Geheimorganisation/geheimbadge-hardware/assets/images/b2.png

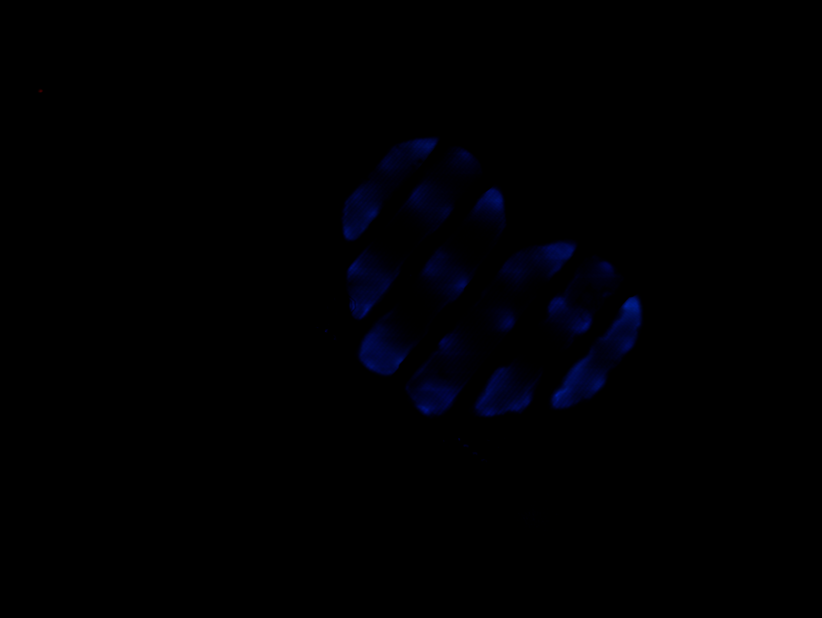
assets/images/b2.png
