Geheimorganisation/geheimbadge-hardware/assets/images/b6.png

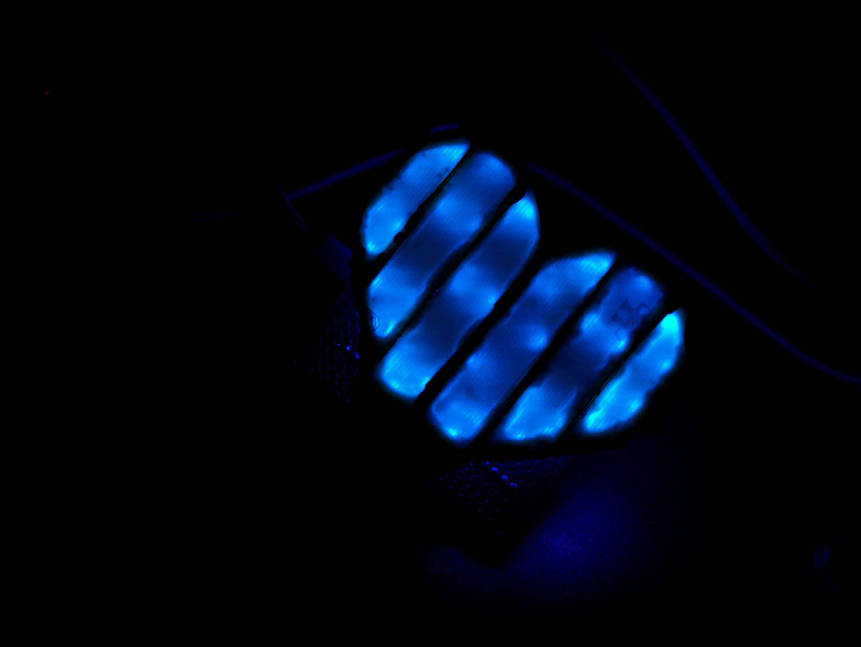
assets/images/b6.png
