Geheimorganisation/geheimbadge-hardware/assets/images/b7.png

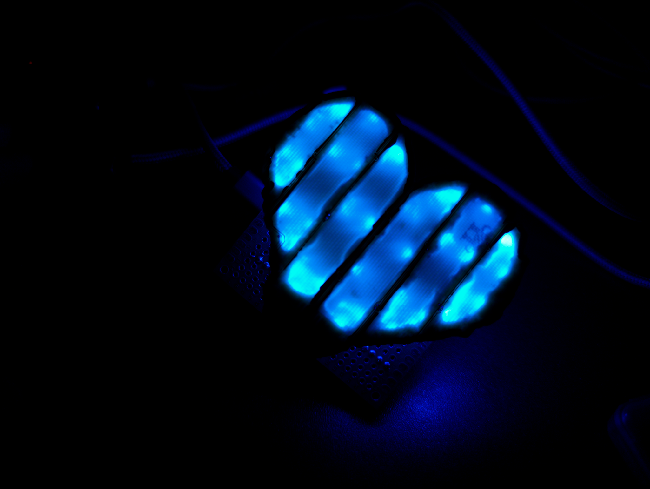
assets/images/b7.png
