Geheimorganisation/geheimbadge-hardware/assets/images/b8.png

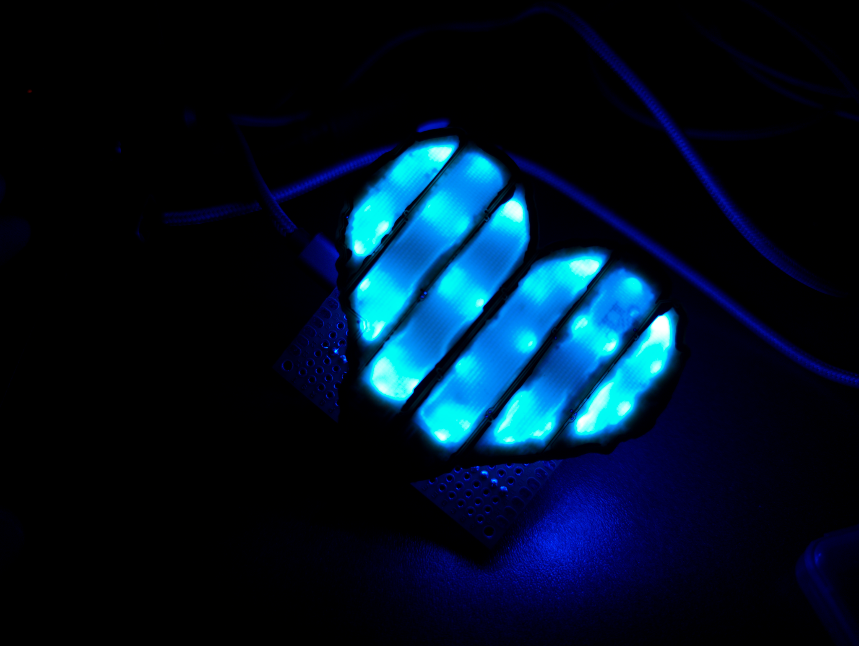
assets/images/b8.png
