Geheimorganisation/geheimbadge-hardware/assets/images/g1.png

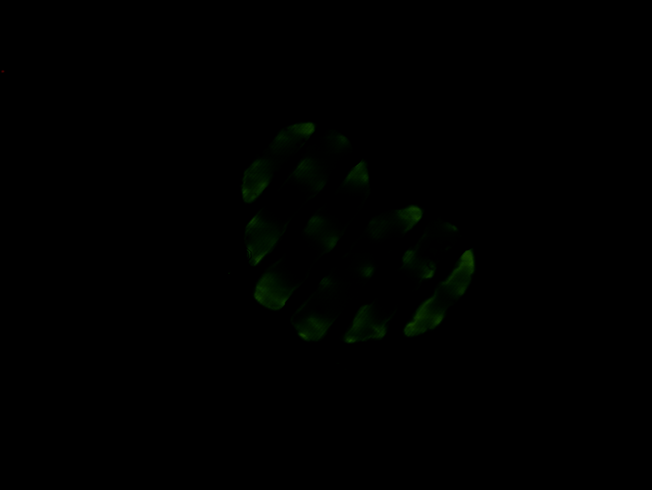
assets/images/g1.png
