Geheimorganisation/geheimbadge-hardware/assets/images/g4.png

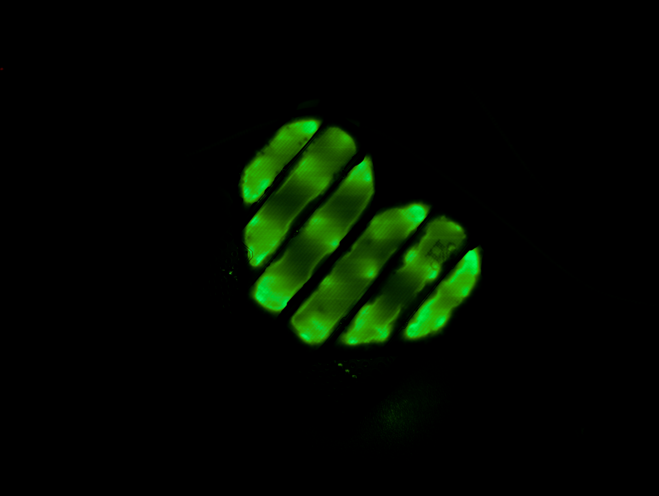
assets/images/g4.png
