Geheimorganisation/geheimbadge-hardware/assets/images/g6.png

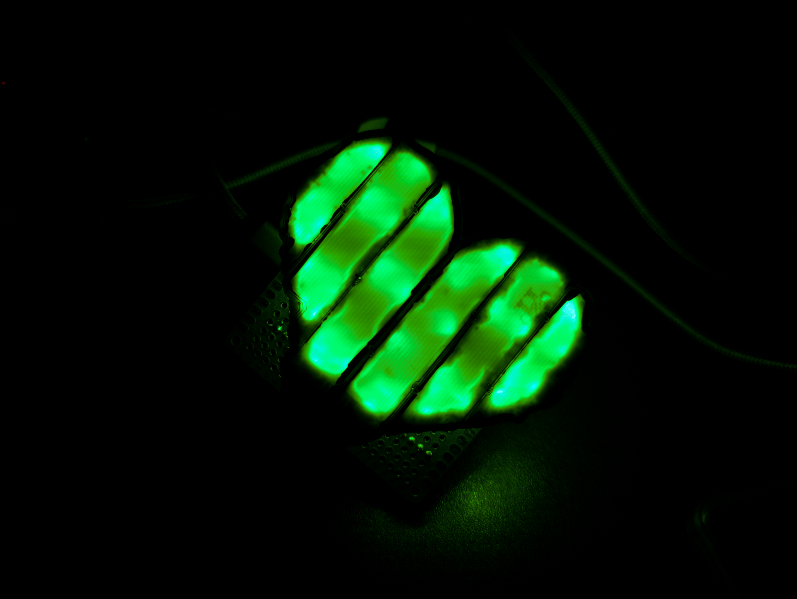
assets/images/g6.png
