Geheimorganisation/geheimbadge-hardware/assets/images/g7.png

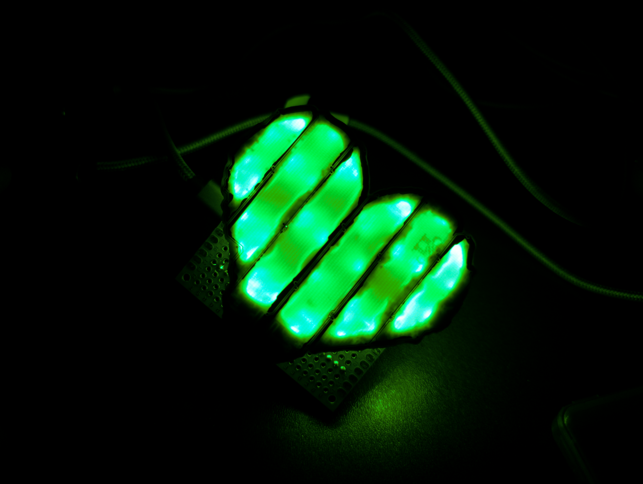
assets/images/g7.png
