Geheimorganisation/geheimbadge-hardware/assets/images/r3.png

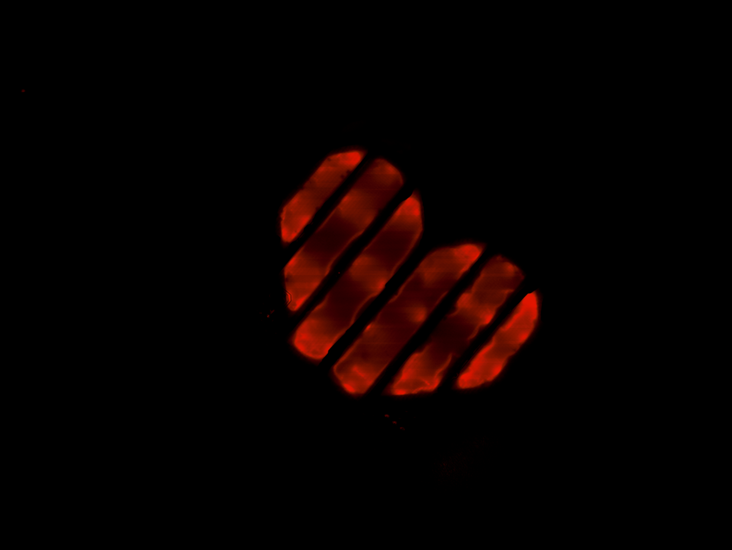
assets/images/r3.png
