Geheimorganisation/geheimbadge-hardware/assets/images/r5.png

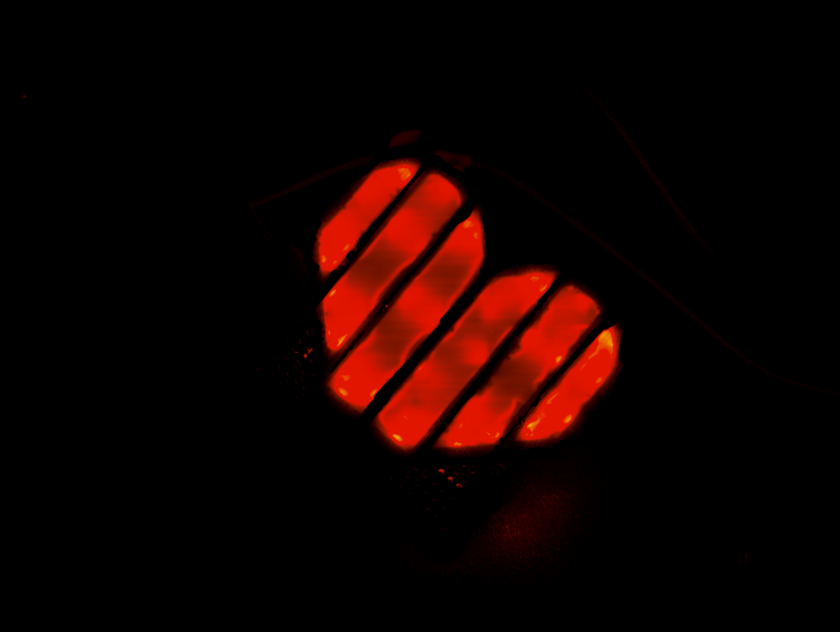
assets/images/r5.png
