Geheimorganisation/geheimbadge-hardware/assets/images/r6.png

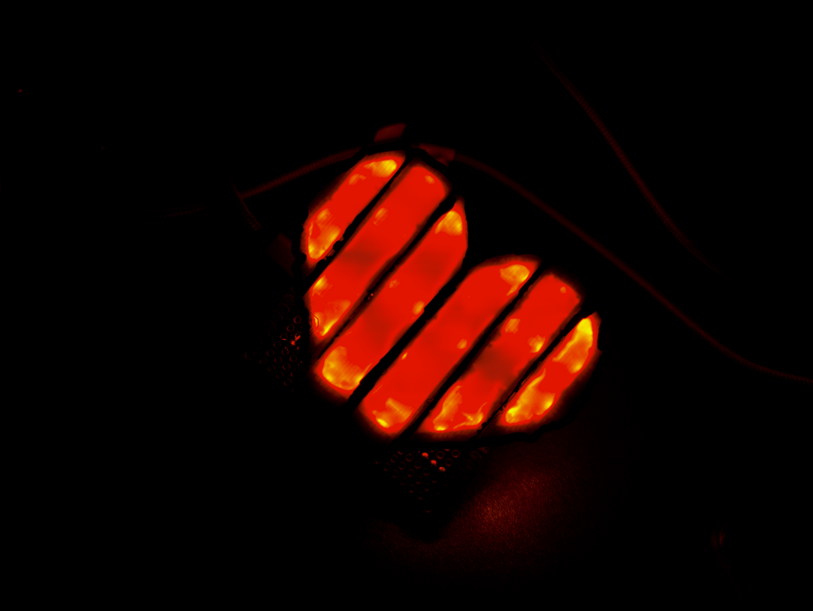
assets/images/r6.png
