Geheimorganisation/geheimbadge-hardware/assets/images/r7.png

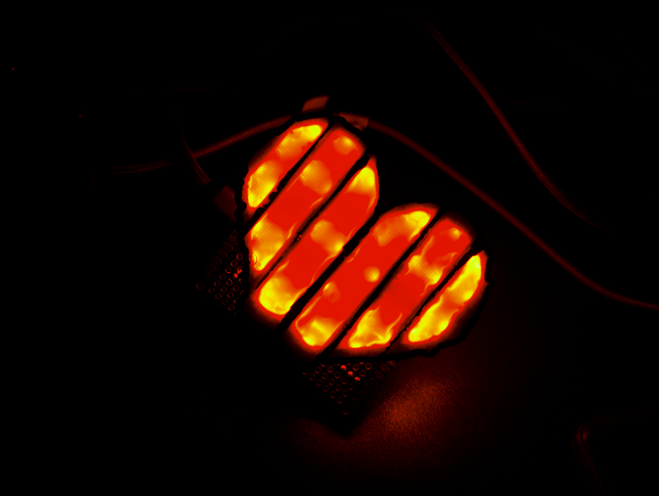
assets/images/r7.png
