Geheimorganisation/geheimbadge-hardware/assets/images/r8.png

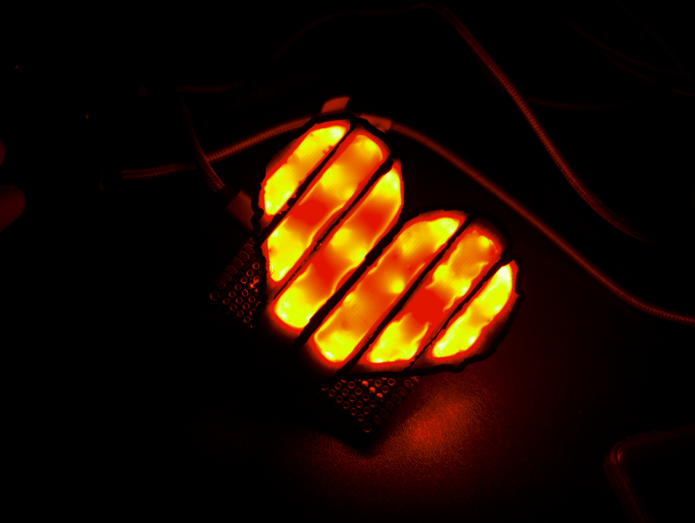
assets/images/r8.png
