Geheimorganisation/geheimbadge-hardware/production/bom/geheimbadge.csv

Designator | Footprint | Quantity | Value | LCSC Part #
J1 | Connector_IDC:IDC-Header_2x03_P2.54mm_Vertical_SMD | 1 | SAOv2 | C4749176
C1,C2,C3,C4,C5,C6,C7,C8,C9,C10,C11,C12,C13,C14,C15,C16,C17,C18,C19,C20,C21,C22,C23,C24,C25,C26,C27,C28,C29,C30,C31,C32,C33,C34,C35,C36,C37,C38 | Capacitor_SMD:C_0402_1005Metric | 38 | 100n | C1525
D1,D2,D3,D4,D5,D6,D7,D8,D9,D10,D11,D12,D13,D14,D15,D16,D17,D18,D19,D20,D21,D22,D23,D24,D25,D26,D27,D28,D29,D30,D31,D32,D33,D34,D35,D36,D37,D38 | LED_SMD-project:LED-SMD_4P-L4.0-W1.6-L | 38 | SK6812SIDE | C5378721
