Geheimorganisation/geheimbadge-hardware/assets/3D models/shell.stl

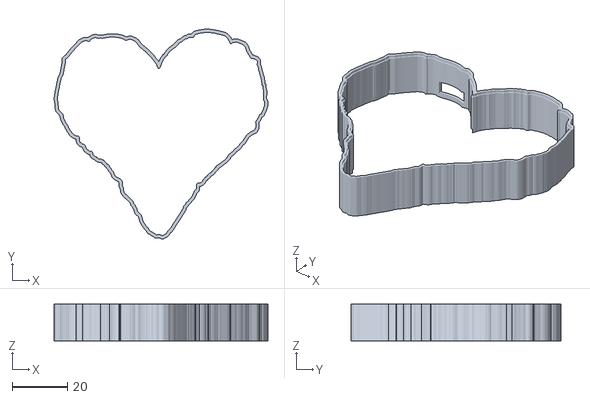
[picture p14: CAD file, 2024-12-30]
assets/3D models/shell.stl
77.5 x 76.1 x 13.4
