Geheimorganisation/geheimbadge-hardware/source/geheimbadge-controller/mask.dxf

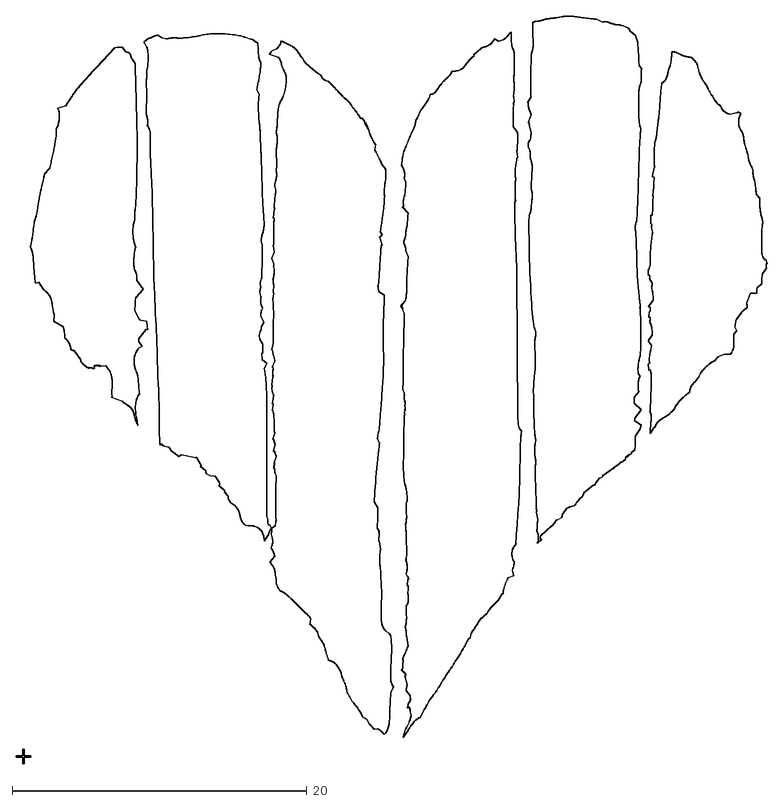
[picture p15: CAD file, 2023-10-01]
source/geheimbadge-controller/mask.dxf
51.0 x 50.8
