Geheimorganisation/geheimbadge-hardware/assets/3D models/LED-SMD_4P-L4.0-W1.6-L.obj

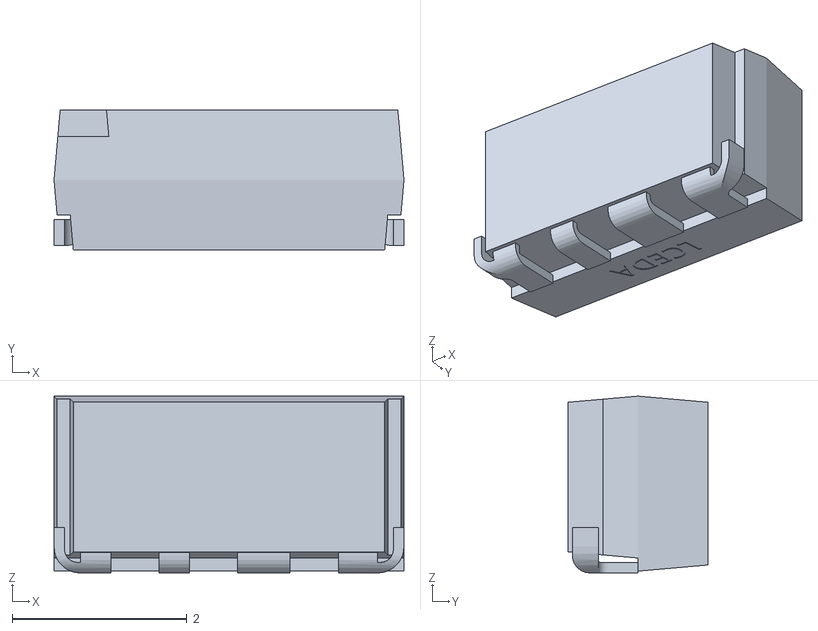
[picture p16: CAD file, 2023-10-01]
assets/3D models/LED-SMD_4P-L4.0-W1.6-L.obj
4.00 x 1.60 x 2.02
