Geheimorganisation/geheimbadge-hardware/source/geheimbadge-controller/outline.dxf

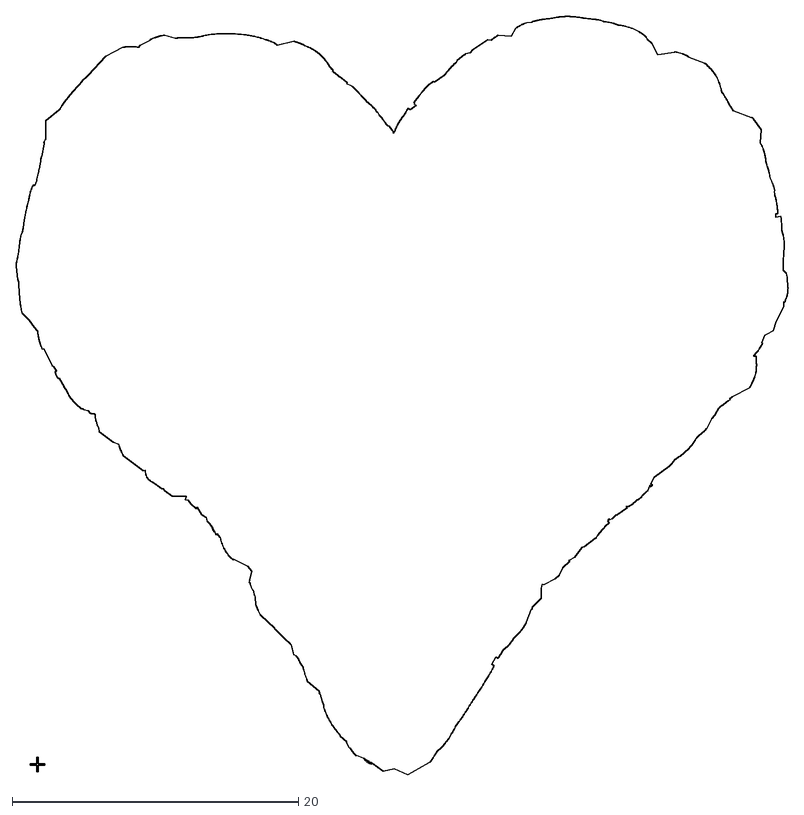
[picture p17: CAD file, 2023-10-01]
source/geheimbadge-controller/outline.dxf
53.9 x 53.0
