Geheimorganisation/geheimbadge-hardware/exports/plots/geheimbadge-controller-pcb.pdf

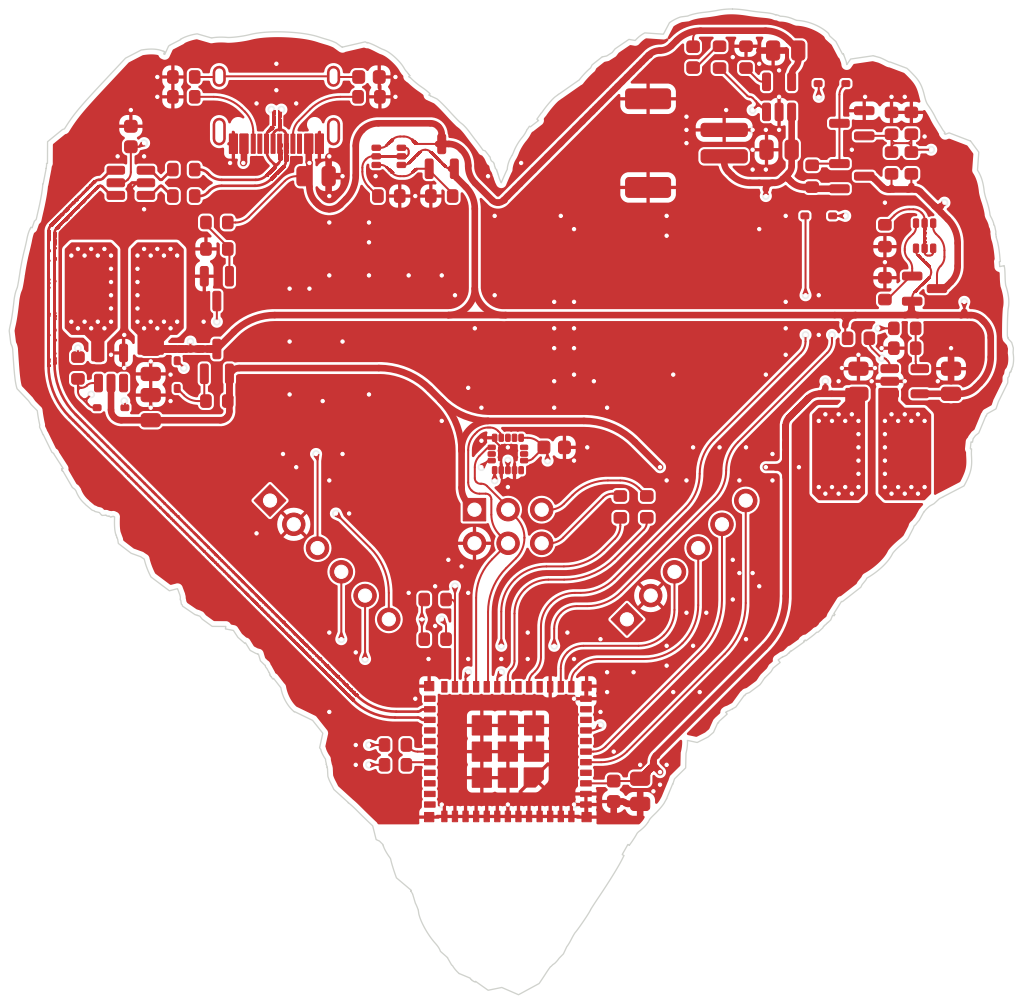
[picture p18: page 1]
D Date: KiCad; E.D.A. 8.99.0-77eaa75db1 Size: A4; Rev: 1.0.0; pid:; tba

author: marble
File: geheimbadge-controller.kicad_pcb Sheet: Geheimorganisation

Id: 1/1 Title: Geheimbadge

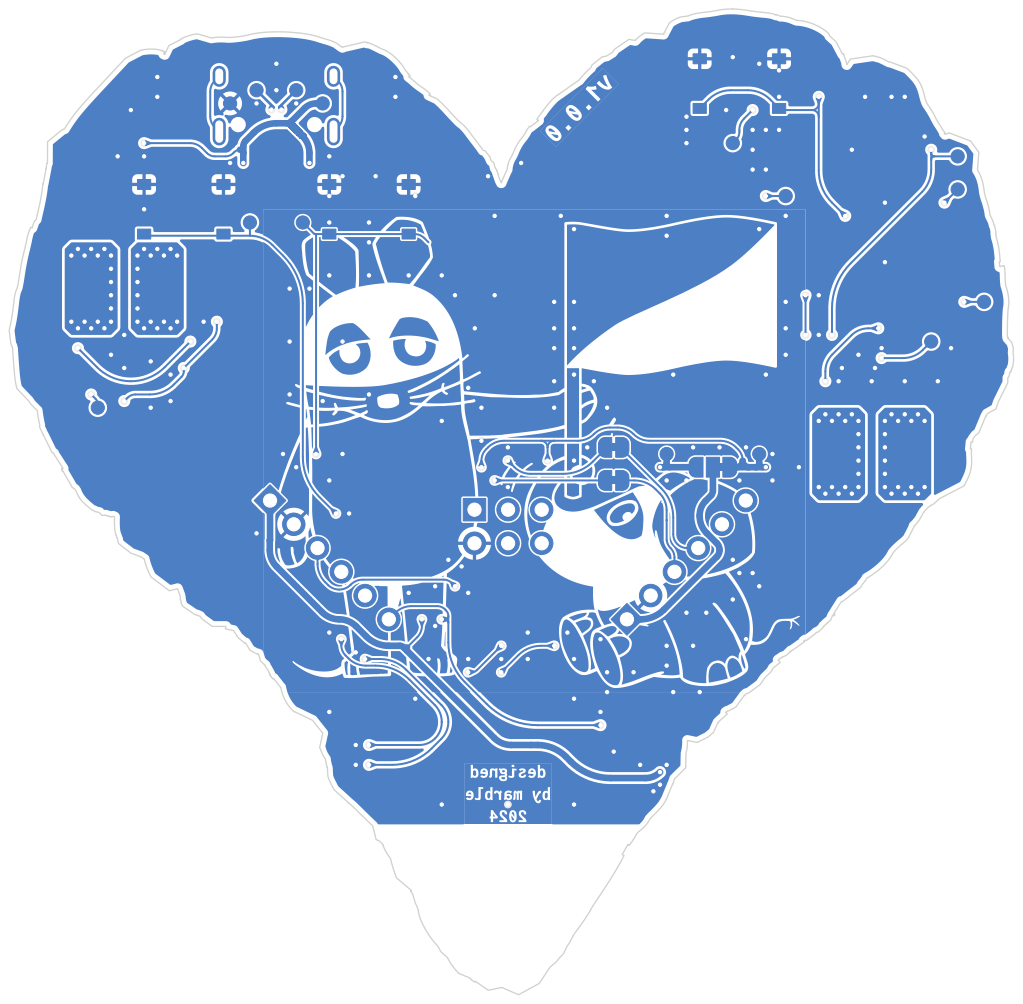
[picture p19: page 2]
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

author: marble
File: geheimbadge-controller.kicad_pcb Sheet: Geheimorganisation

Id: 1/1 Title: Geheimbadge
