Geheimorganisation/geheimbadge-hardware/exports/plots/geheimbadge-controller-sch.pdf

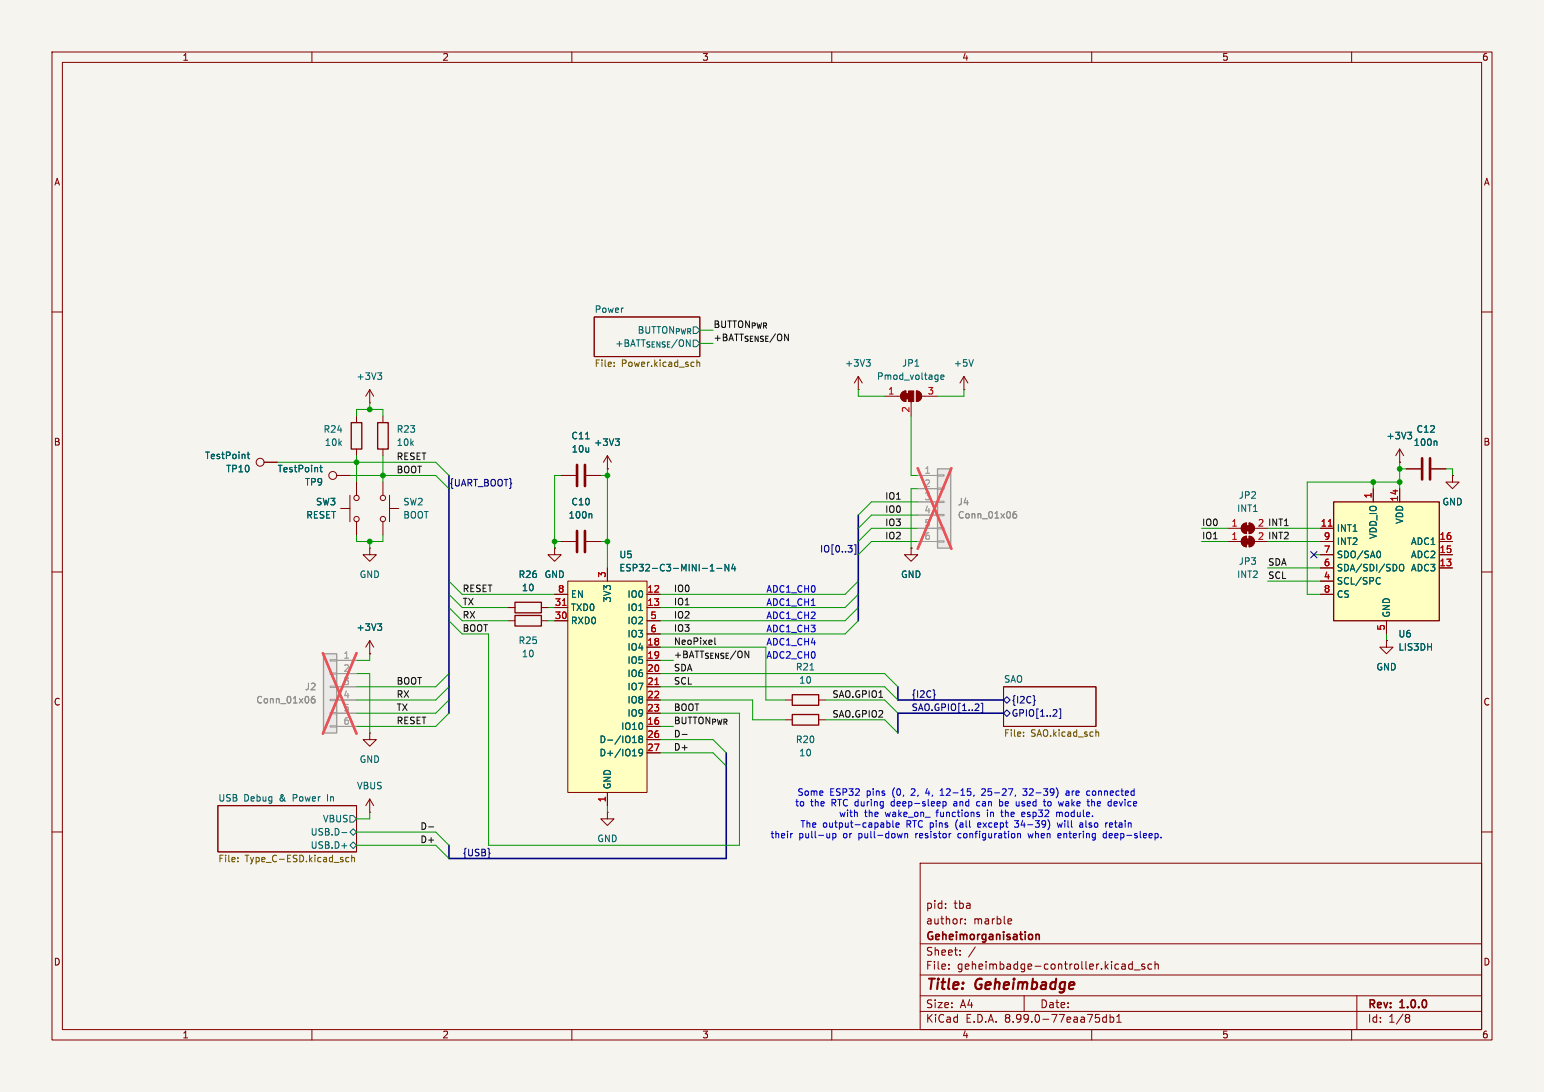
[picture p20: page 1]

5 SDA/SDI/SDO 6 SDO/SA0 7 CS 8

D+BUTTON_{PWR} SCL SDA NeoPixel TX

author: marble
File: geheimbadge-controller.kicad_sch Sheet: / Geheimorganisation

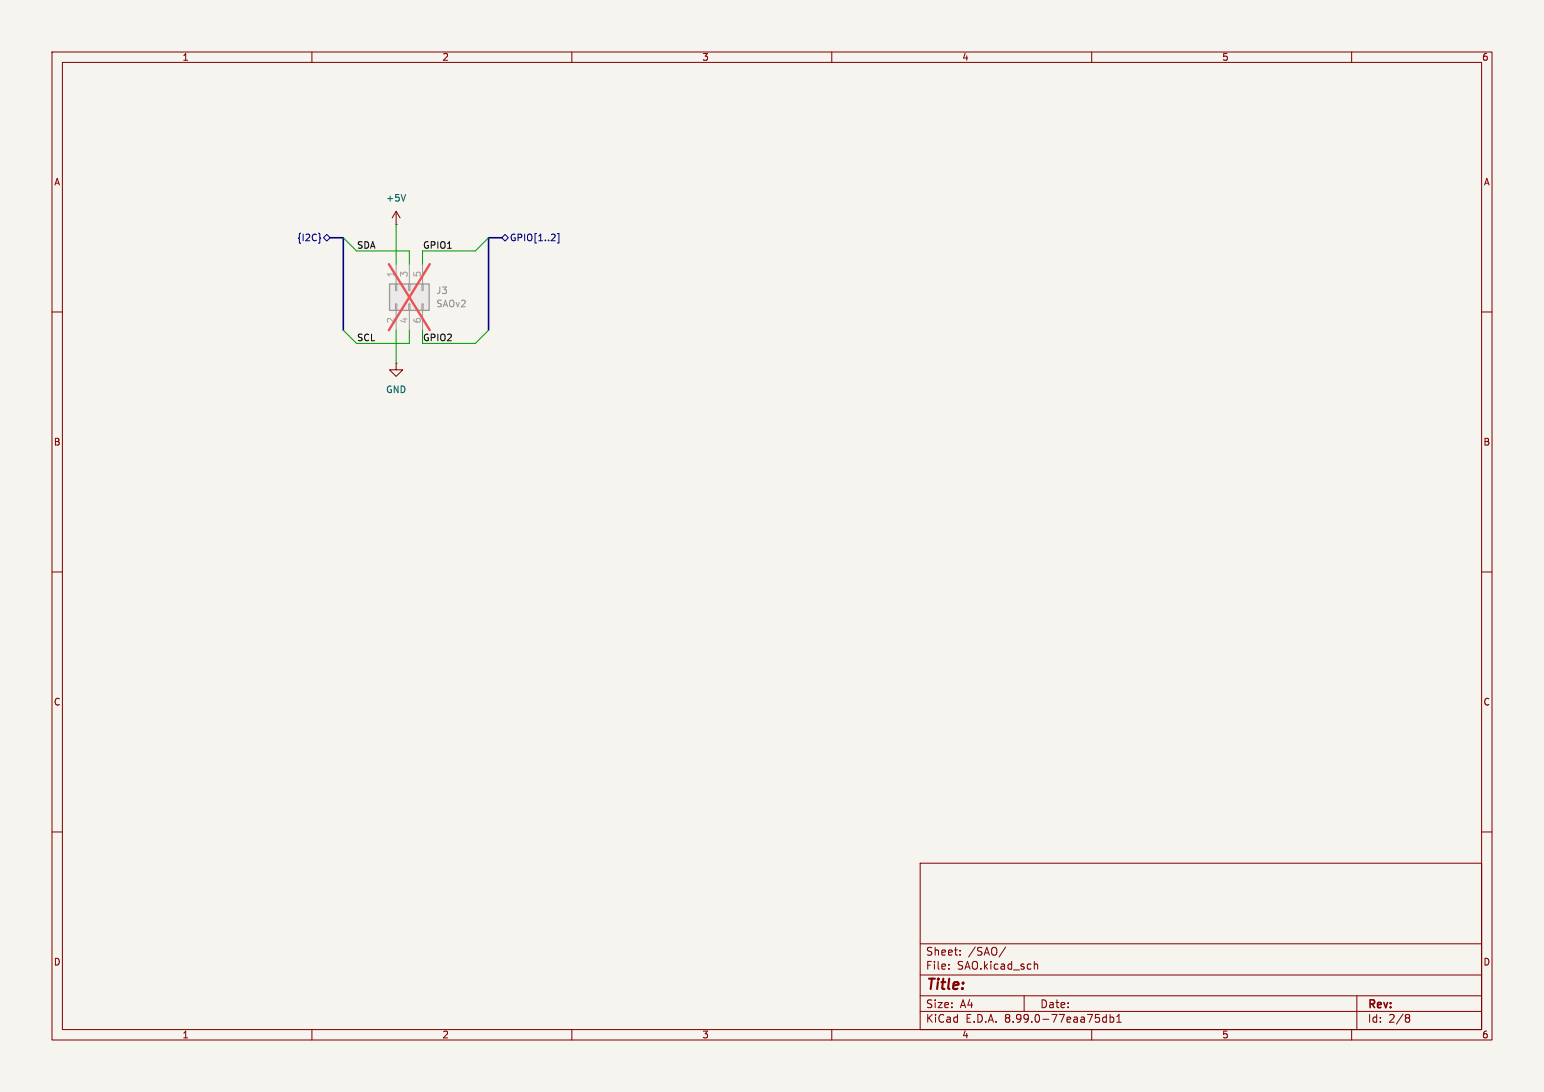
[picture p21: page 2]

Id: 2/8 Title: File: SAO.kicad_sch Sheet: /SAO/

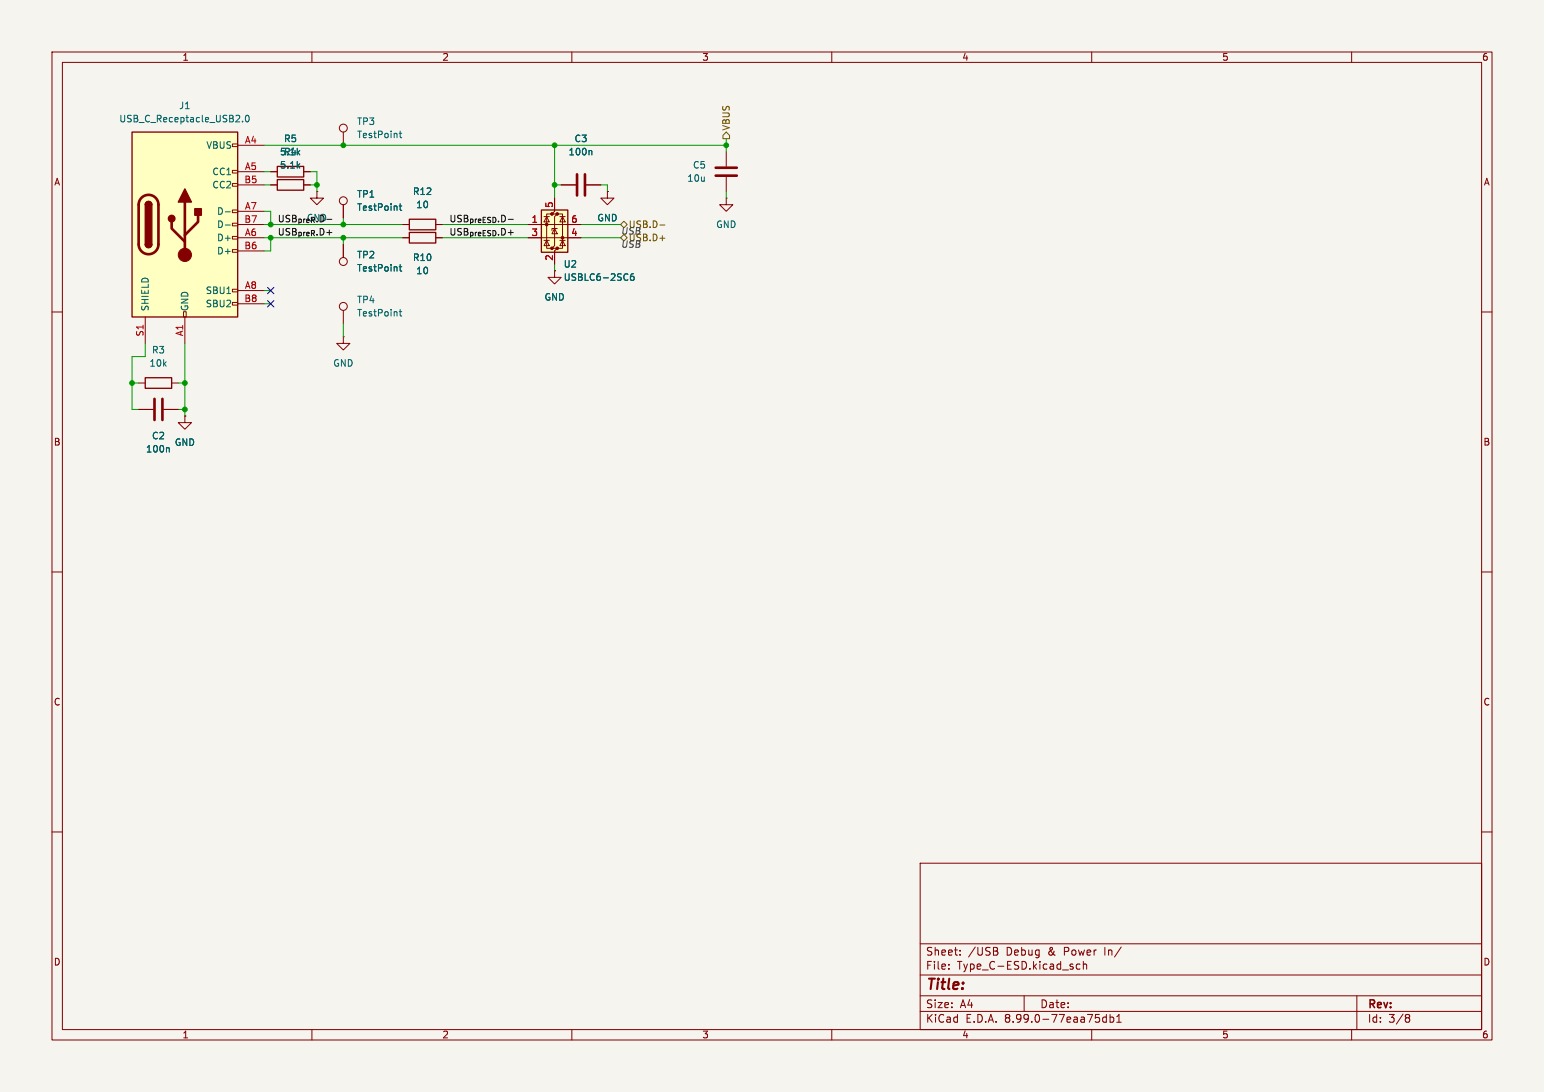
[picture p22: page 3]

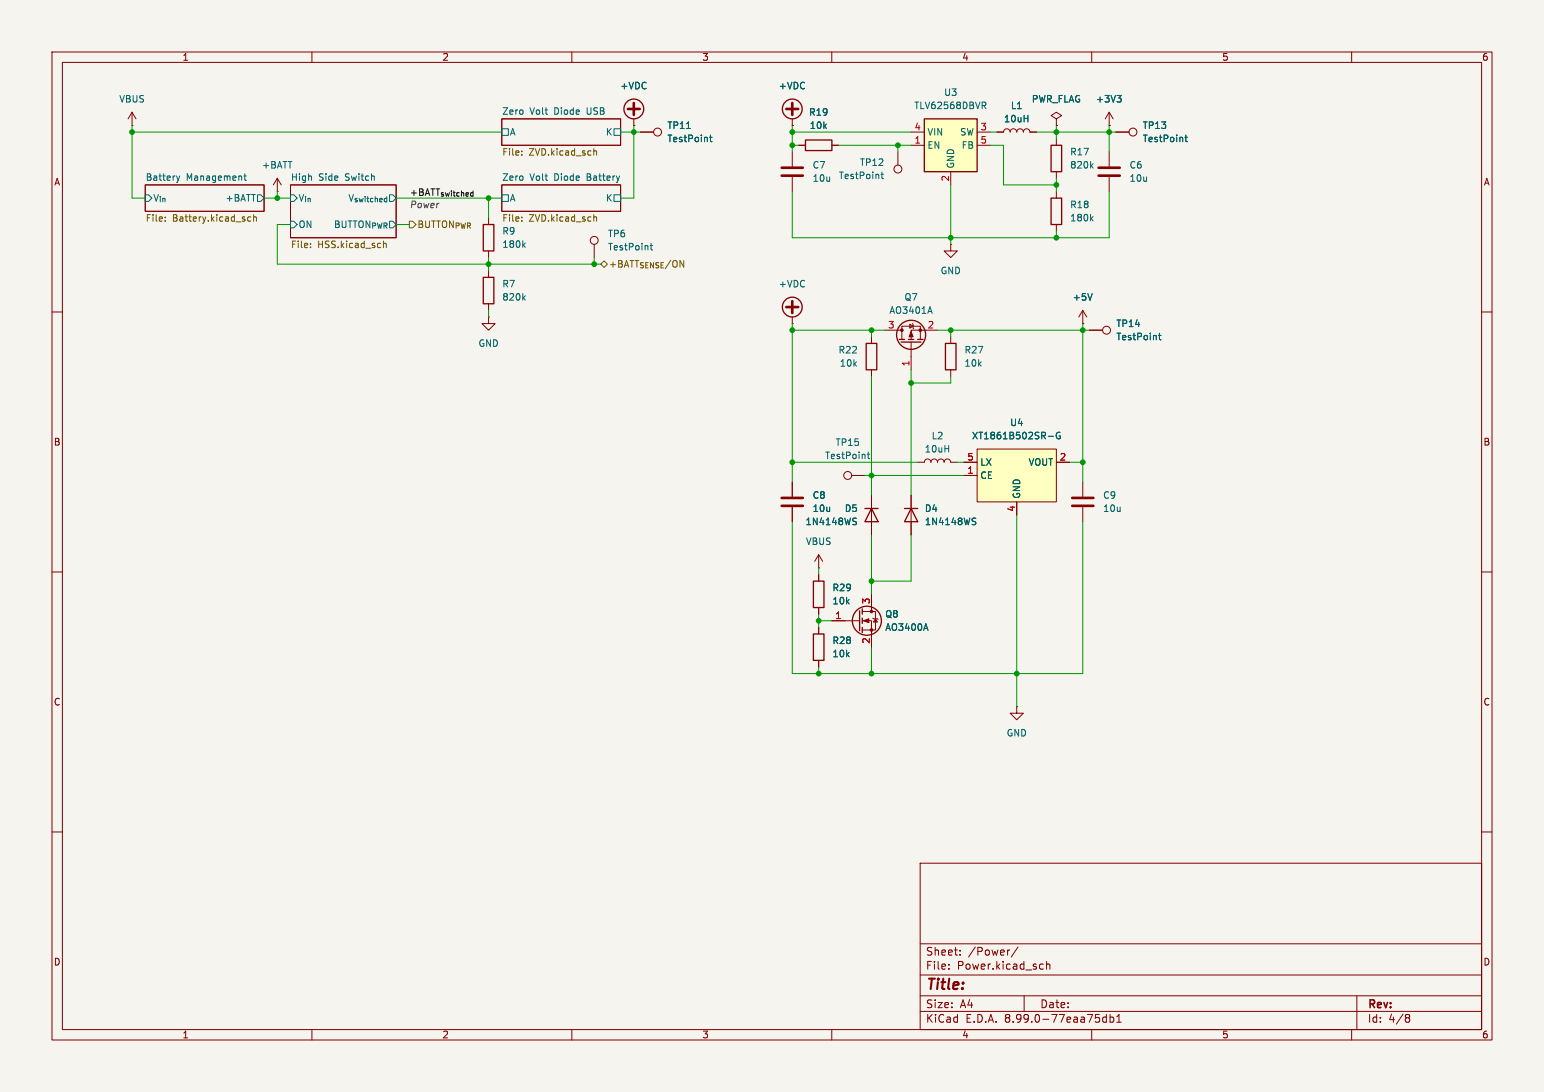
[picture p23: page 4]

Zero Volt Diode USB

Id: 4/8 Title: File: Power.kicad_sch Sheet: /Power/

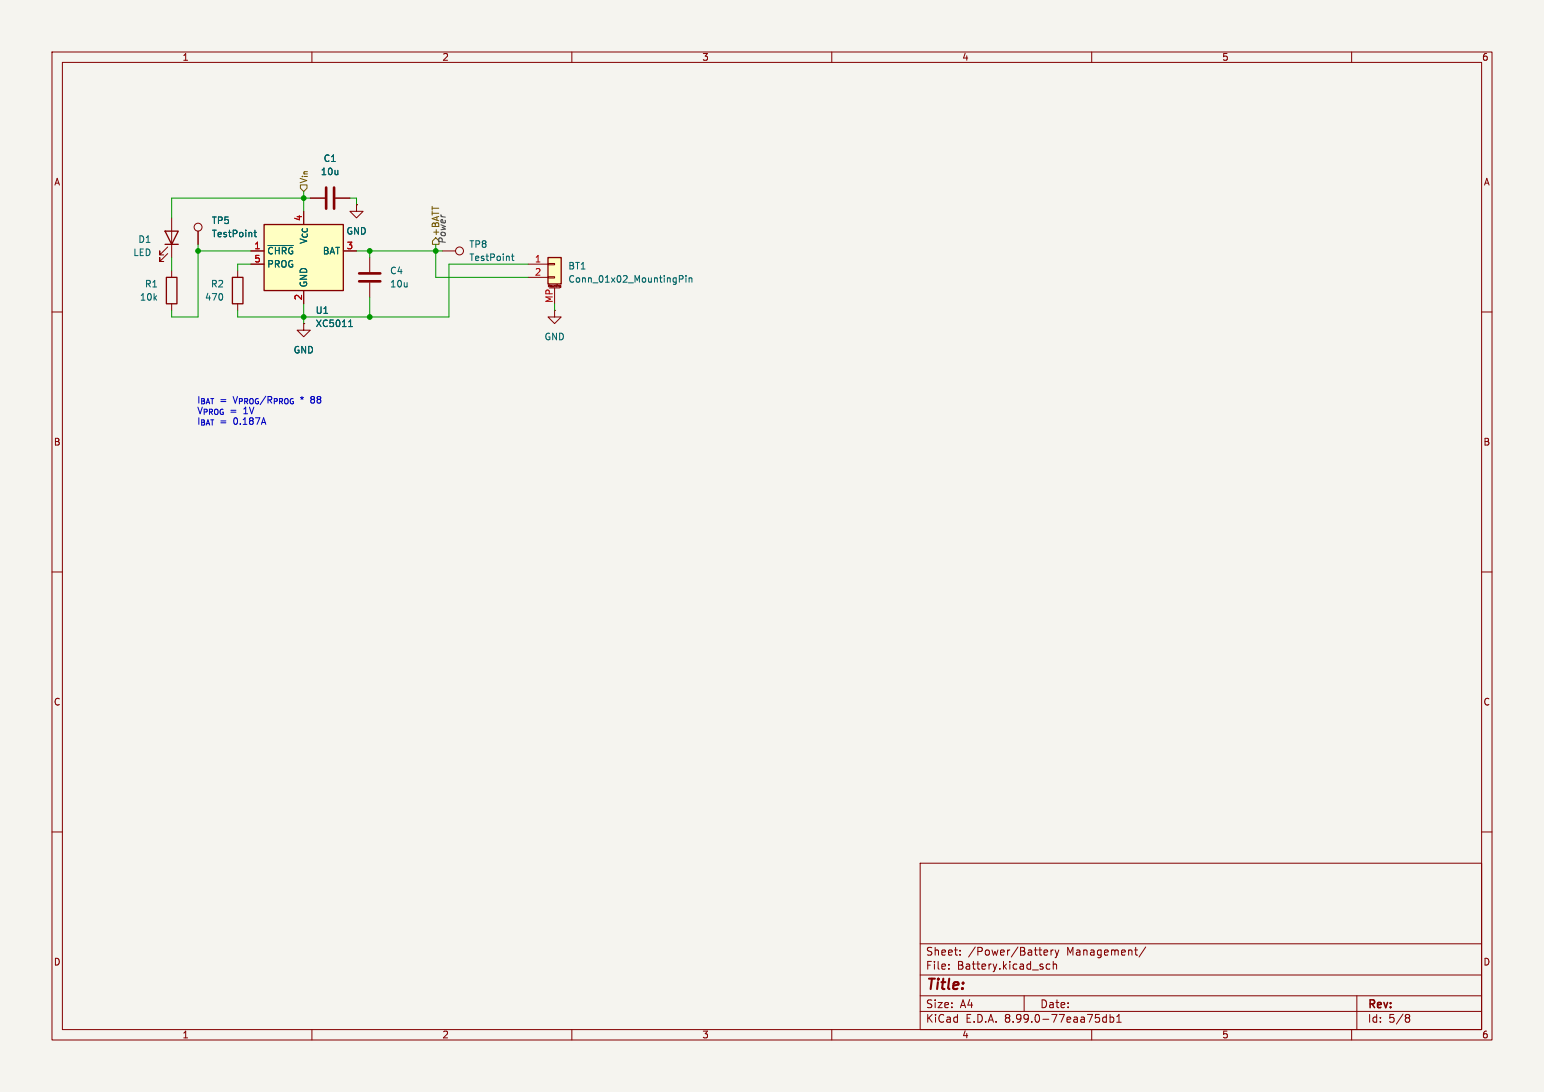
[picture p24: page 5]

2 BAT 3 V_{CC} 4 PROG 5 U1XC5011 TP8 TestPoint C4

2 BAT 3 V_{CC} 4 PROG 5 GND

I_{BAT} = V_{PROG}/R_{PROG} * 88 V_{PROG} = 1V

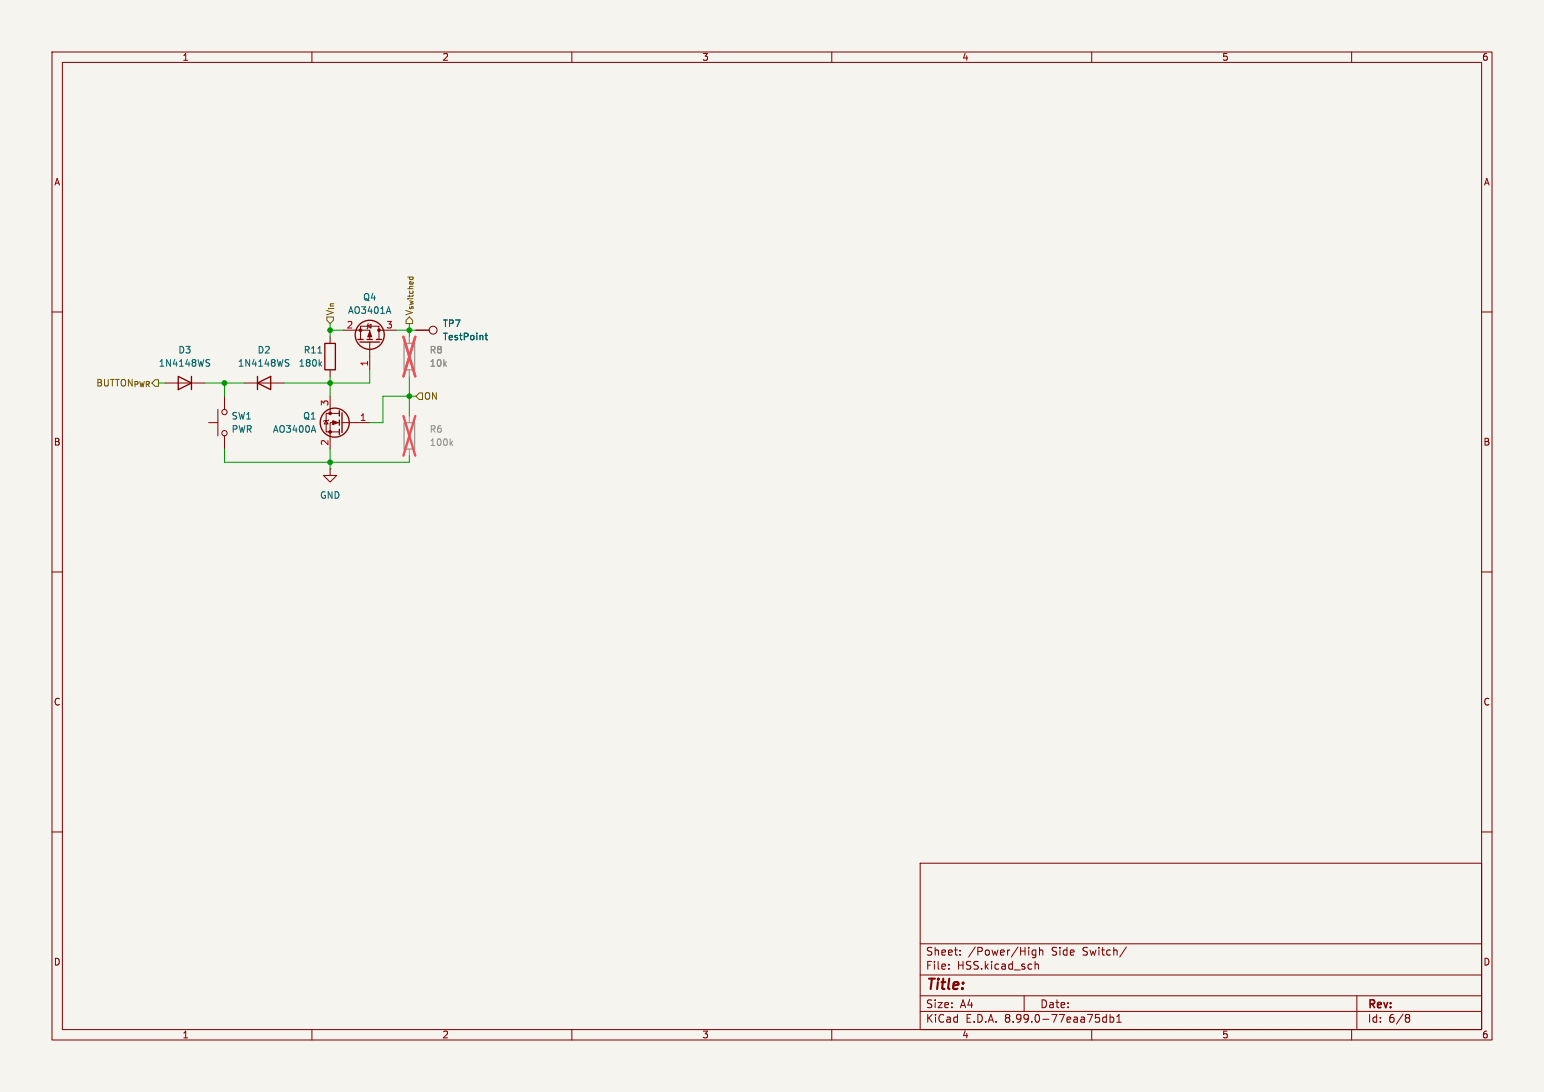
[picture p25: page 6]

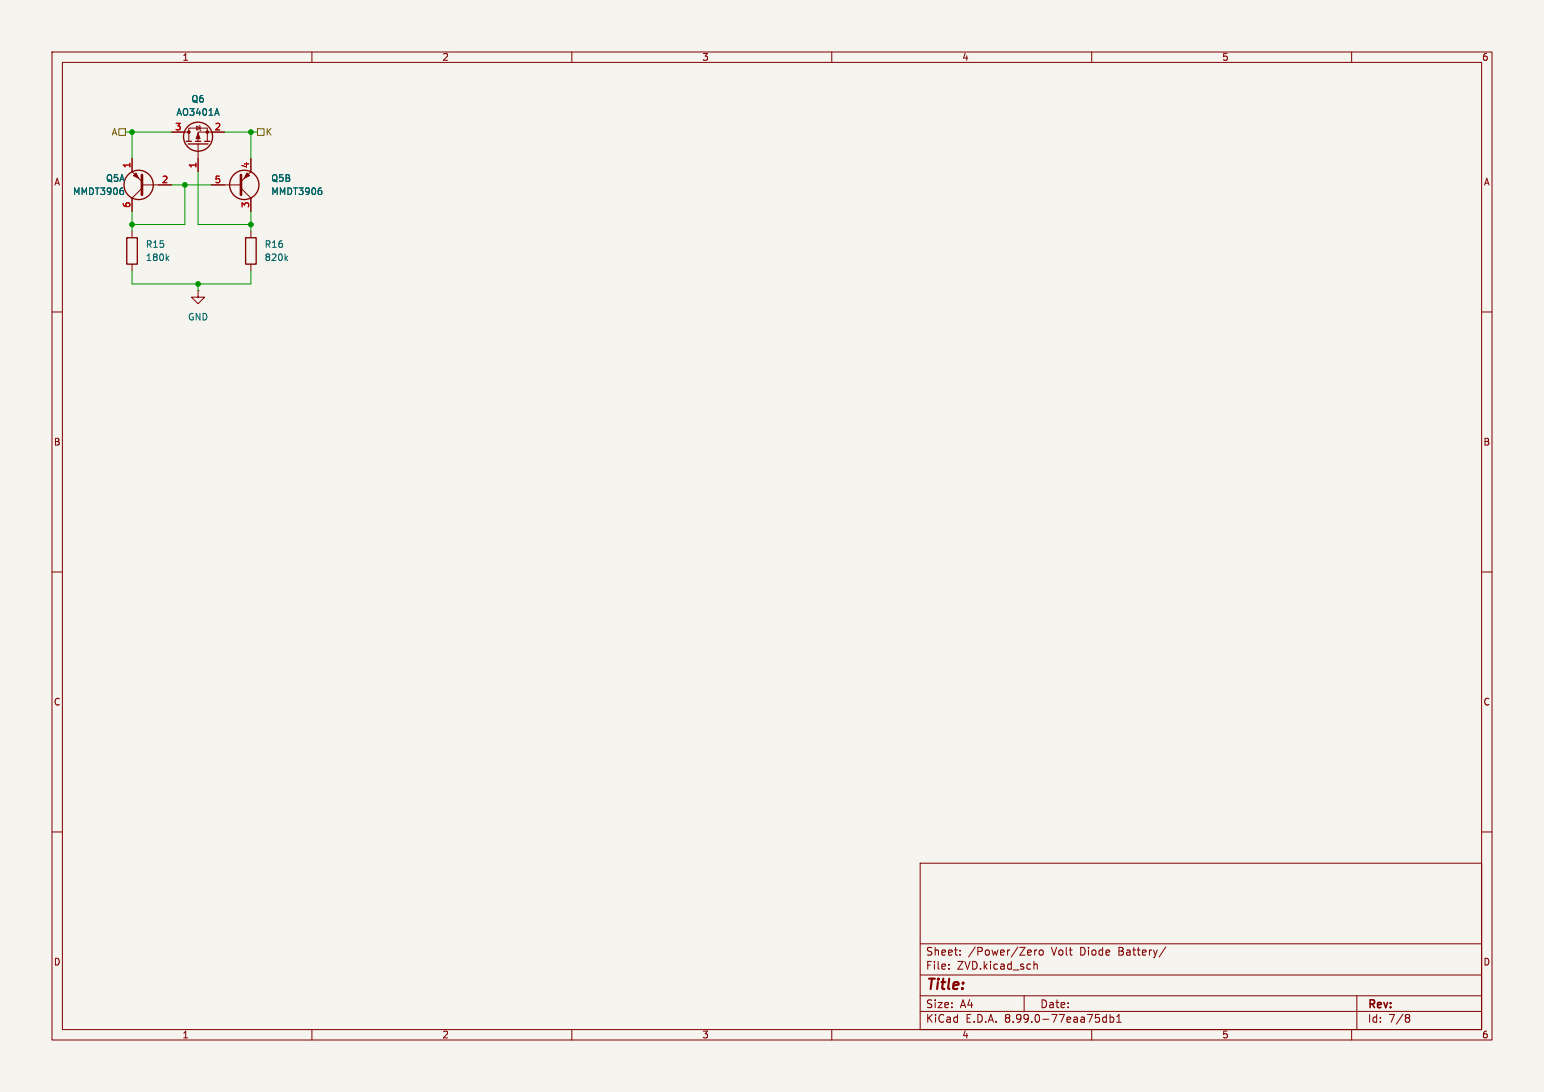
[picture p26: page 7]

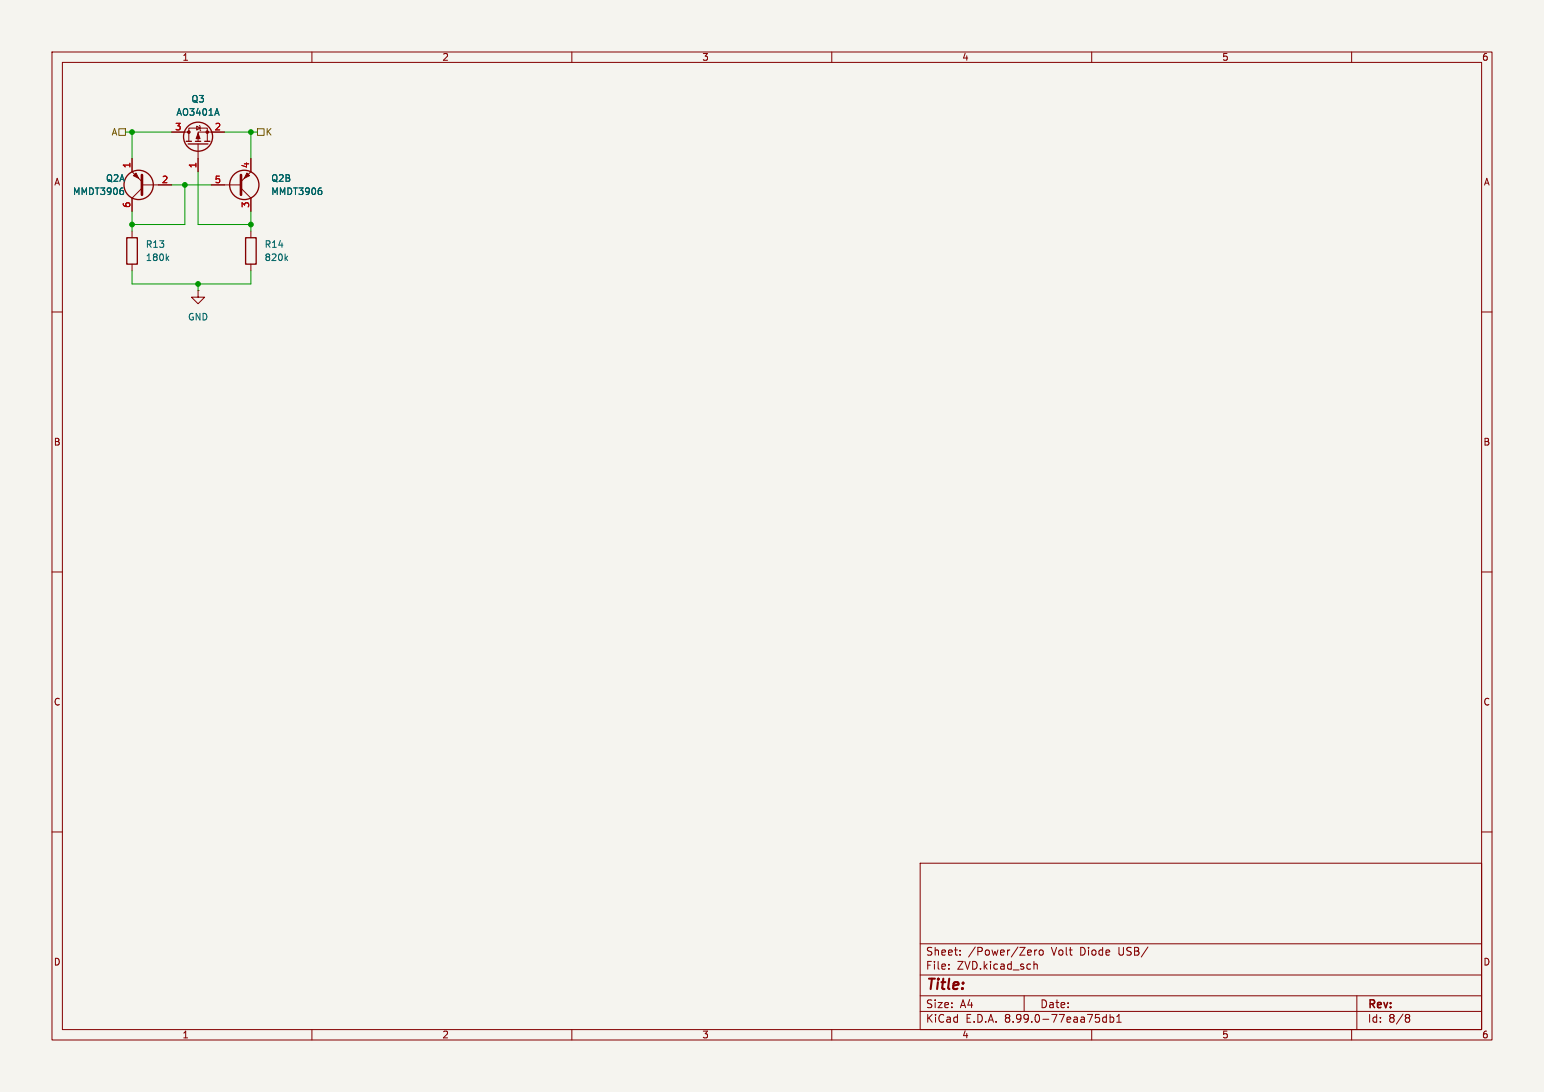
[picture p27: page 8]
