Geheimorganisation/geheimbadge-hardware/exports/plots/geheimbadge-pcb.pdf

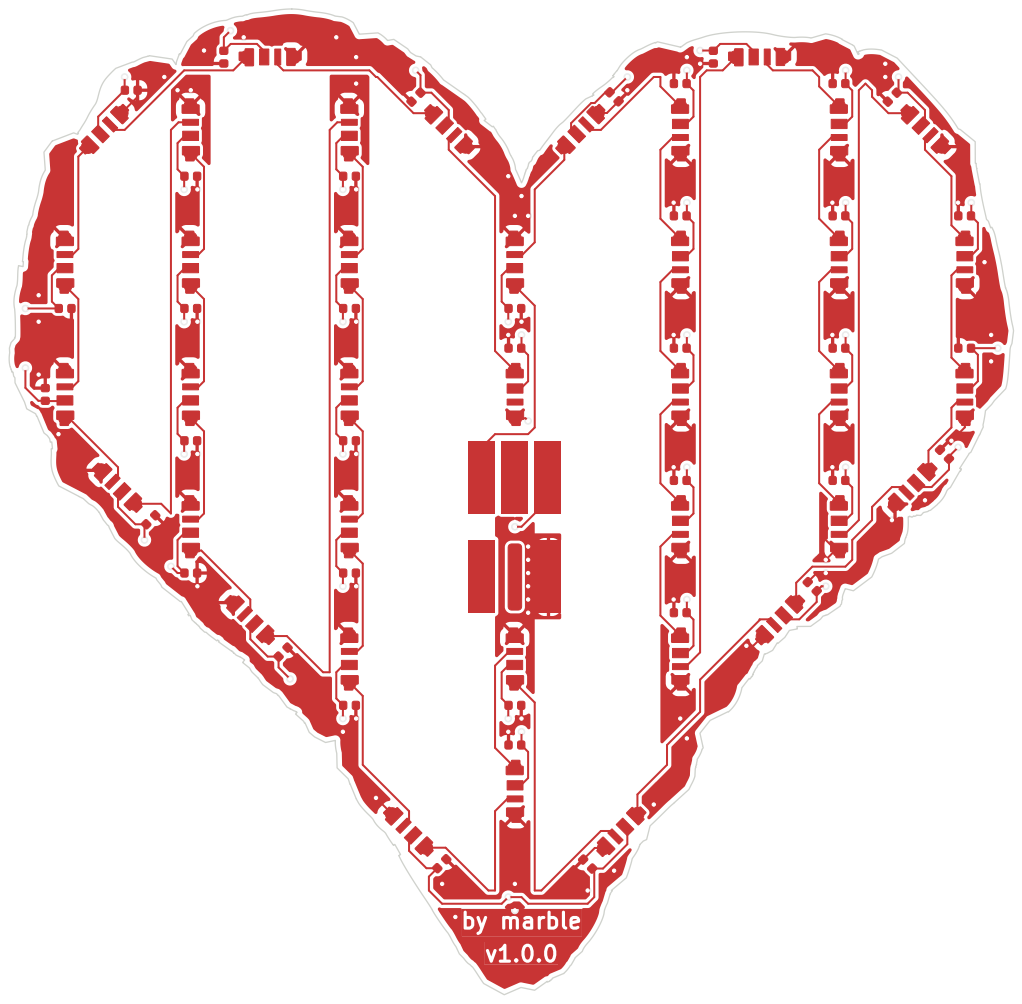
[picture p28: page 1]
D Date: KiCad; E.D.A. 8.99.0-77eaa75db1 Size: A4; Rev: 1.0.0; pid:; tba

author: marble
File: geheimbadge.kicad_pcb Sheet: Geheimorganisation

Id: 1/1 Title: Geheimbadge

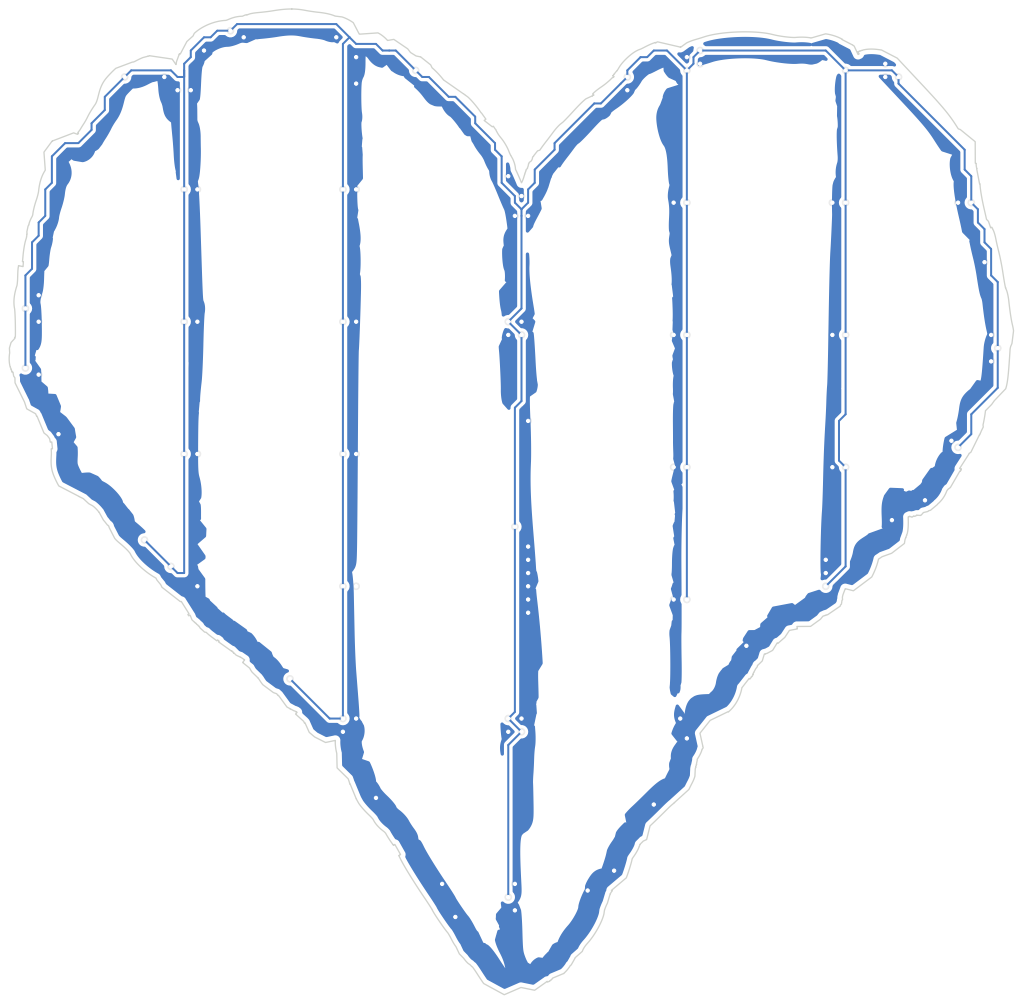
[picture p29: page 2]
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

author: marble
File: geheimbadge.kicad_pcb Sheet: Geheimorganisation

Id: 1/1 Title: Geheimbadge
