Geheimorganisation/geheimbadge-hardware/exports/plots/template-pcb.pdf

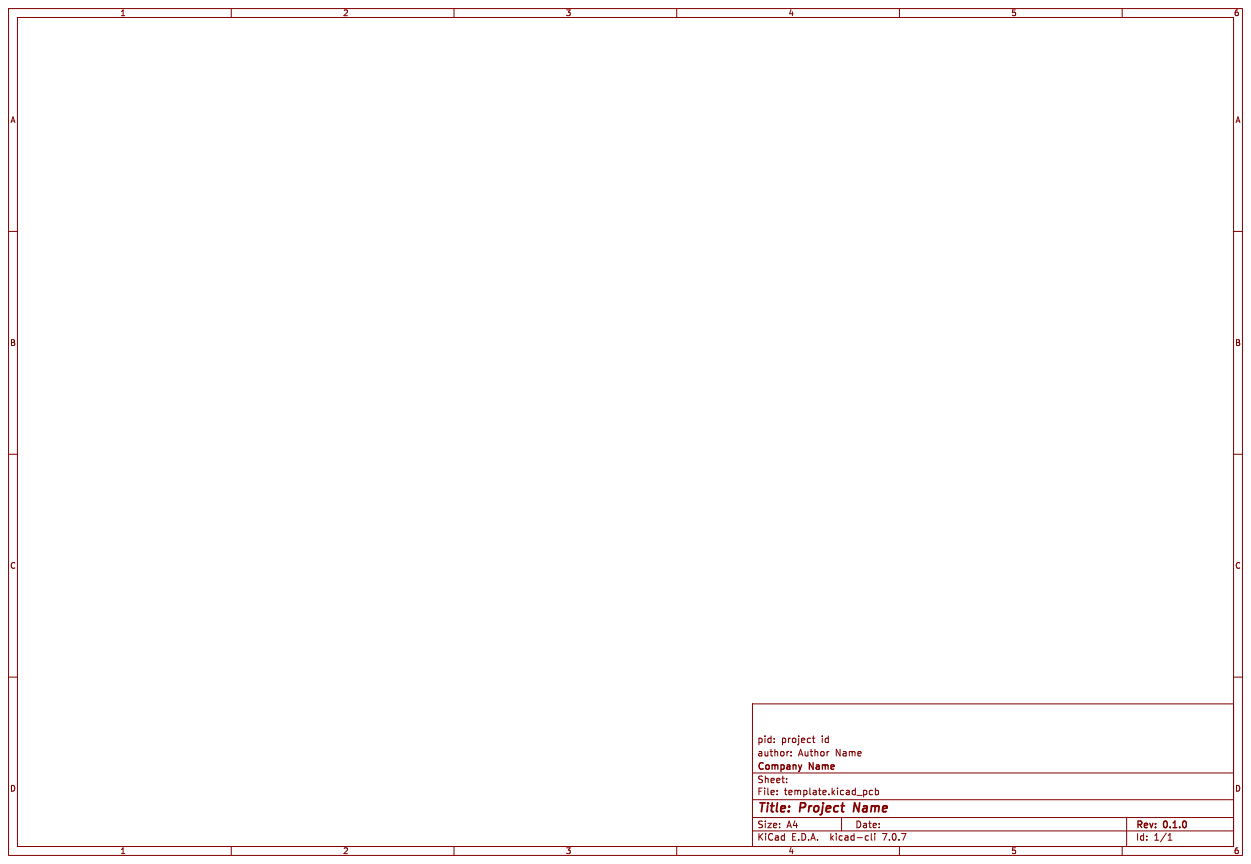
[picture p30: page 1]
D Date: KiCad; kicad-cli; 7.0.7 Size: A4; Rev: 0.1.0; File: template.kicad_pcb Sheet: Company; Name; author: Author; pid:; project id

Id: 1/1 Title: Project Name

Id: 1/1 Title: Project Name
