Geheimorganisation/geheimbadge-hardware/exports/plots/geheimbadge-sch.pdf

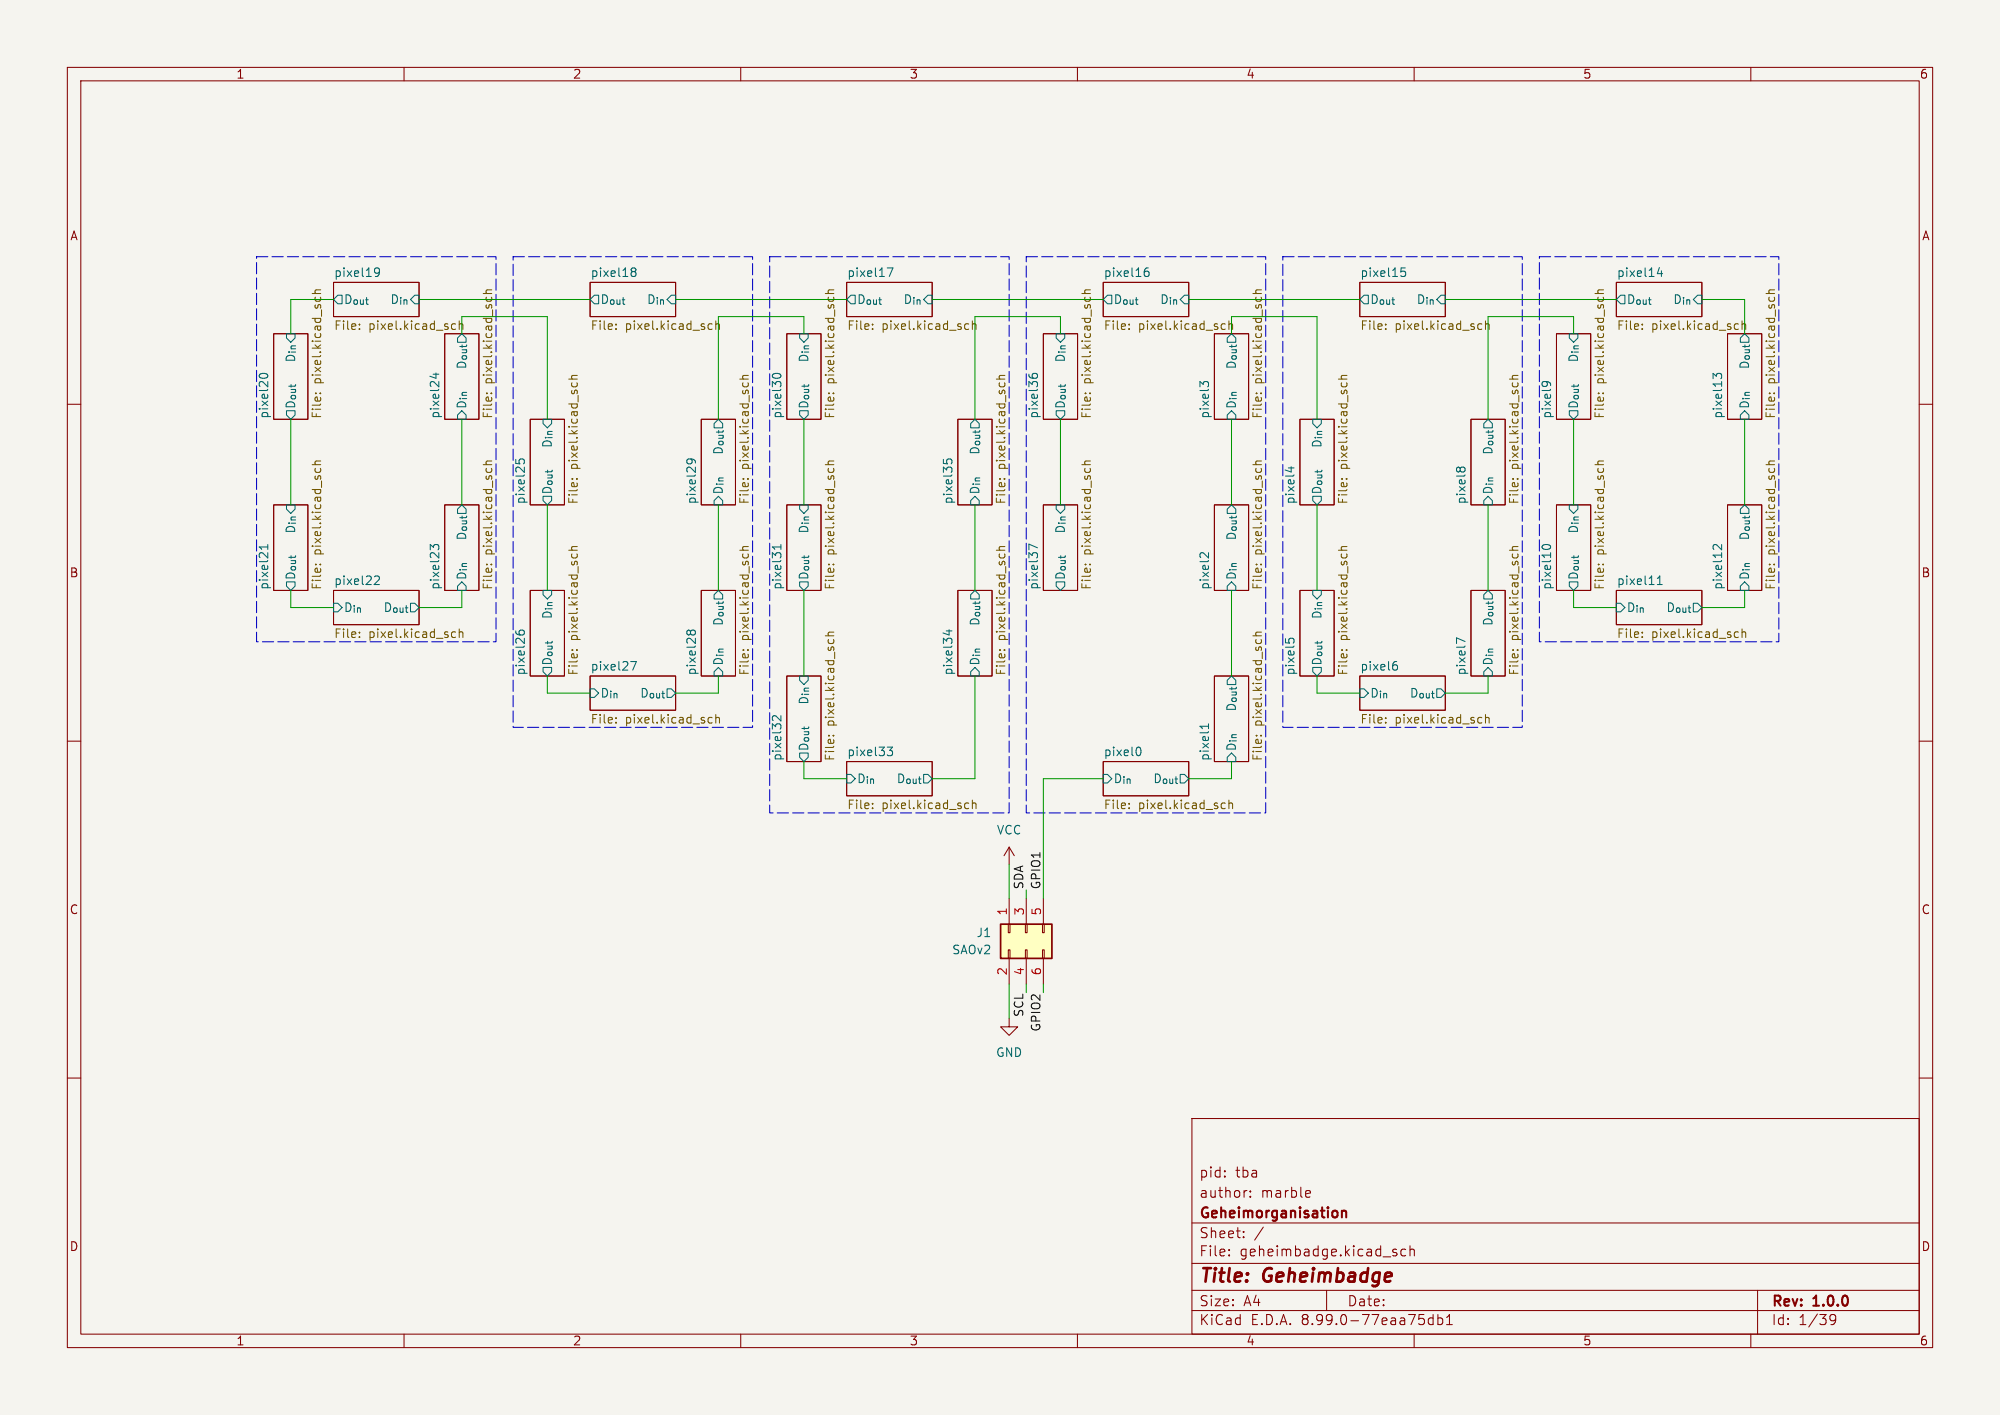
[picture p31: page 1]

author: marble
File: geheimbadge.kicad_sch Sheet: / Geheimorganisation

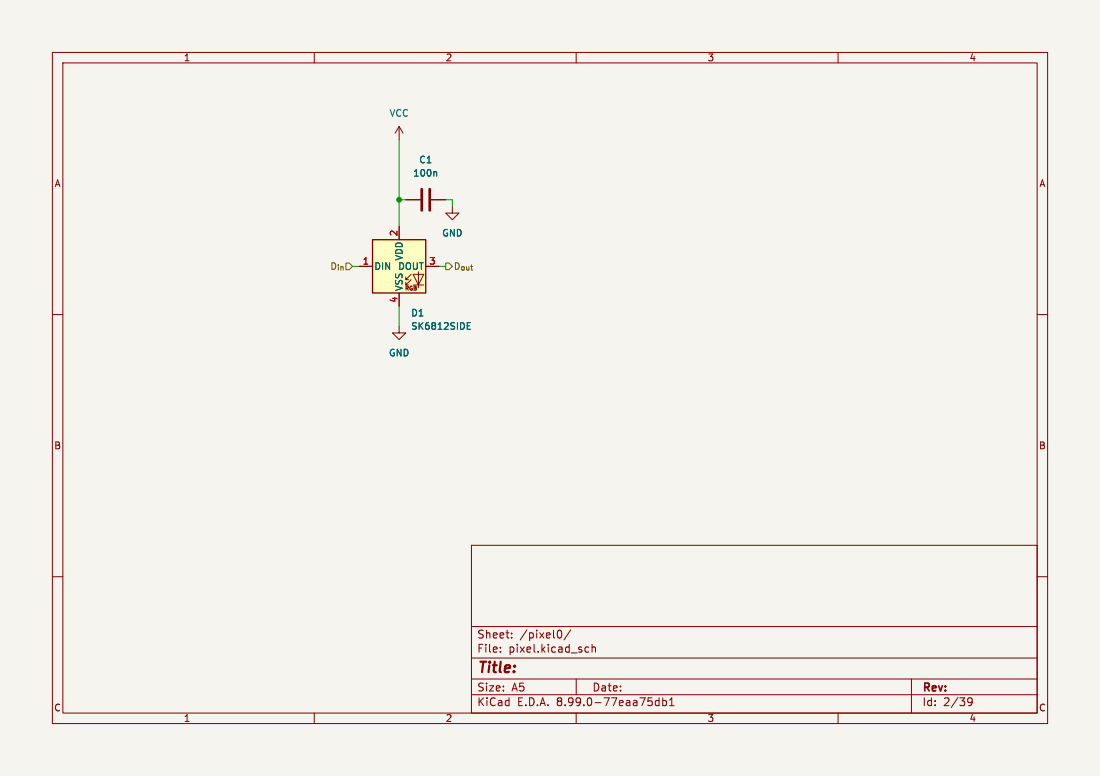
[picture p32: page 2]

VCC

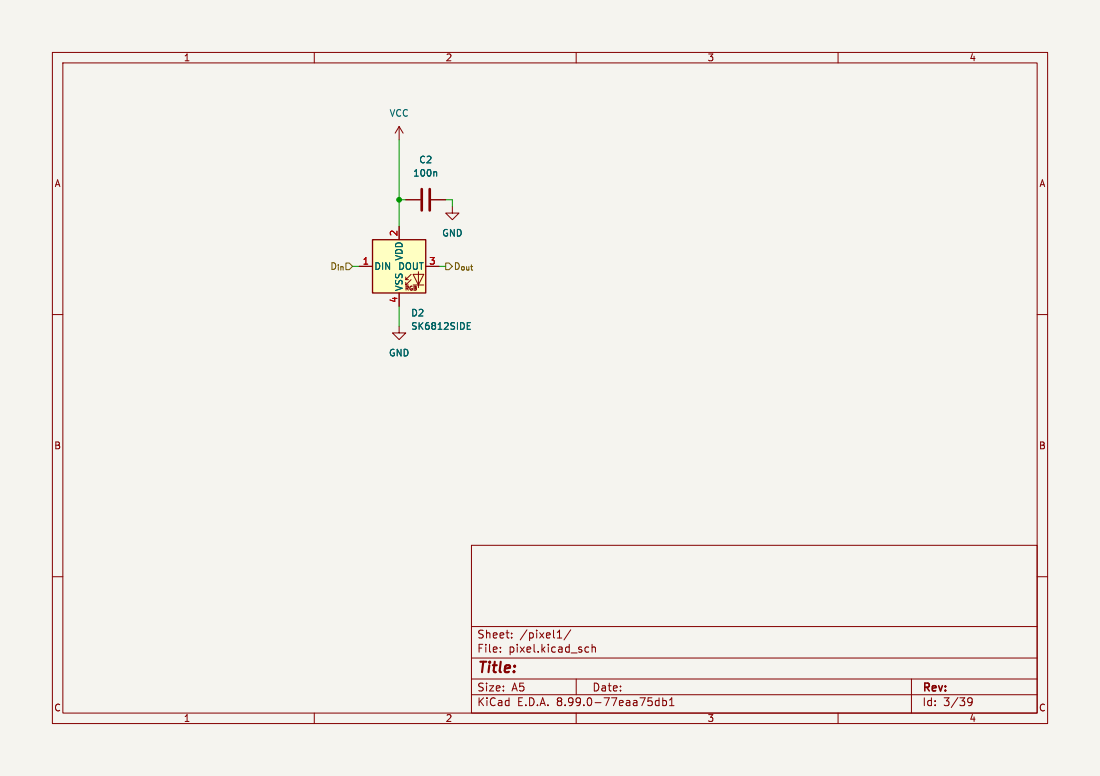
[picture p33: page 3]

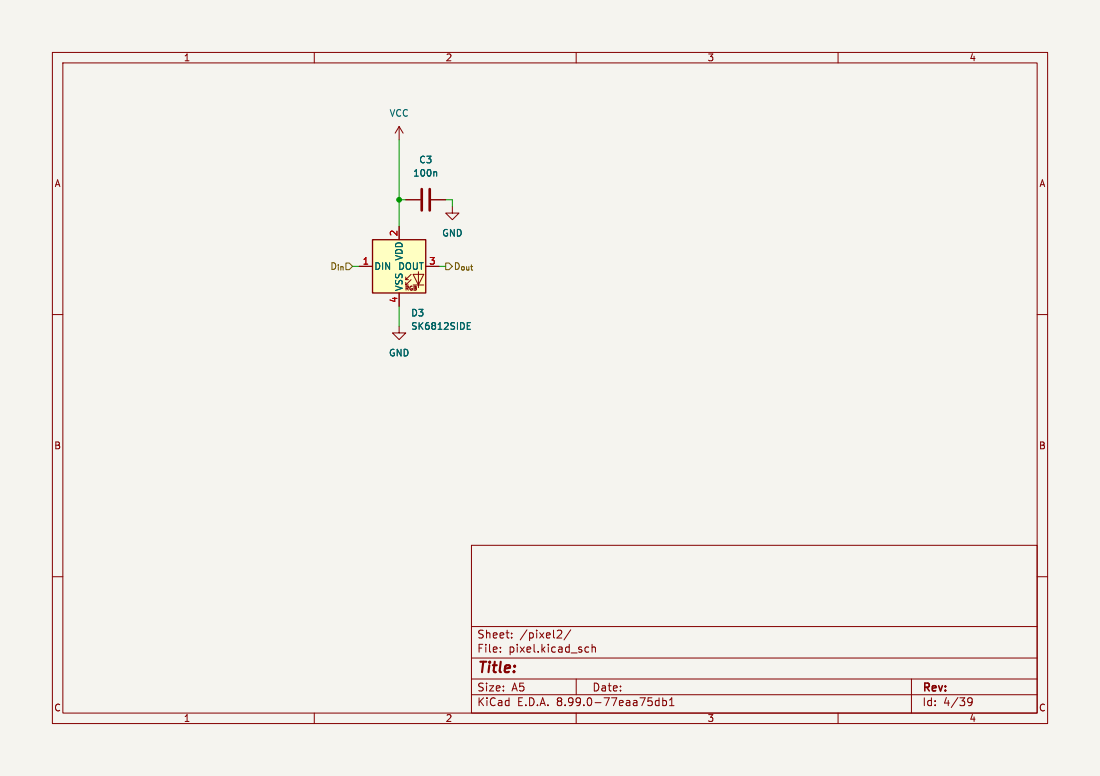
[picture p34: page 4]

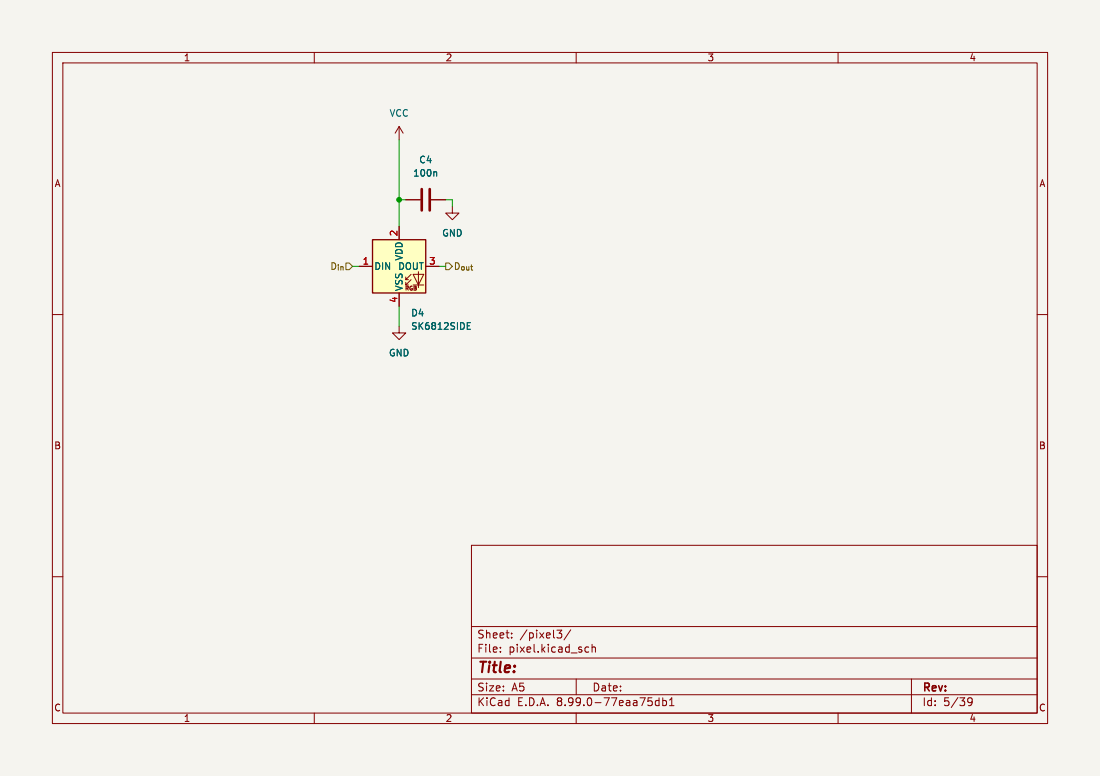
[picture p35: page 5]

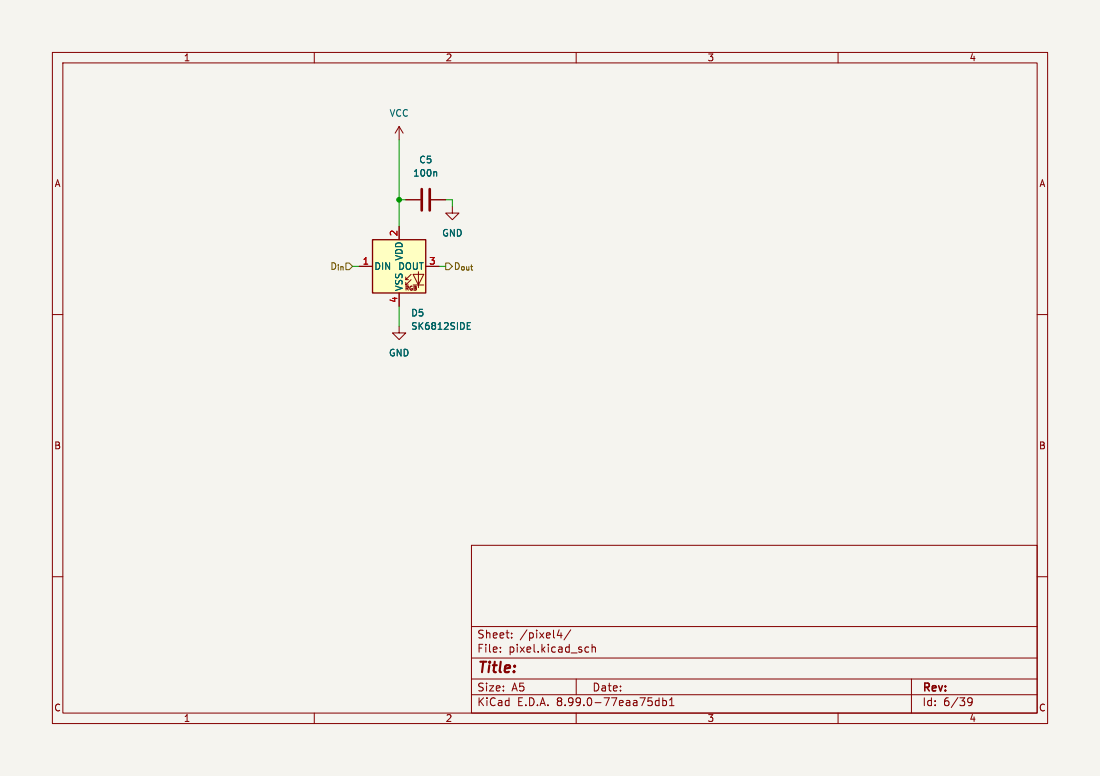
[picture p36: page 6]

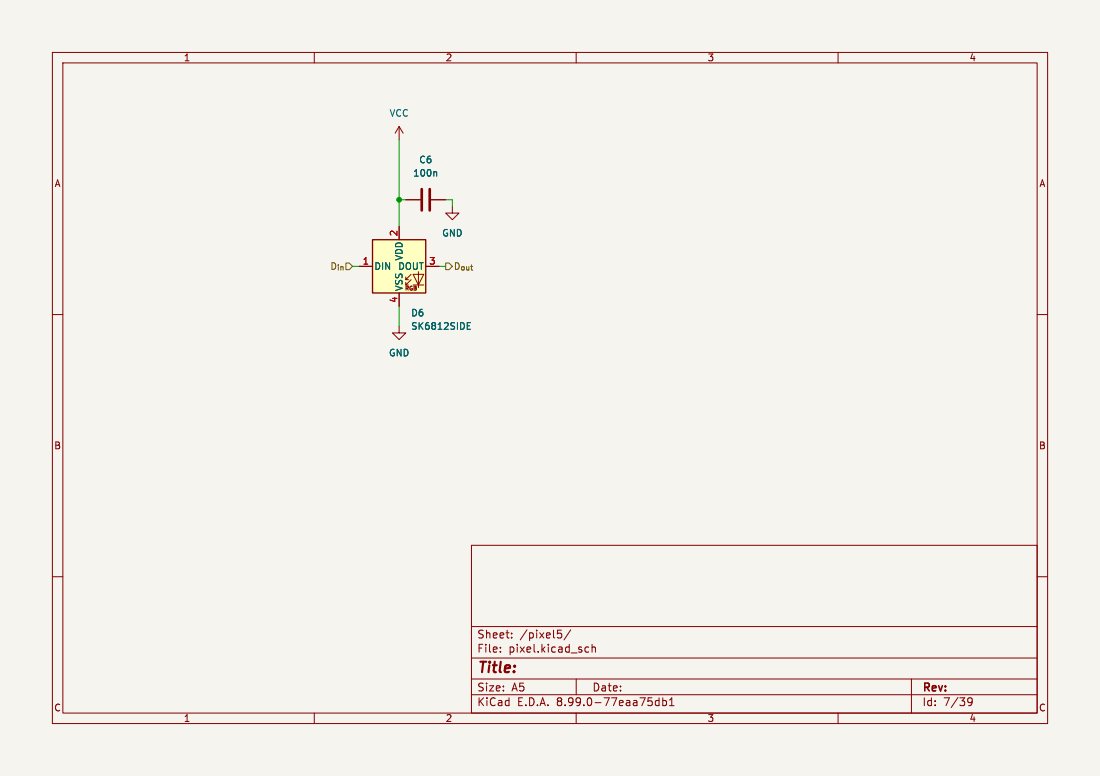
[picture p37: page 7]

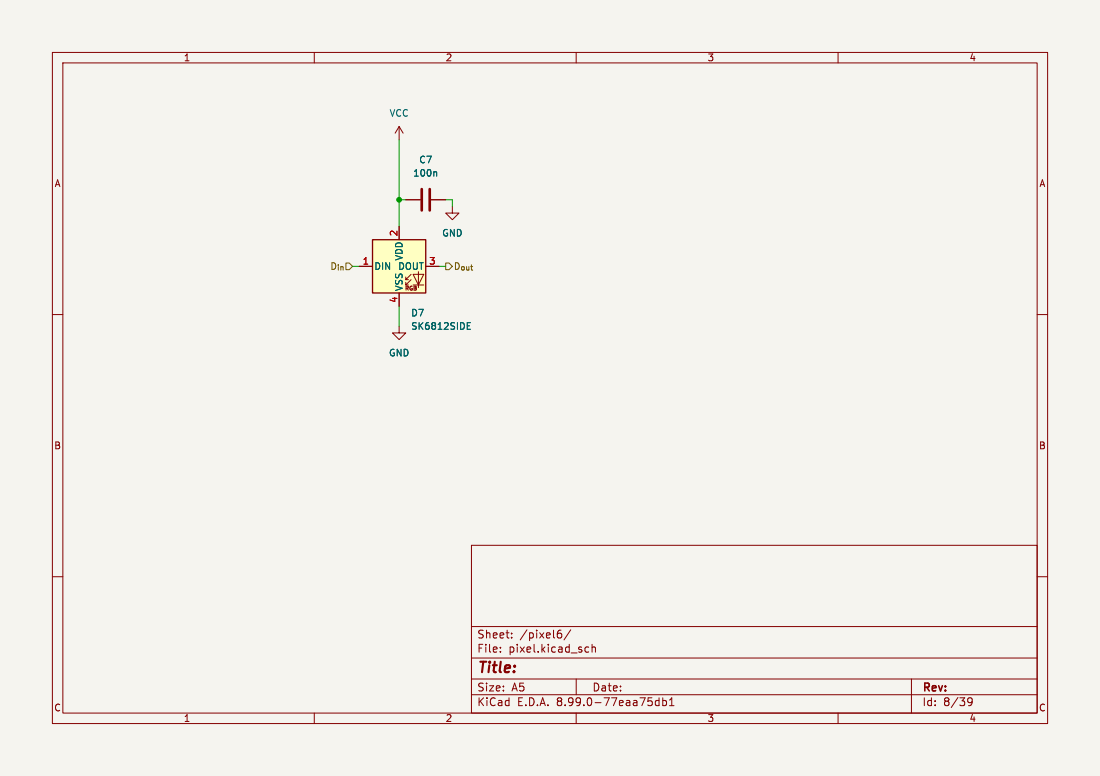
[picture p38: page 8]

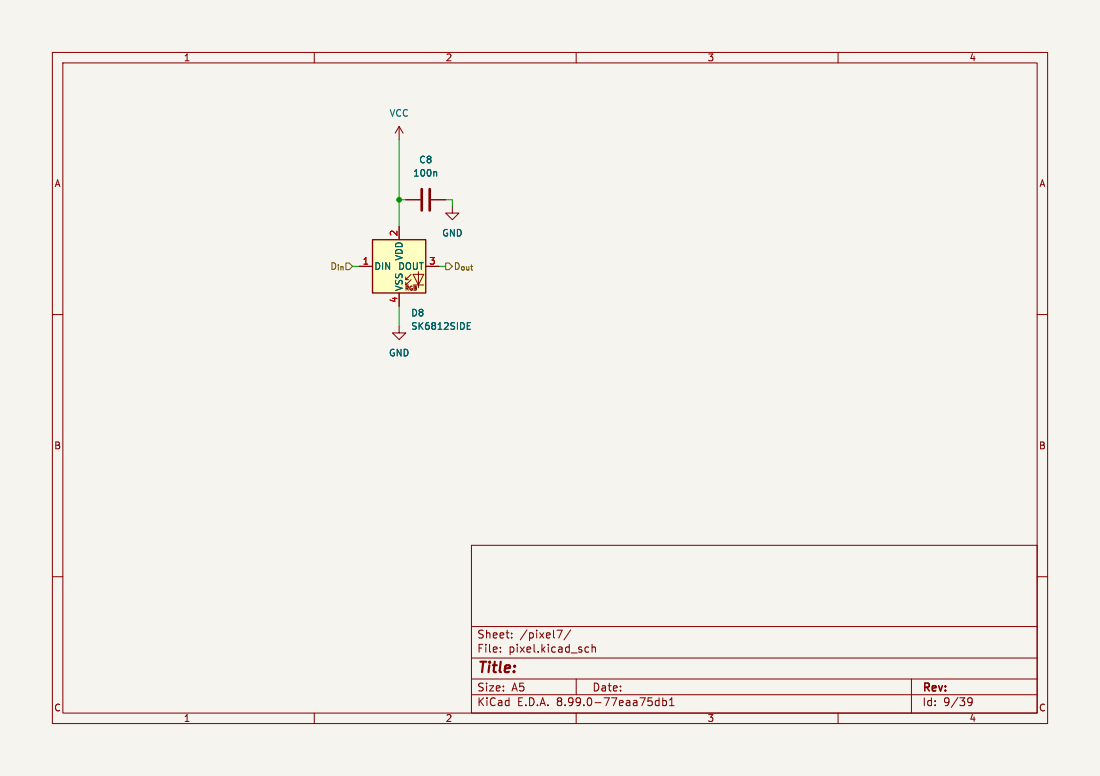
[picture p39: page 9]

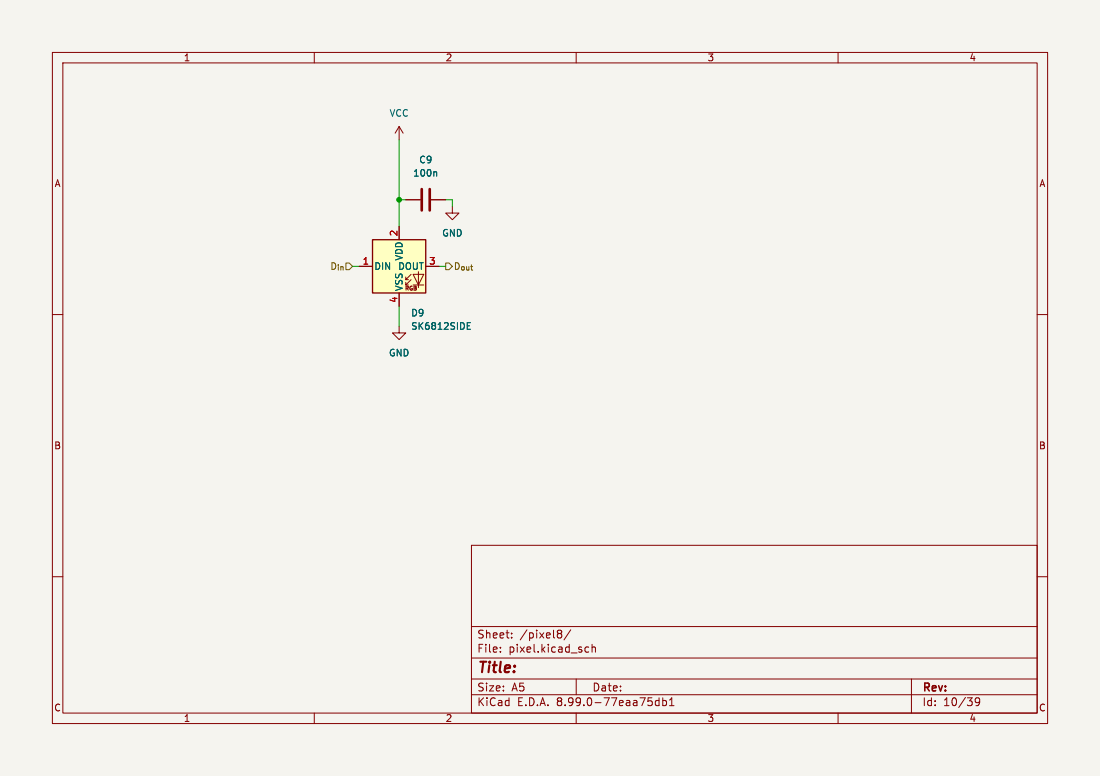
[picture p40: page 10]

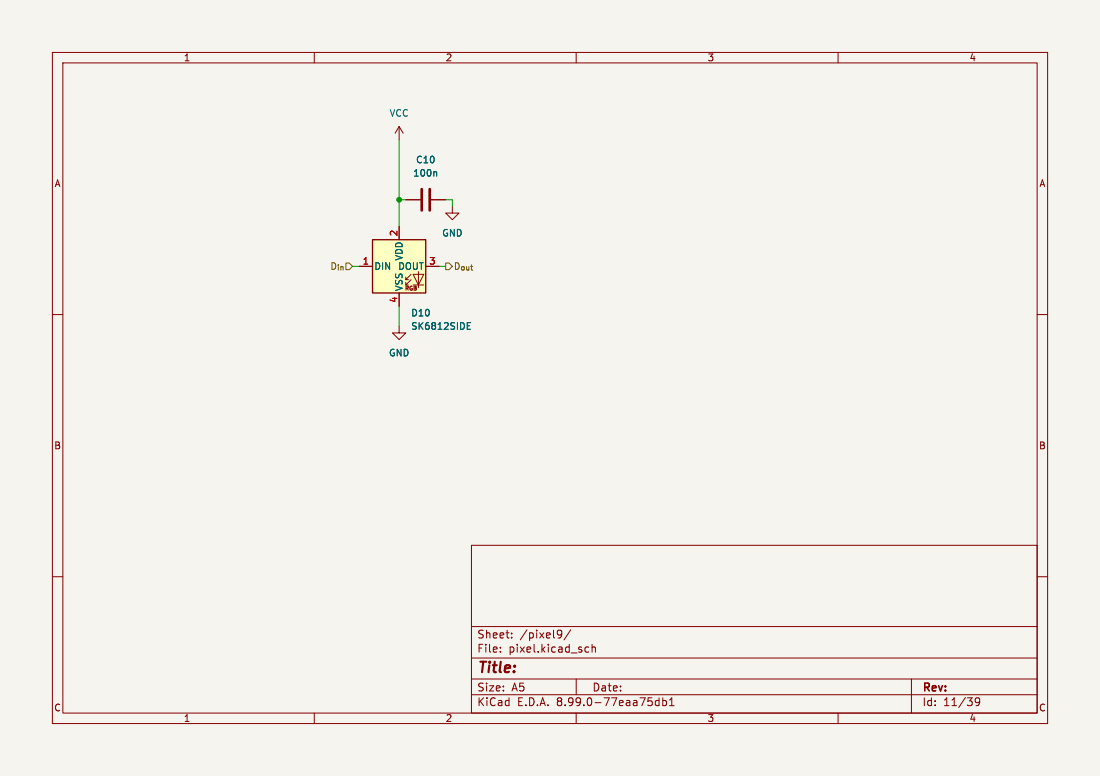
[picture p41: page 11]

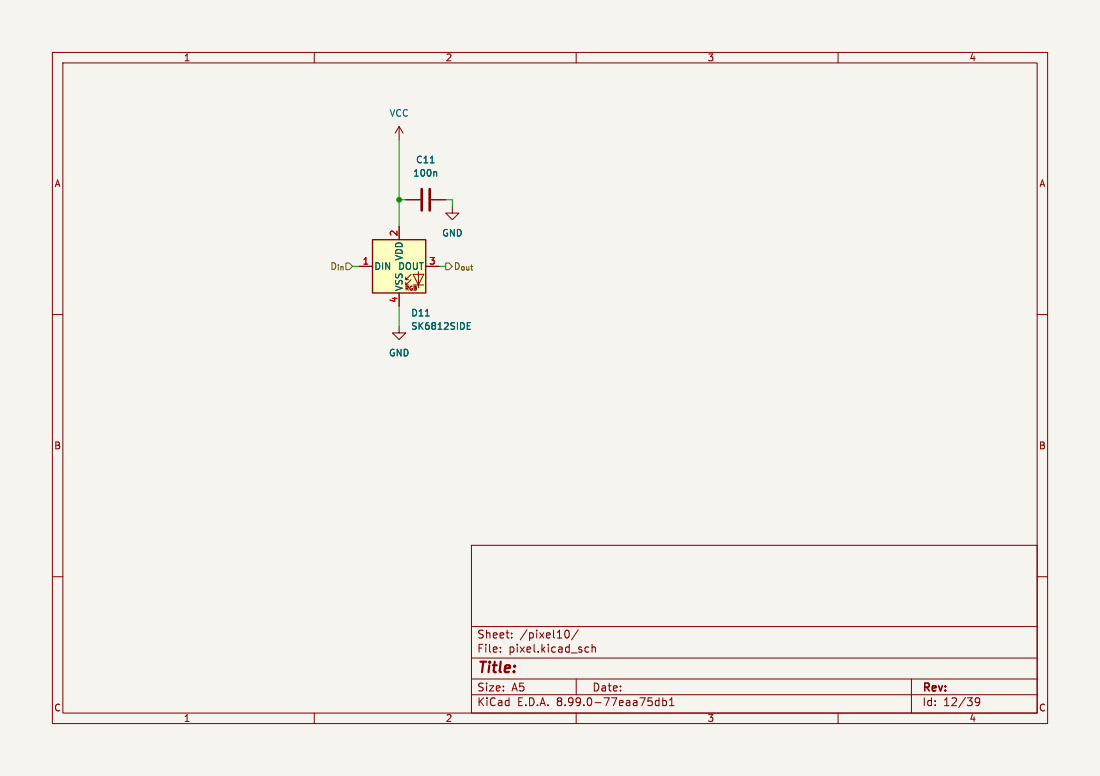
[picture p42: page 12]

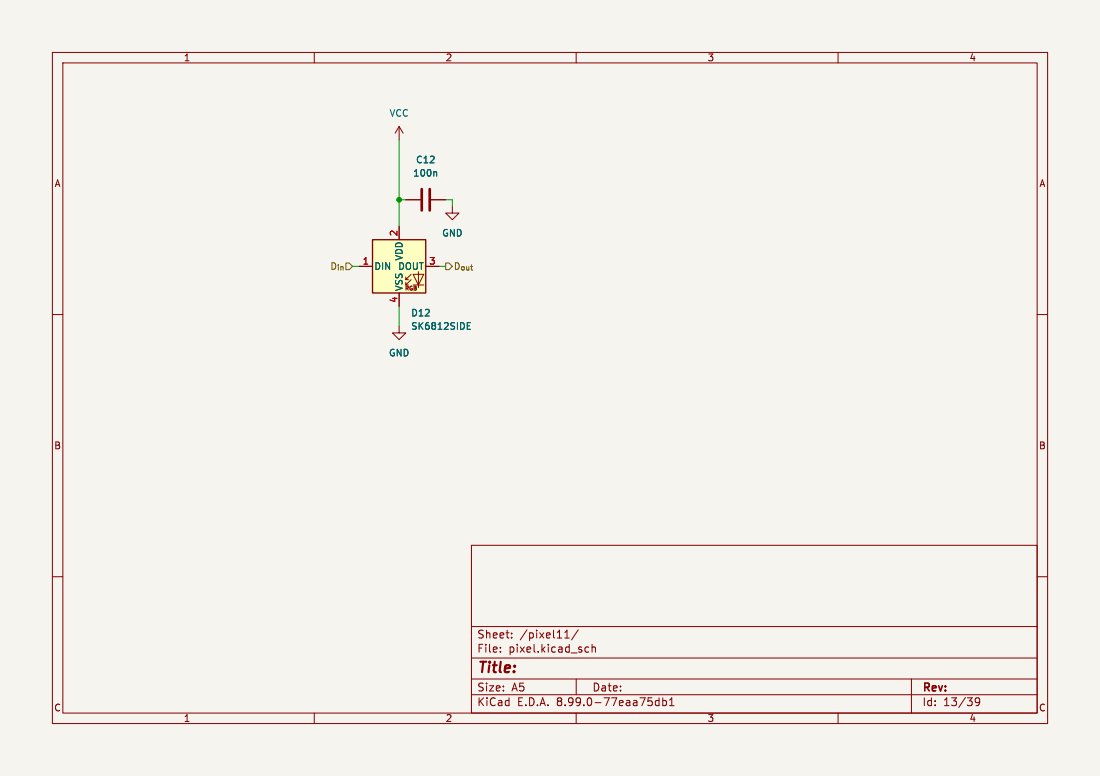
[picture p43: page 13]

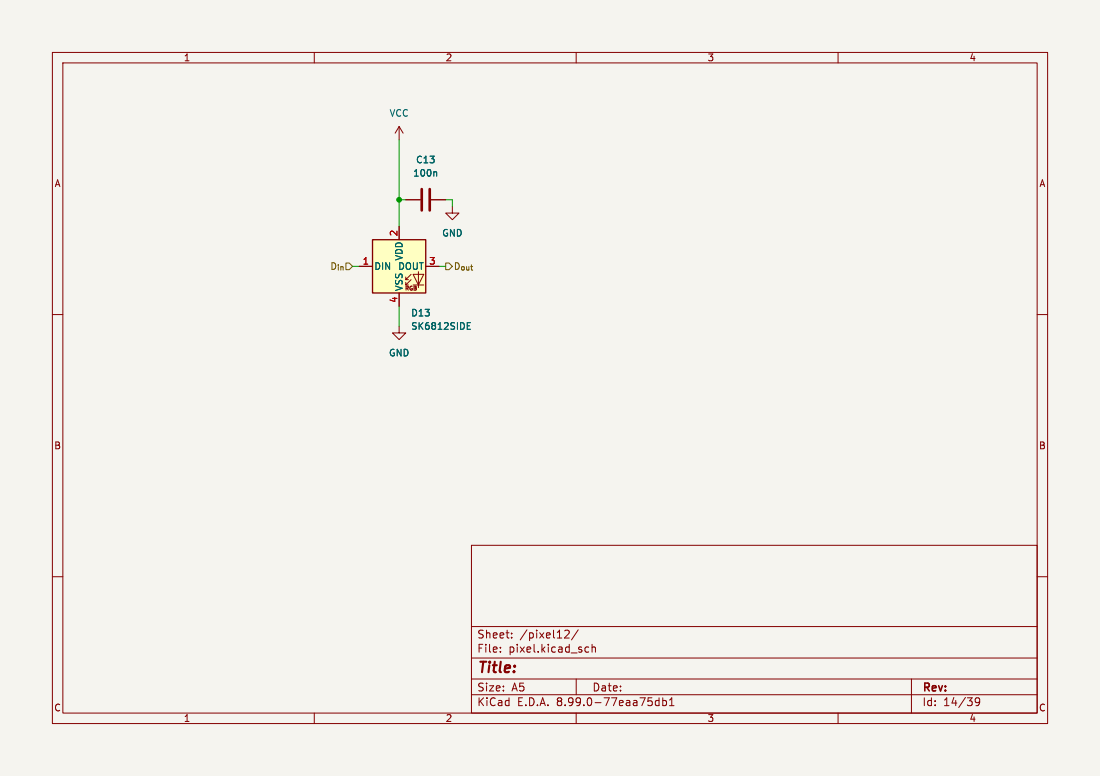
[picture p44: page 14]

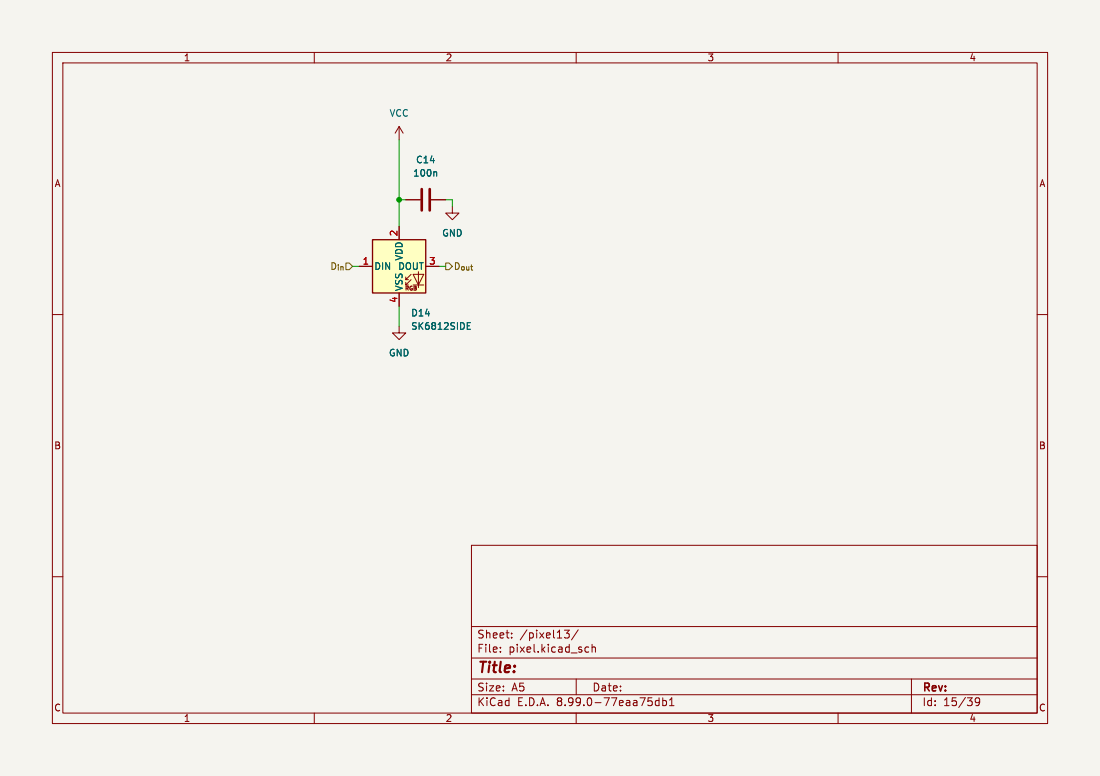
[picture p45: page 15]

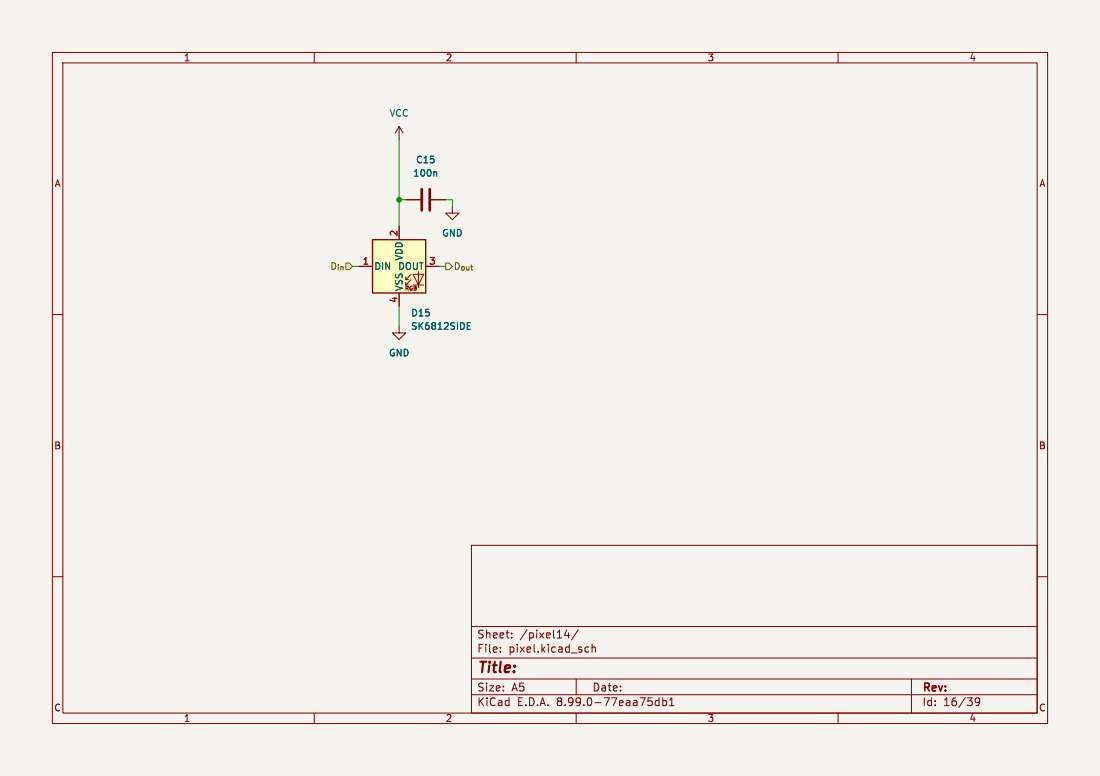
[picture p46: page 16]

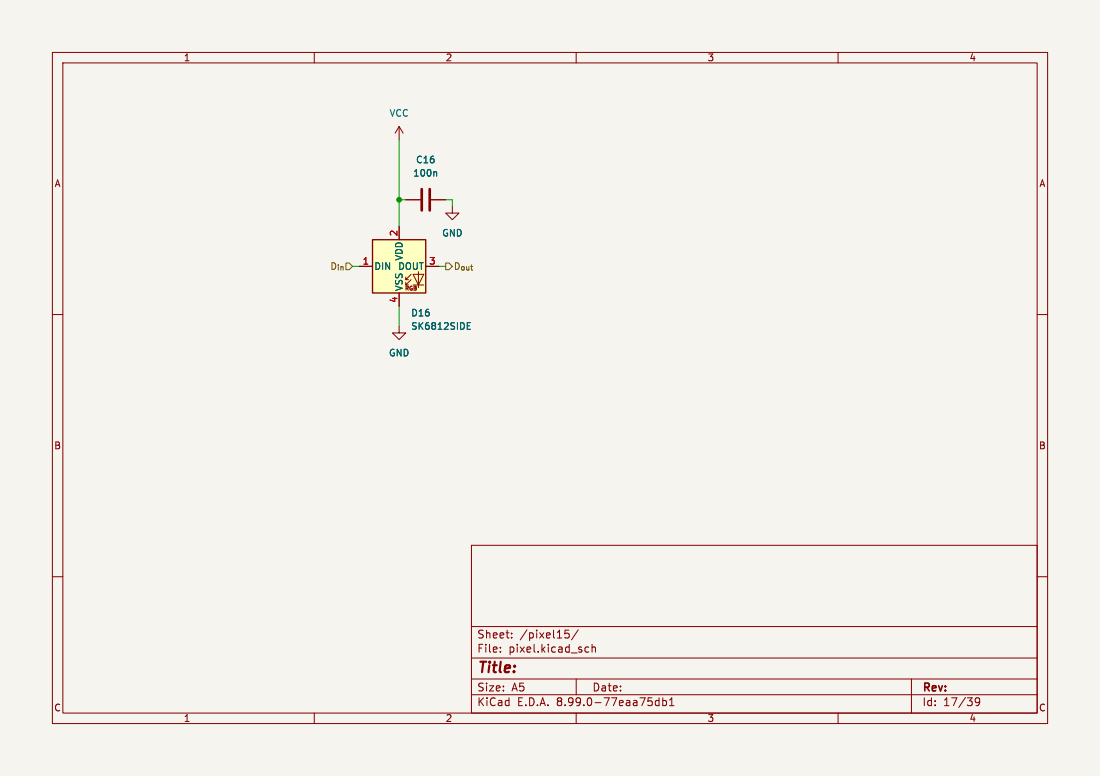
[picture p47: page 17]

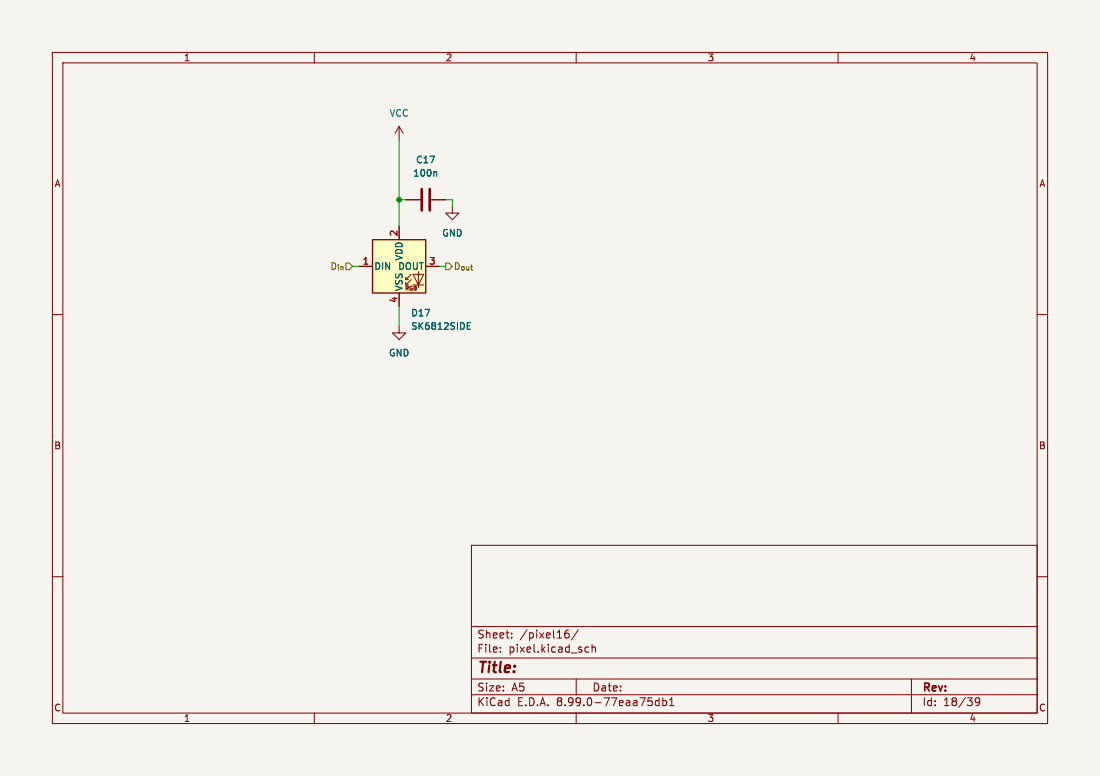
[picture p48: page 18]

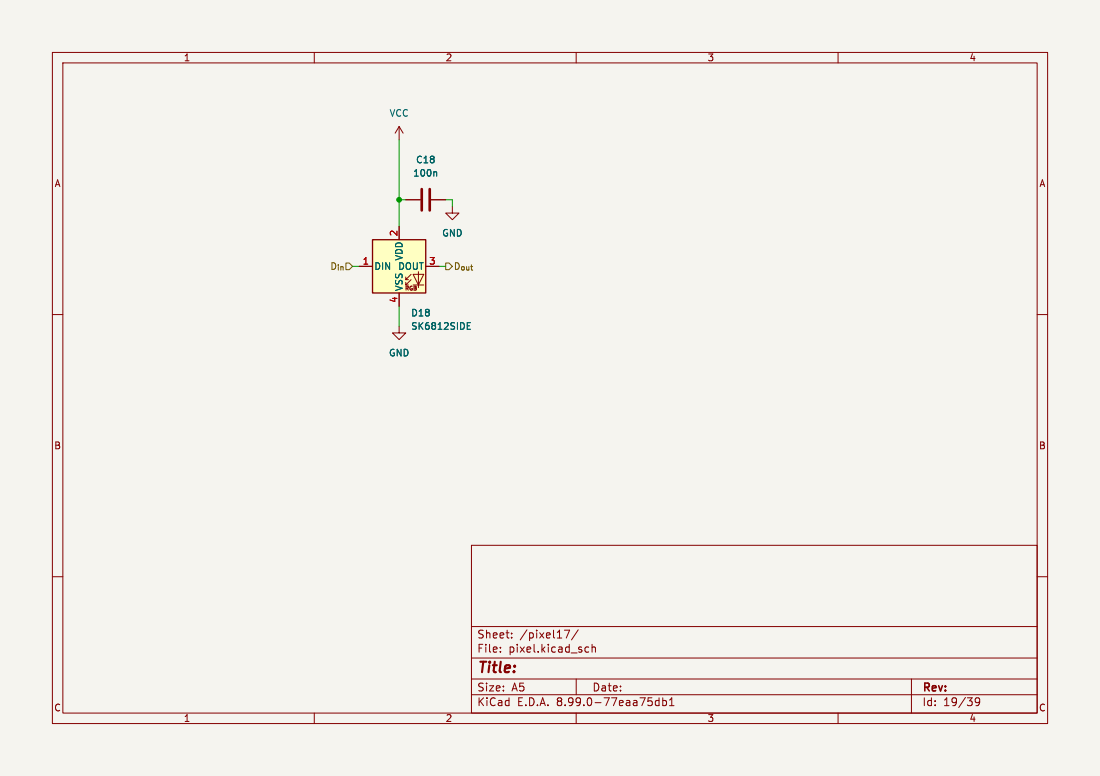
[picture p49: page 19]

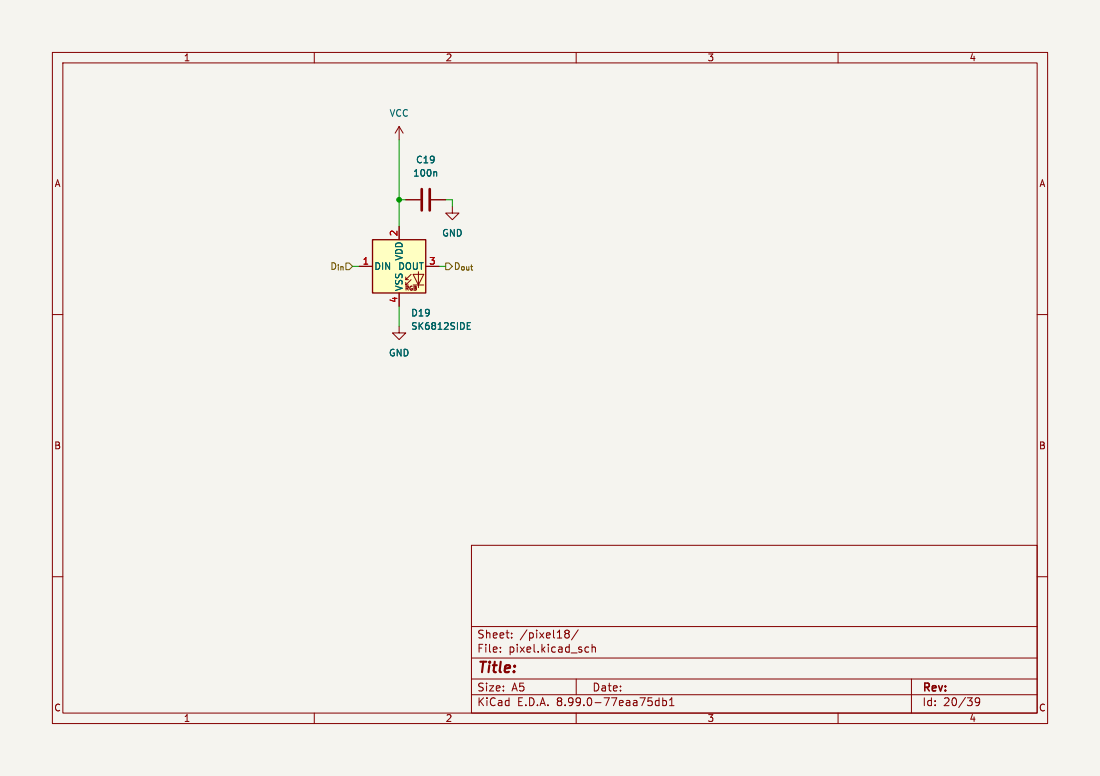
[picture p50: page 20]

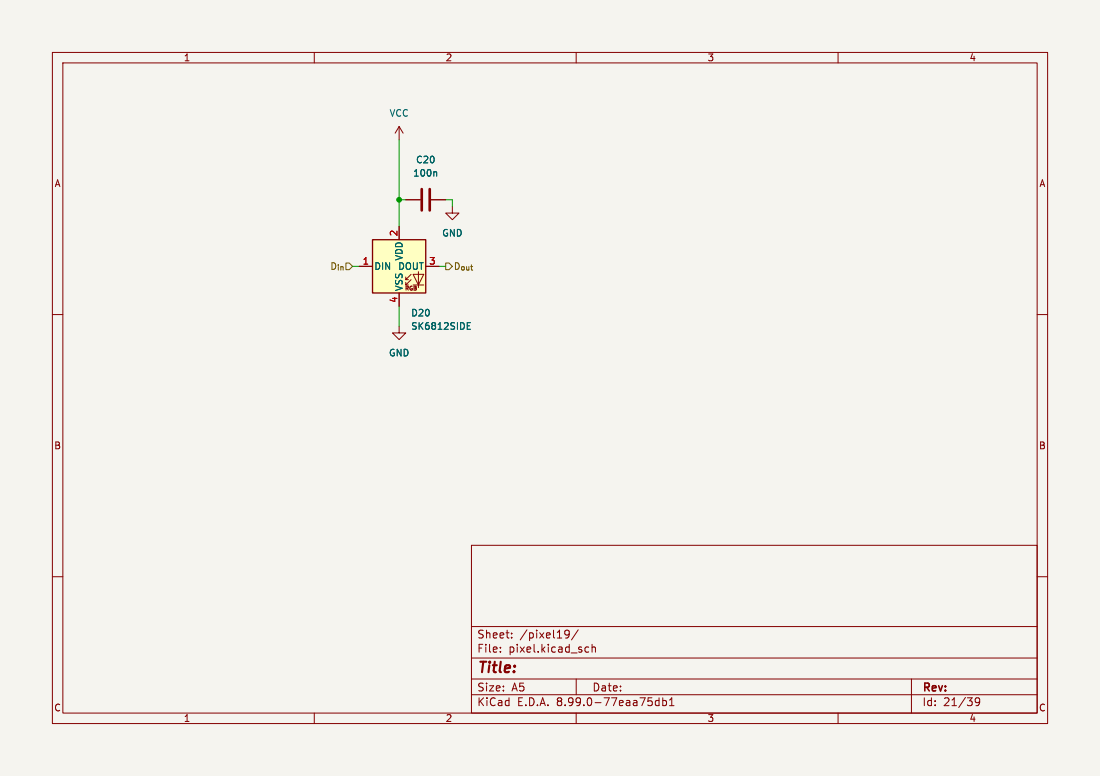
[picture p51: page 21]

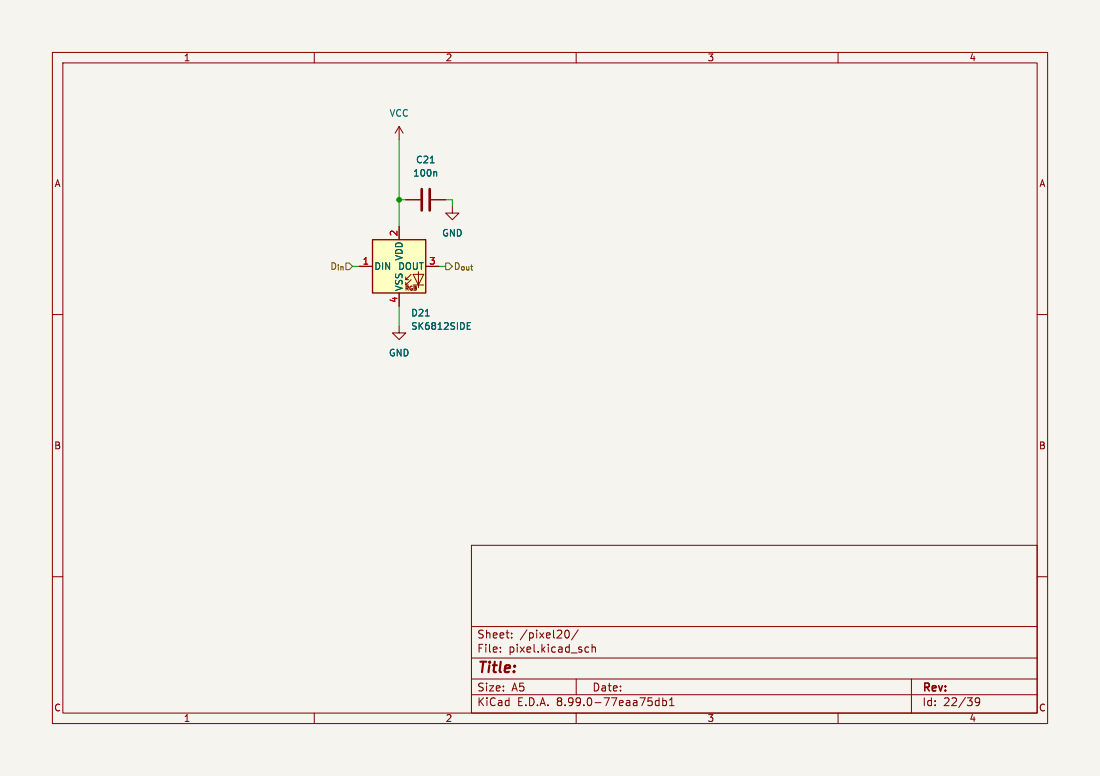
[picture p52: page 22]

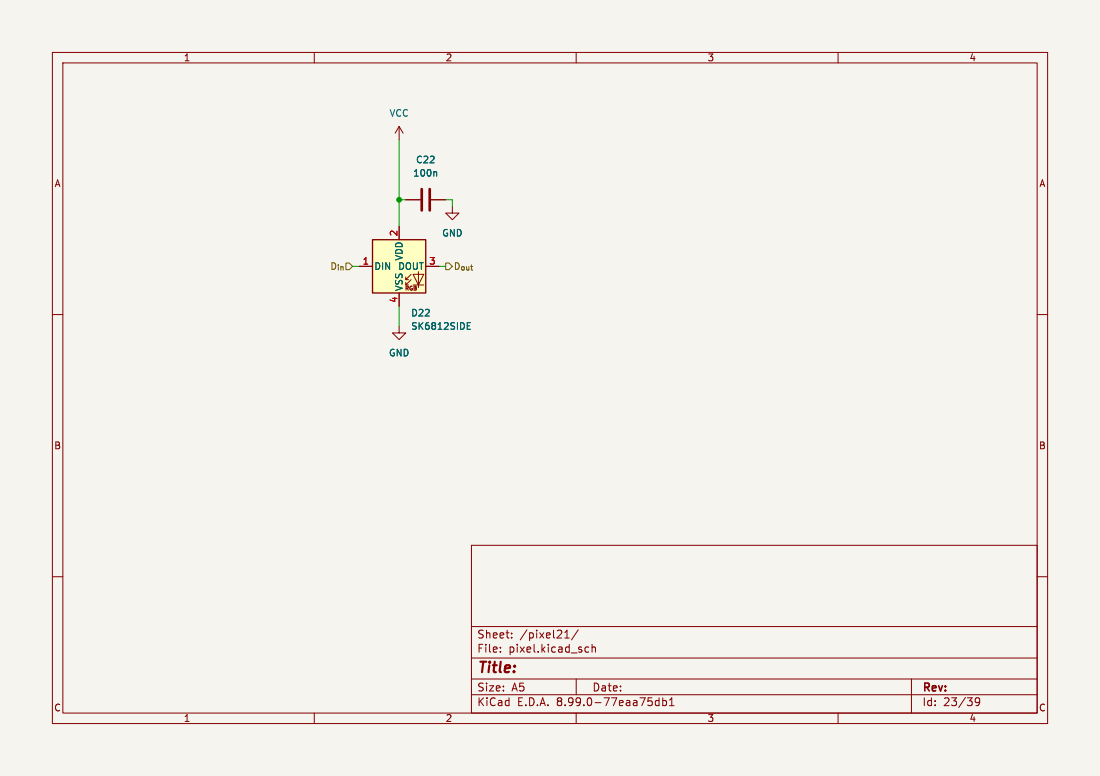
[picture p53: page 23]

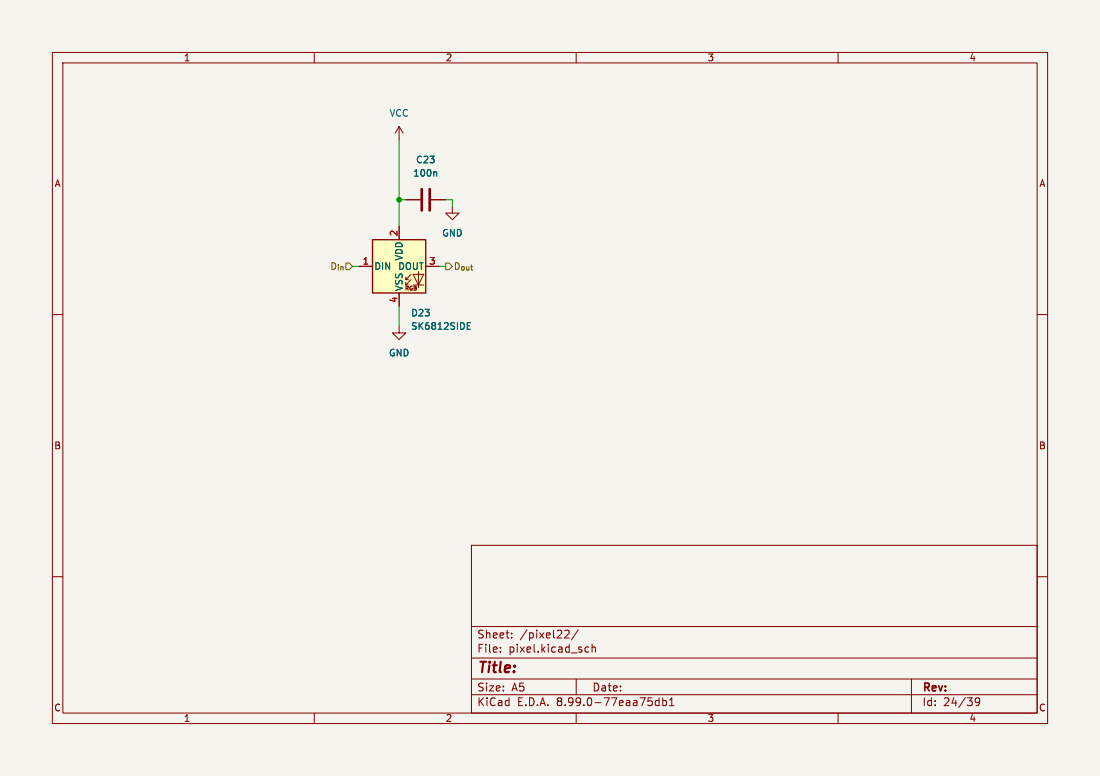
[picture p54: page 24]

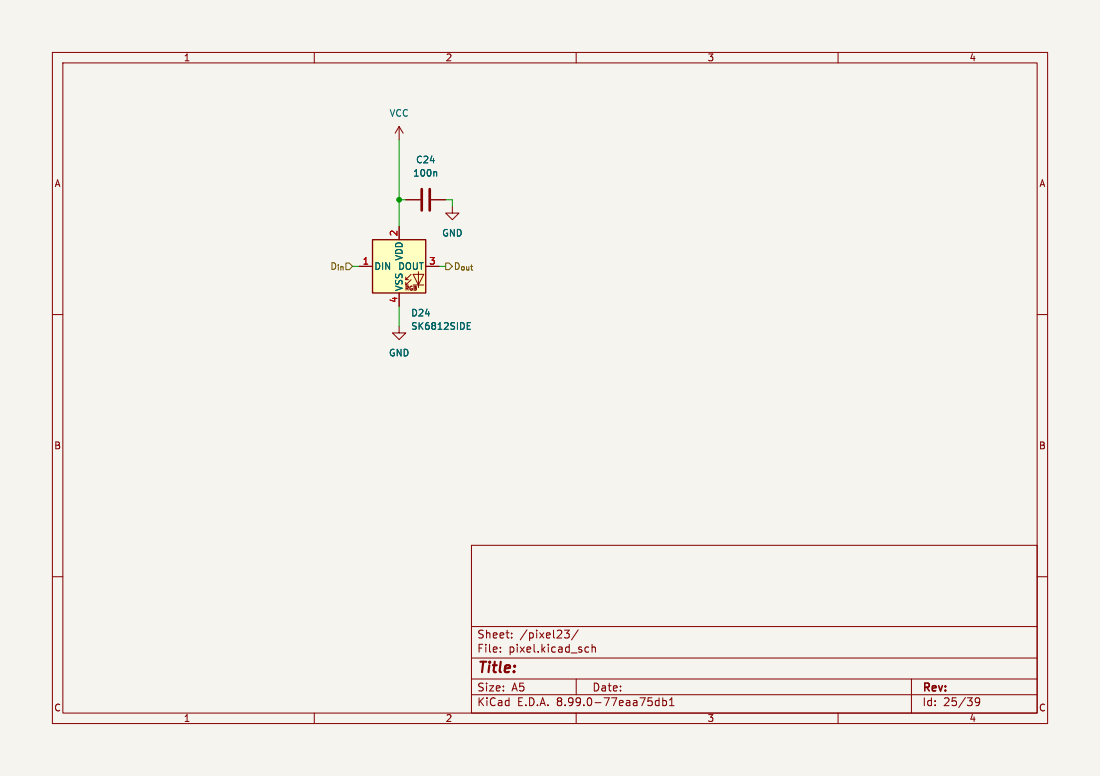
[picture p55: page 25]

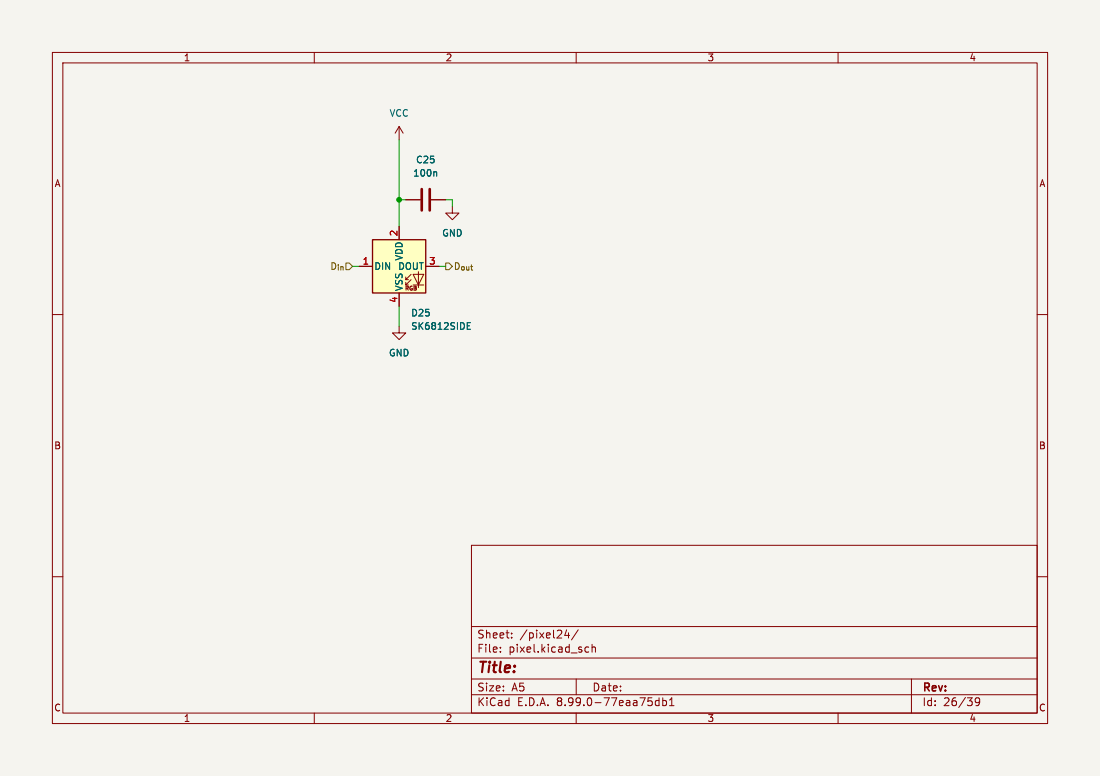
[picture p56: page 26]

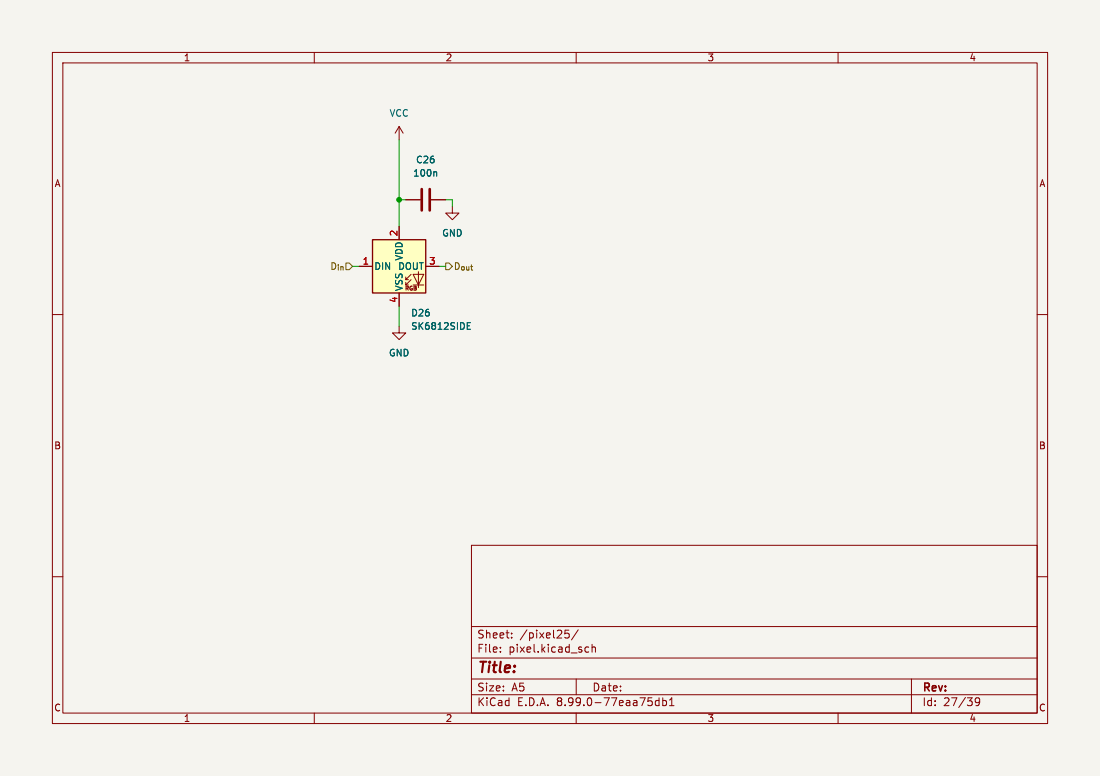
[picture p57: page 27]

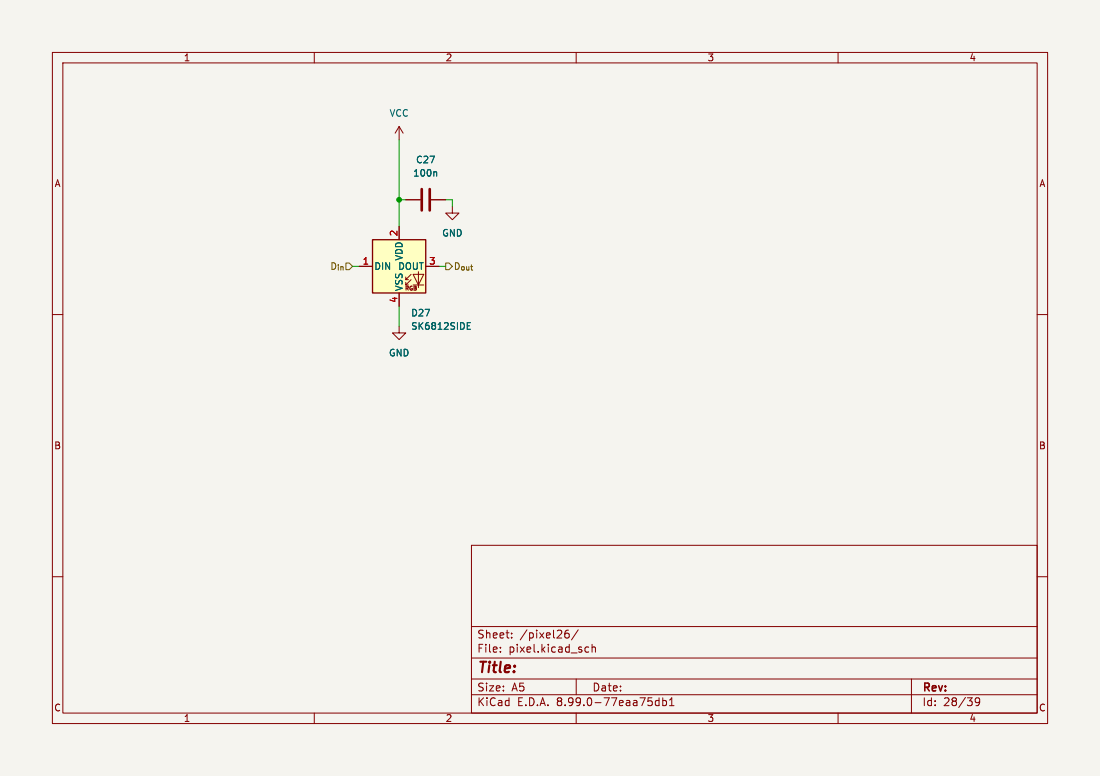
[picture p58: page 28]

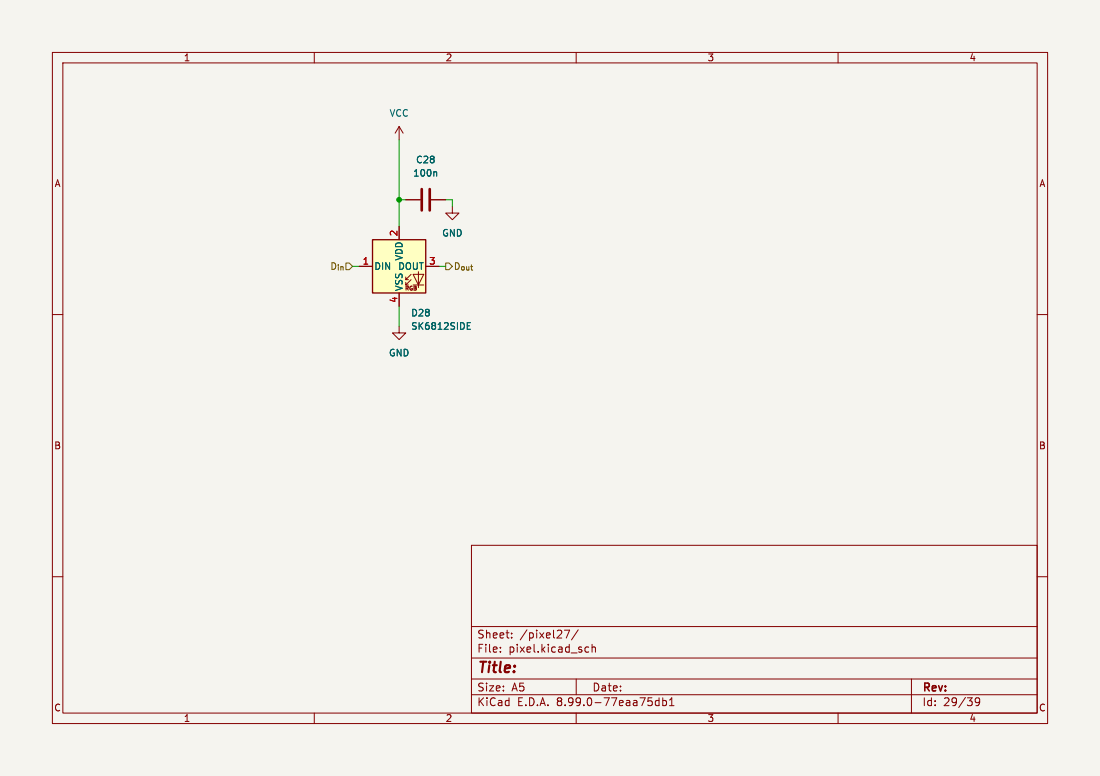
[picture p59: page 29]

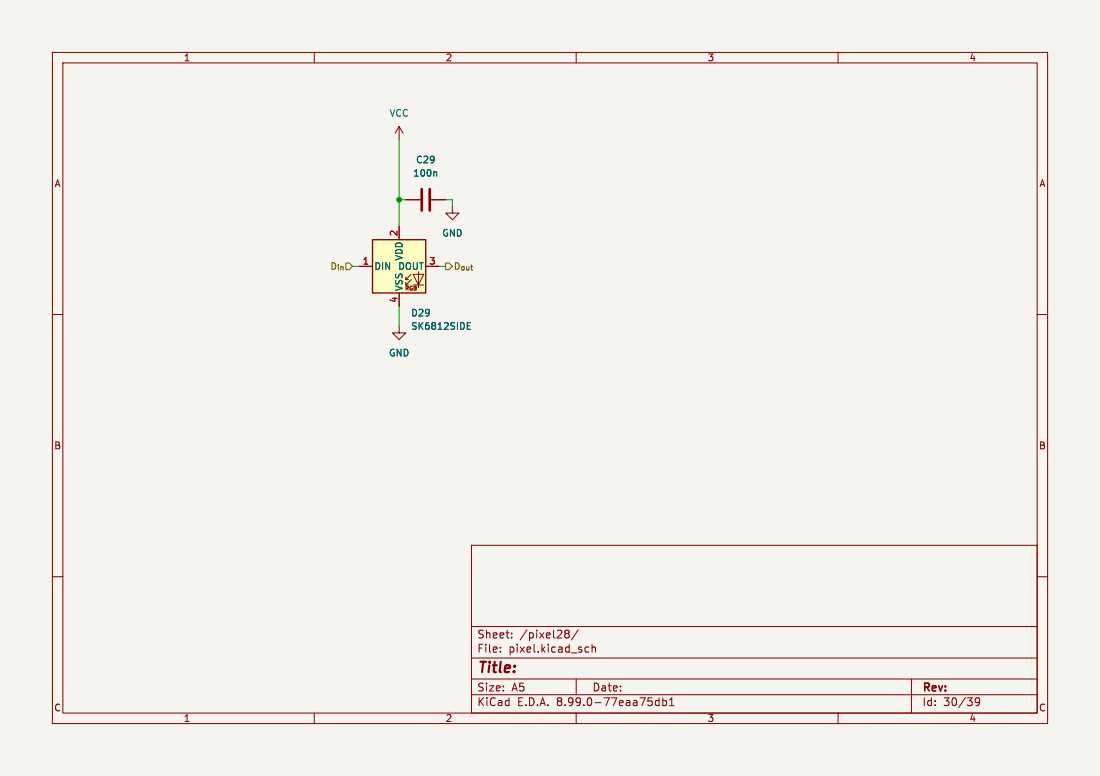
[picture p60: page 30]

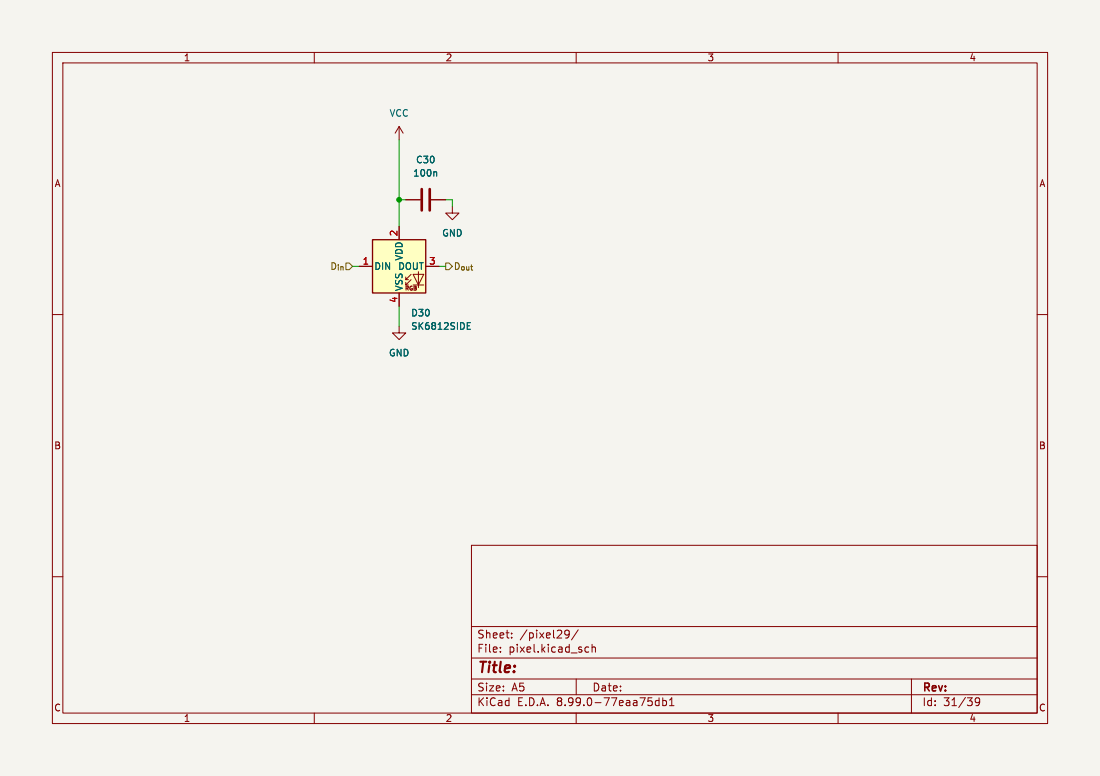
[picture p61: page 31]

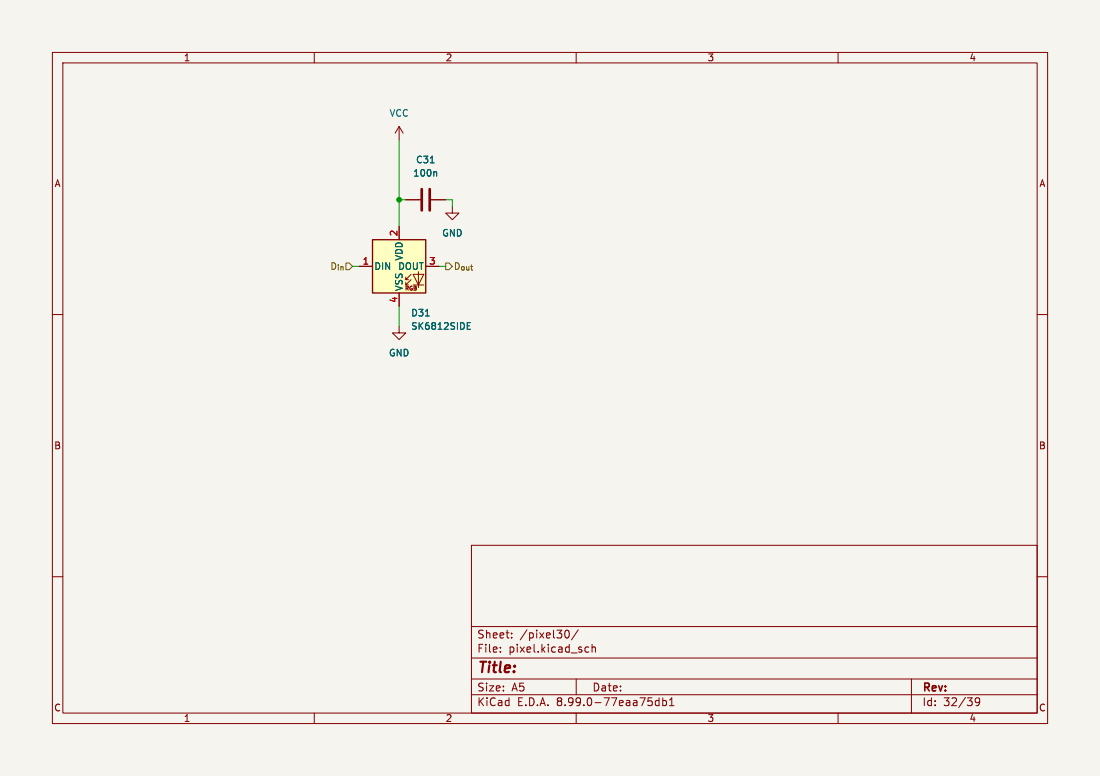
[picture p62: page 32]

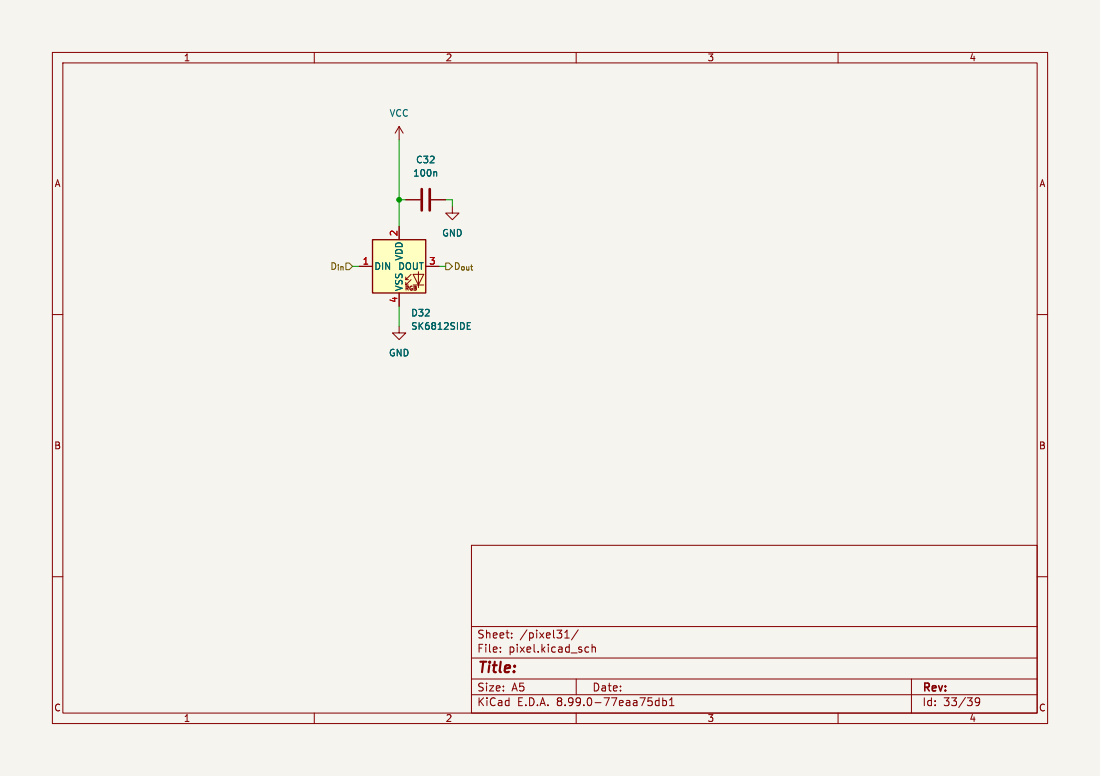
[picture p63: page 33]

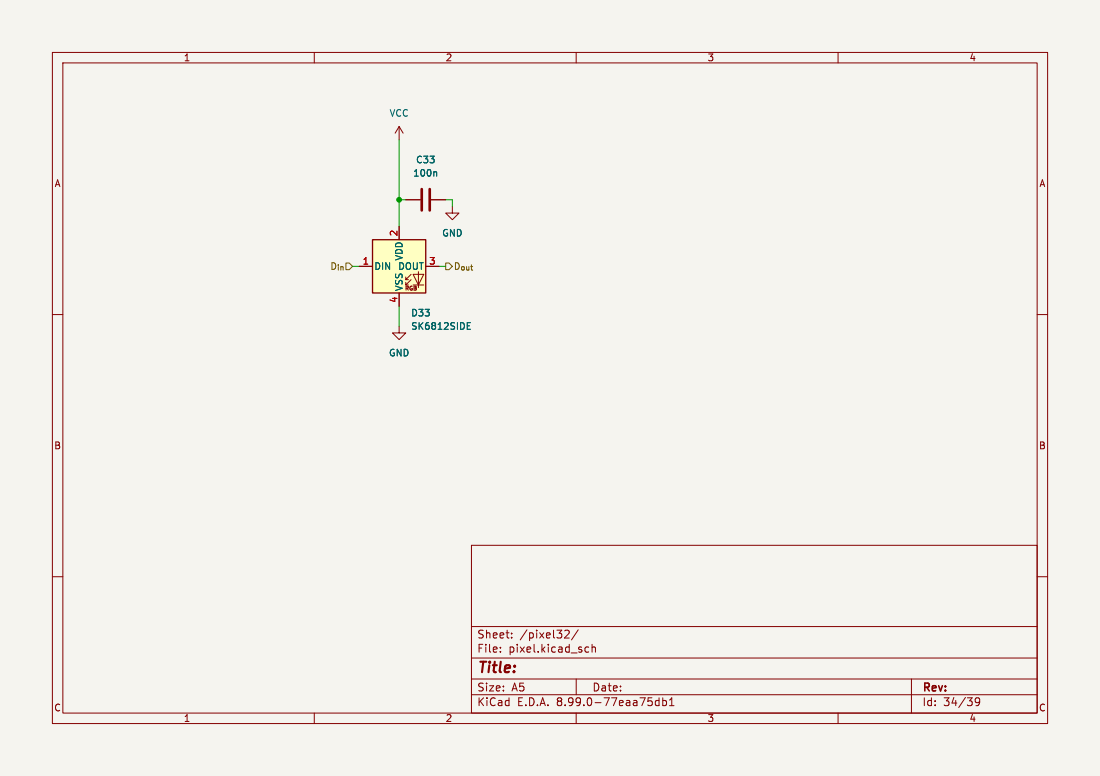
[picture p64: page 34]

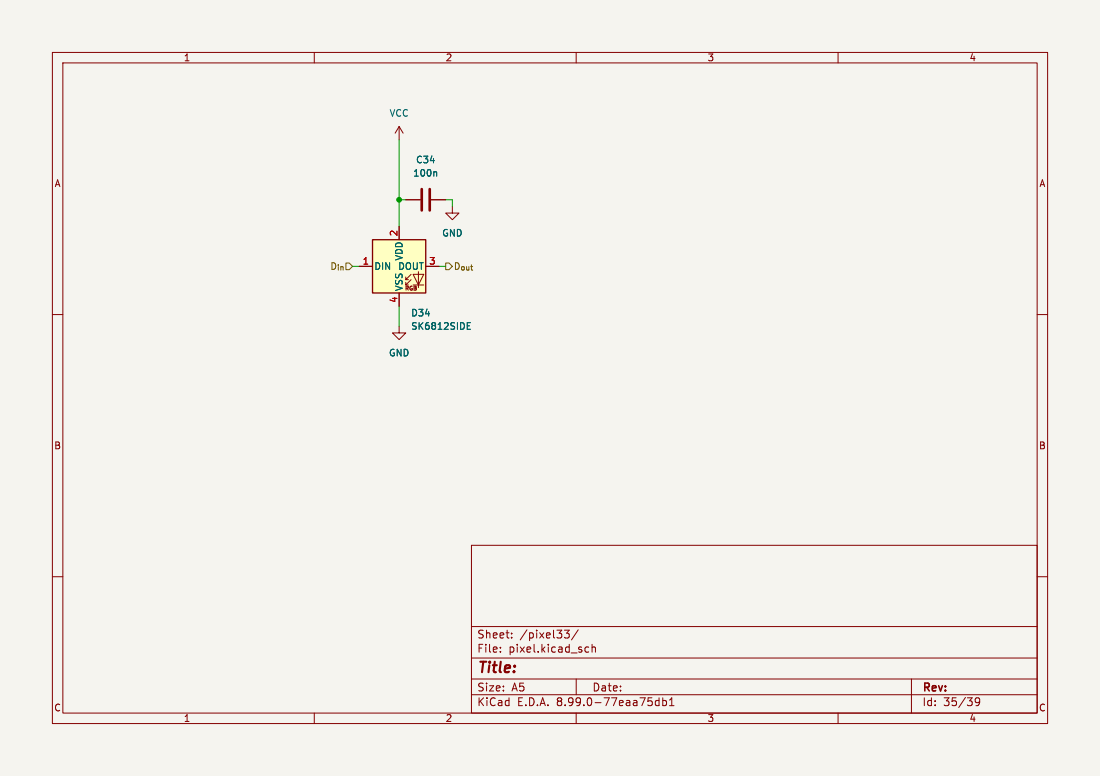
[picture p65: page 35]

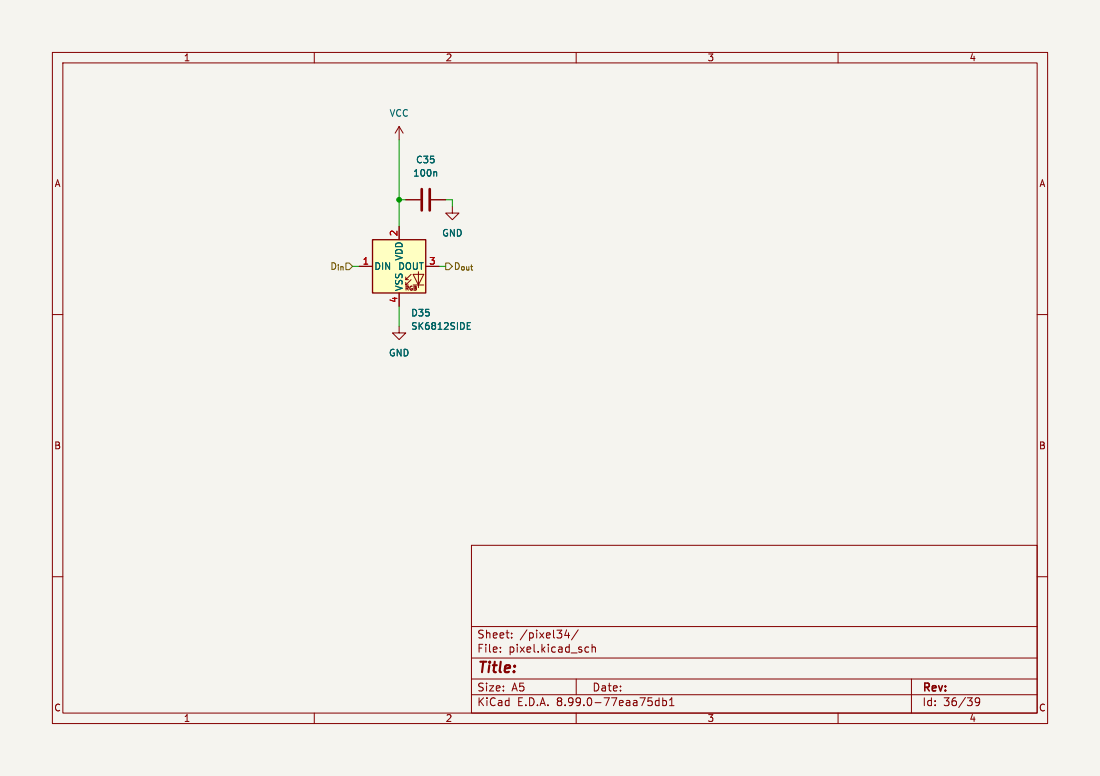
[picture p66: page 36]

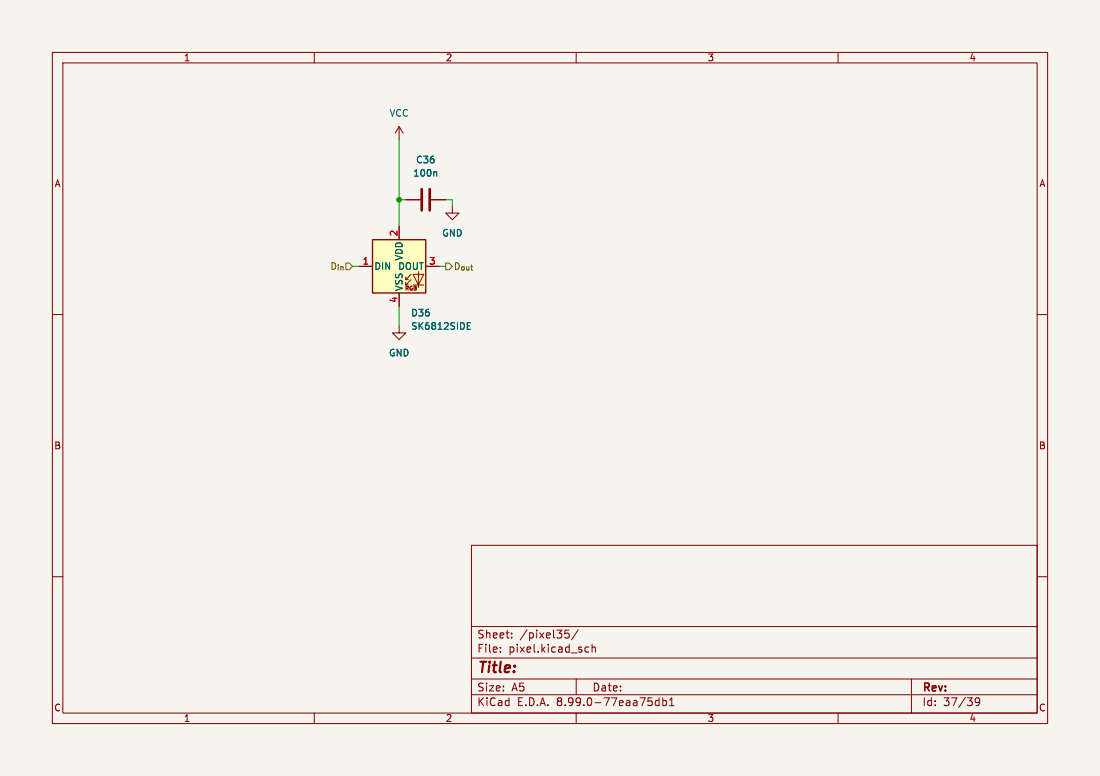
[picture p67: page 37]

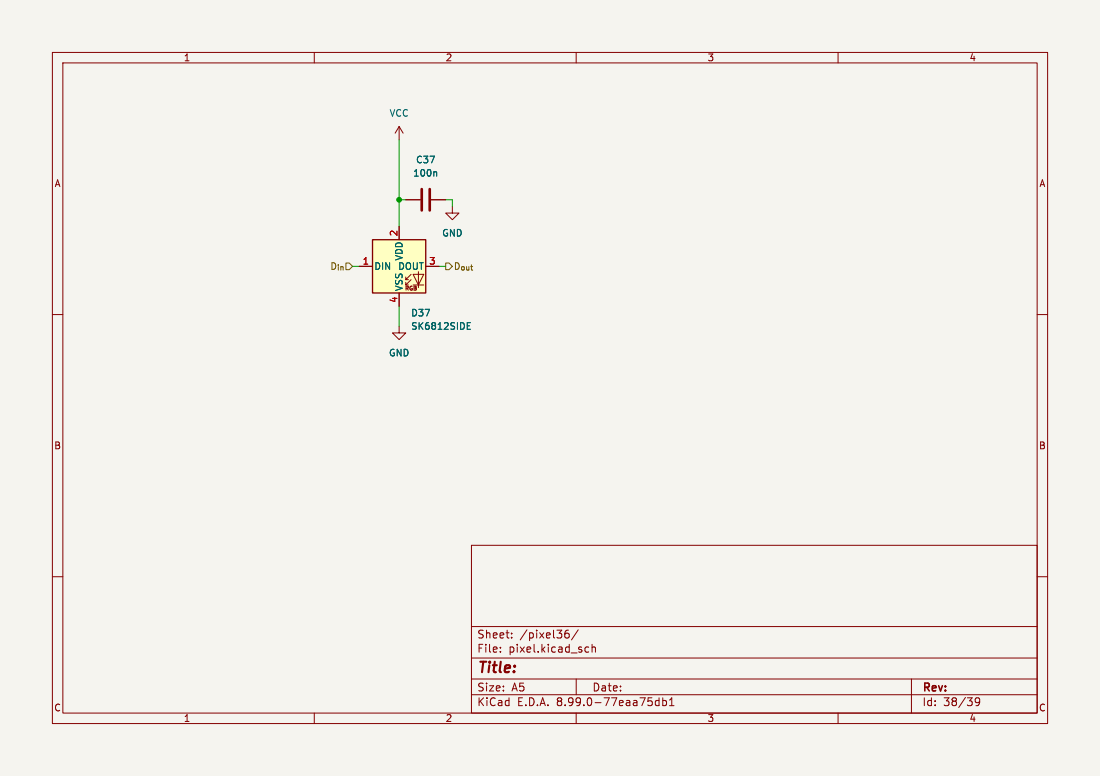
[picture p68: page 38]

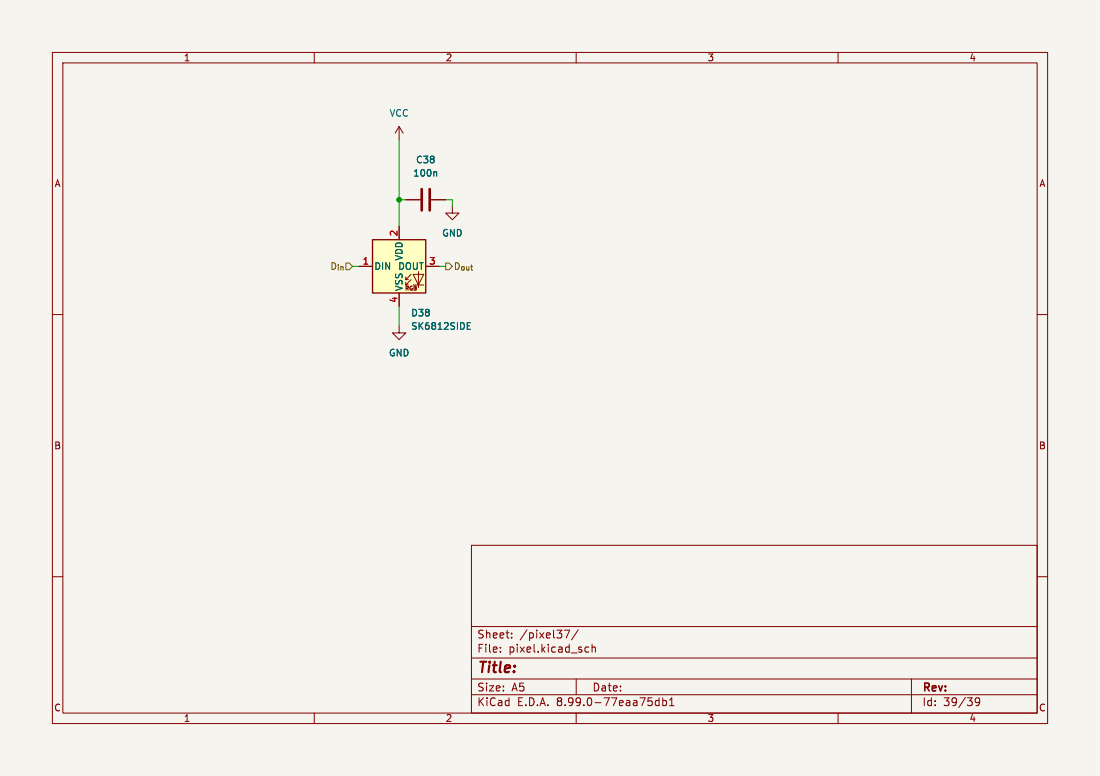
[picture p69: page 39]
