Geheimorganisation/geheimbadge-hardware/exports/plots/template-sch.pdf

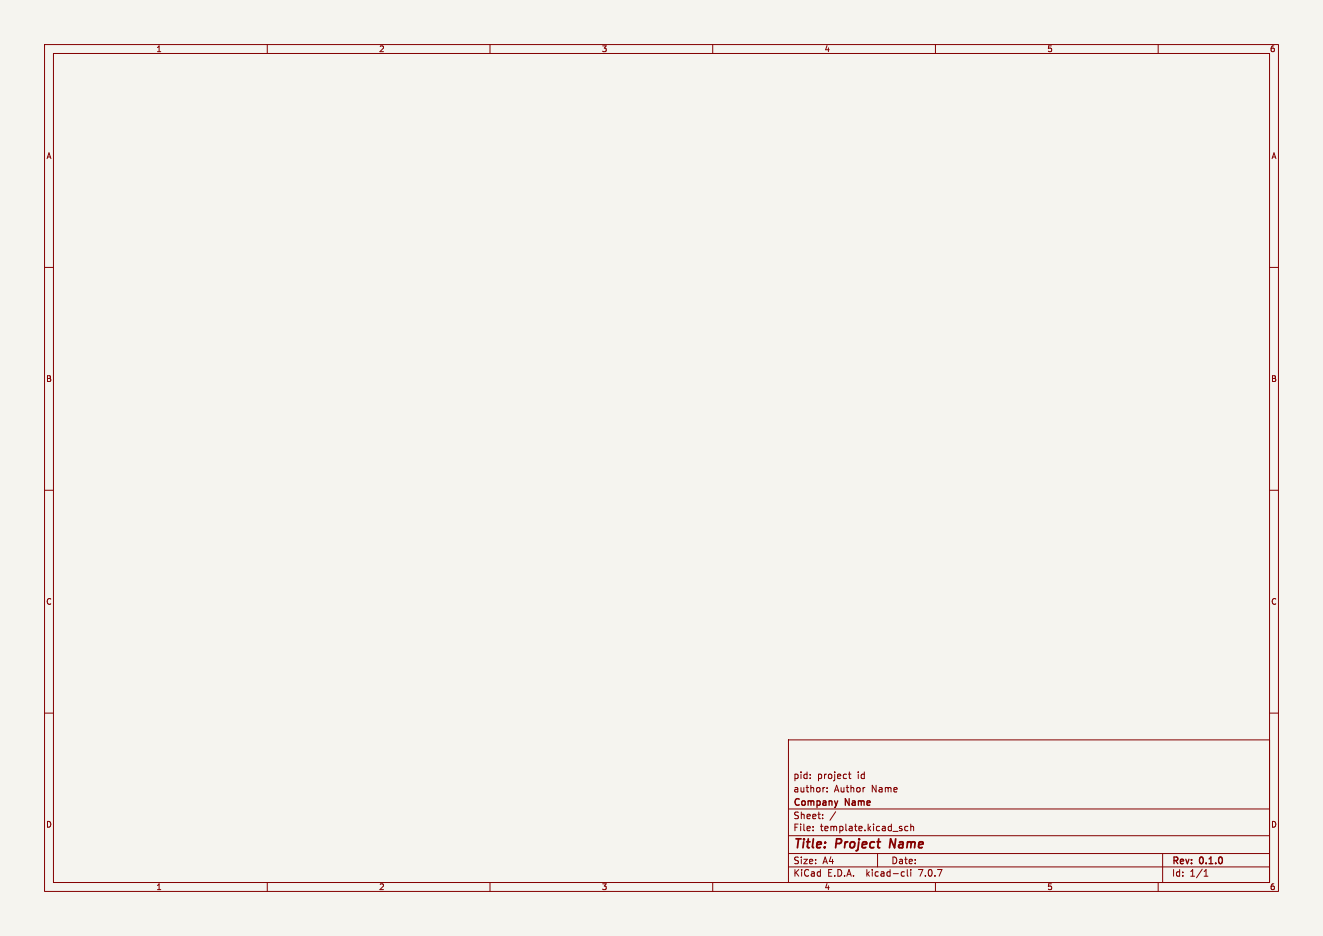
[picture p70: page 1]

Id: 1/1 Title: Project Name
