Geheimorganisation/geheimbadge-hardware/source/geheimbadge/geheimbadge.kicad_pcb

## KiCad design source/geheimbadge/geheimbadge.kicad_pcb (2024-12-30)

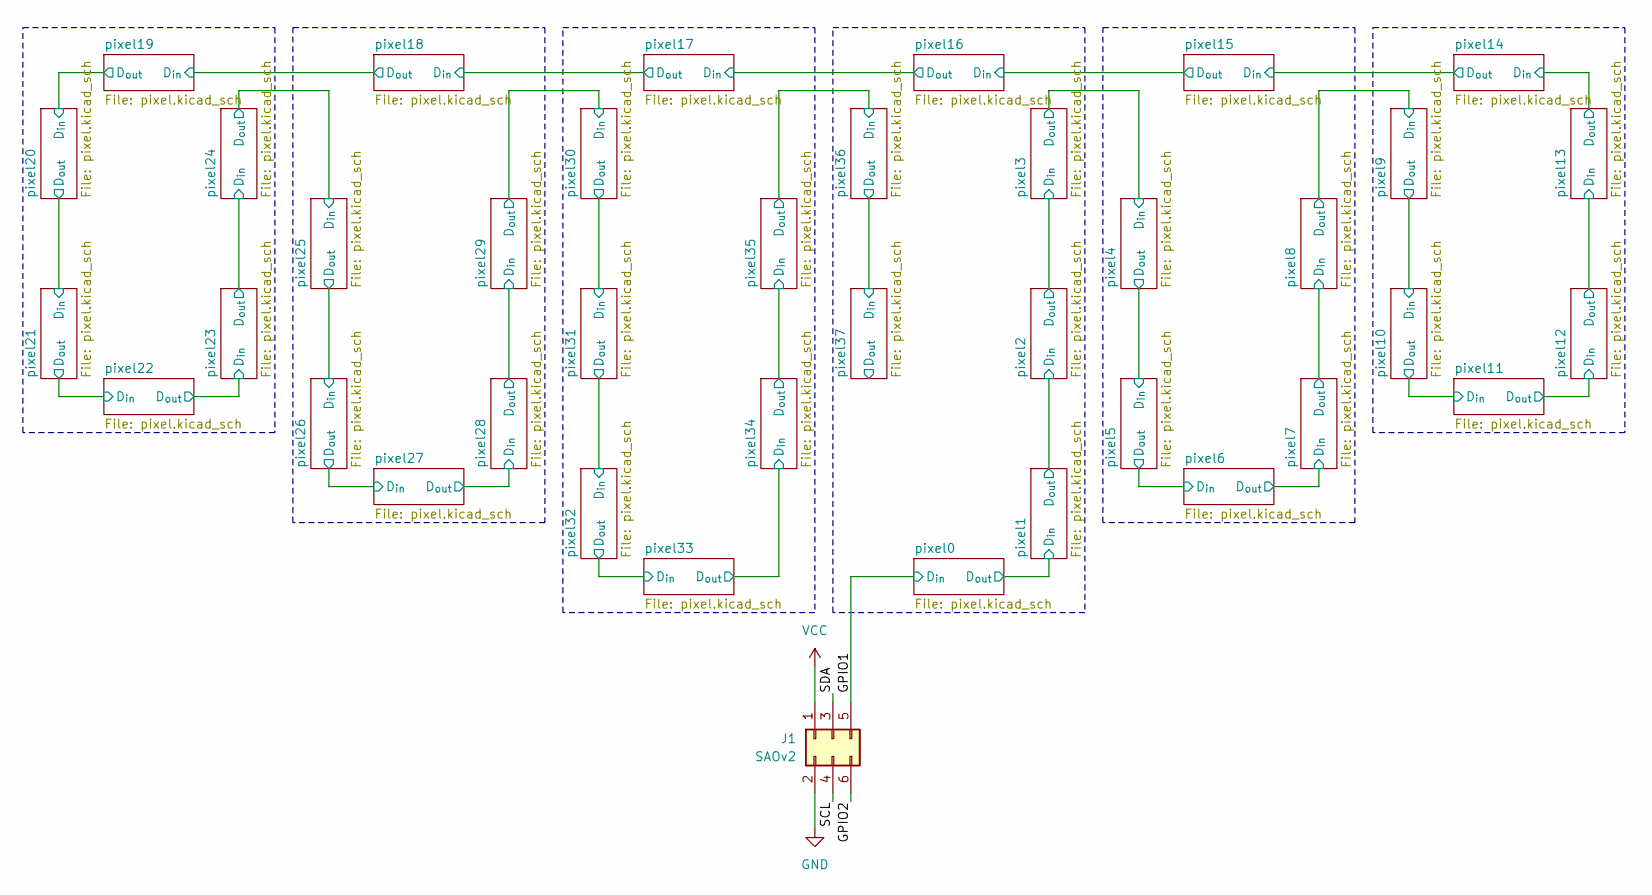
[picture p71: schematic geheimbadge.kicad_sch, ${title}]

Parts:
J1: SAOv2; IDC-Header_2x03_P2.54mm_Vertical_SMD; LCSC C4749176

Connections:
/GPIO1: J1.5; also elsewhere on the board
/GPIO2: J1.6
/SCL: J1.4
/SDA: J1.3
GND: J1.2; also elsewhere on the board
VCC: J1.1; also elsewhere on the board

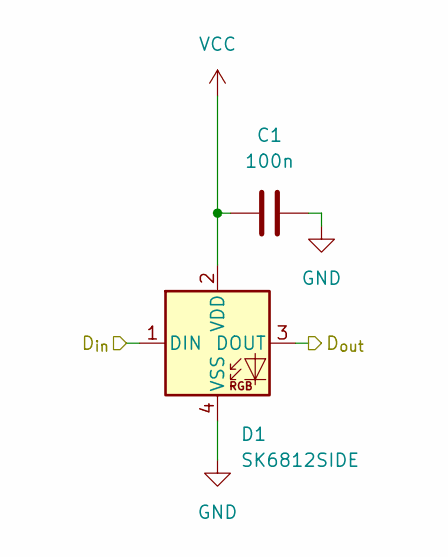
[picture p72: schematic pixel.kicad_sch]

Parts:
C1: 100n; C_0402_1005Metric; LCSC C1525
D1: SK6812SIDE; LED-SMD_4P-L4.0-W1.6-L; LCSC C5378721

Connections:
/GPIO1: D1.1 (DIN); also elsewhere on the board
/pixel0/D_{out}: D1.3 (DOUT); also elsewhere on the board
GND: C1.2, D1.4 (VSS); also elsewhere on the board
VCC: C1.1, D1.2 (VDD); also elsewhere on the board

Parts of its further copies:
C2, C3, C4, C5, C6, C7, C8, C9, C10, C11, C12, C13, C14, C15, C16, C17, C18, C19, C20, C21, C22, C23, C24, C25, C26, C27, C28, C29, C30, C31, C32, C33, C34, C35, C36, C37, C38: 100n; C_0402_1005Metric; LCSC C1525
D2, D3, D4, D5, D6, D7, D8, D9, D10, D11, D12, D13, D14, D15, D16, D17, D18, D19, D20, D21, D22, D23, D24, D25, D26, D27, D28, D29, D30, D31, D32, D33, D34, D35, D36, D37, D38: SK6812SIDE; LED-SMD_4P-L4.0-W1.6-L; LCSC C5378721

Connections of its further copies:
/pixel0/D_{out}: D2.1 (DIN); also elsewhere on the board
/pixel1/D_{out}: D2.3 (DOUT), D3.1 (DIN)
/pixel2/D_{out}: D3.3 (DOUT), D4.1 (DIN)
/pixel3/D_{out}: D4.3 (DOUT), D5.1 (DIN)
/pixel4/D_{out}: D5.3 (DOUT), D6.1 (DIN)
/pixel5/D_{out}: D6.3 (DOUT), D7.1 (DIN)
/pixel6/D_{out}: D7.3 (DOUT), D8.1 (DIN)
/pixel7/D_{out}: D8.3 (DOUT), D9.1 (DIN)
/pixel8/D_{out}: D9.3 (DOUT), D10.1 (DIN)
/pixel10/D_{in}: D10.3 (DOUT), D11.1 (DIN)
/pixel10/D_{out}: D11.3 (DOUT), D12.1 (DIN)
/pixel11/D_{out}: D12.3 (DOUT), D13.1 (DIN)
/pixel12/D_{out}: D13.3 (DOUT), D14.1 (DIN)
/pixel13/D_{out}: D14.3 (DOUT), D15.1 (DIN)
/pixel14/D_{out}: D15.3 (DOUT), D16.1 (DIN)
/pixel15/D_{out}: D16.3 (DOUT), D17.1 (DIN)
/pixel16/D_{out}: D17.3 (DOUT), D18.1 (DIN)
/pixel17/D_{out}: D18.3 (DOUT), D19.1 (DIN)
/pixel18/D_{out}: D19.3 (DOUT), D20.1 (DIN)
/pixel19/D_{out}: D20.3 (DOUT), D21.1 (DIN)
/pixel20/D_{out}: D21.3 (DOUT), D22.1 (DIN)
/pixel21/D_{out}: D22.3 (DOUT), D23.1 (DIN)
/pixel22/D_{out}: D23.3 (DOUT), D24.1 (DIN)
/pixel23/D_{out}: D24.3 (DOUT), D25.1 (DIN)
/pixel24/D_{out}: D25.3 (DOUT), D26.1 (DIN)
/pixel25/D_{out}: D26.3 (DOUT), D27.1 (DIN)
/pixel26/D_{out}: D27.3 (DOUT), D28.1 (DIN)
/pixel27/D_{out}: D28.3 (DOUT), D29.1 (DIN)
/pixel28/D_{out}: D29.3 (DOUT), D30.1 (DIN)
/pixel29/D_{out}: D30.3 (DOUT), D31.1 (DIN)
/pixel30/D_{out}: D31.3 (DOUT), D32.1 (DIN)
/pixel31/D_{out}: D32.3 (DOUT), D33.1 (DIN)
/pixel32/D_{out}: D33.3 (DOUT), D34.1 (DIN)
/pixel33/D_{out}: D34.3 (DOUT), D35.1 (DIN)
/pixel34/D_{out}: D35.3 (DOUT), D36.1 (DIN)
/pixel35/D_{out}: D36.3 (DOUT), D37.1 (DIN)
/pixel36/D_{out}: D37.3 (DOUT), D38.1 (DIN)
/pixel37/D_{out}: D38.3 (DOUT)
GND: C2.2, C3.2, C4.2, C5.2, C6.2, C7.2, C8.2, C9.2, C10.2, C11.2, C12.2, C13.2, C14.2, C15.2, C16.2, C17.2, C18.2, C19.2, C20.2, C21.2, C22.2, C23.2, C24.2, C25.2, C26.2, C27.2, C28.2, C29.2, C30.2, C31.2, C32.2, C33.2, C34.2, C35.2, C36.2, C37.2, C38.2, D2.4 (VSS), D3.4 (VSS), D4.4 (VSS), D5.4 (VSS), D6.4 (VSS), D7.4 (VSS), D8.4 (VSS), D9.4 (VSS), D10.4 (VSS), D11.4 (VSS), D12.4 (VSS), D13.4 (VSS), D14.4 (VSS), D15.4 (VSS), D16.4 (VSS), D17.4 (VSS), D18.4 (VSS), D19.4 (VSS), D20.4 (VSS), D21.4 (VSS), D22.4 (VSS), D23.4 (VSS), D24.4 (VSS), D25.4 (VSS), D26.4 (VSS), D27.4 (VSS), D28.4 (VSS), D29.4 (VSS), D30.4 (VSS), D31.4 (VSS), D32.4 (VSS), D33.4 (VSS), D34.4 (VSS), D35.4 (VSS), D36.4 (VSS), D37.4 (VSS), D38.4 (VSS); also elsewhere on the board
VCC: C2.1, C3.1, C4.1, C5.1, C6.1, C7.1, C8.1, C9.1, C10.1, C11.1, C12.1, C13.1, C14.1, C15.1, C16.1, C17.1, C18.1, C19.1, C20.1, C21.1, C22.1, C23.1, C24.1, C25.1, C26.1, C27.1, C28.1, C29.1, C30.1, C31.1, C32.1, C33.1, C34.1, C35.1, C36.1, C37.1, C38.1, D2.2 (VDD), D3.2 (VDD), D4.2 (VDD), D5.2 (VDD), D6.2 (VDD), D7.2 (VDD), D8.2 (VDD), D9.2 (VDD), D10.2 (VDD), D11.2 (VDD), D12.2 (VDD), D13.2 (VDD), D14.2 (VDD), D15.2 (VDD), D16.2 (VDD), D17.2 (VDD), D18.2 (VDD), D19.2 (VDD), D20.2 (VDD), D21.2 (VDD), D22.2 (VDD), D23.2 (VDD), D24.2 (VDD), D25.2 (VDD), D26.2 (VDD), D27.2 (VDD), D28.2 (VDD), D29.2 (VDD), D30.2 (VDD), D31.2 (VDD), D32.2 (VDD), D33.2 (VDD), D34.2 (VDD), D35.2 (VDD), D36.2 (VDD), D37.2 (VDD), D38.2 (VDD); also elsewhere on the board

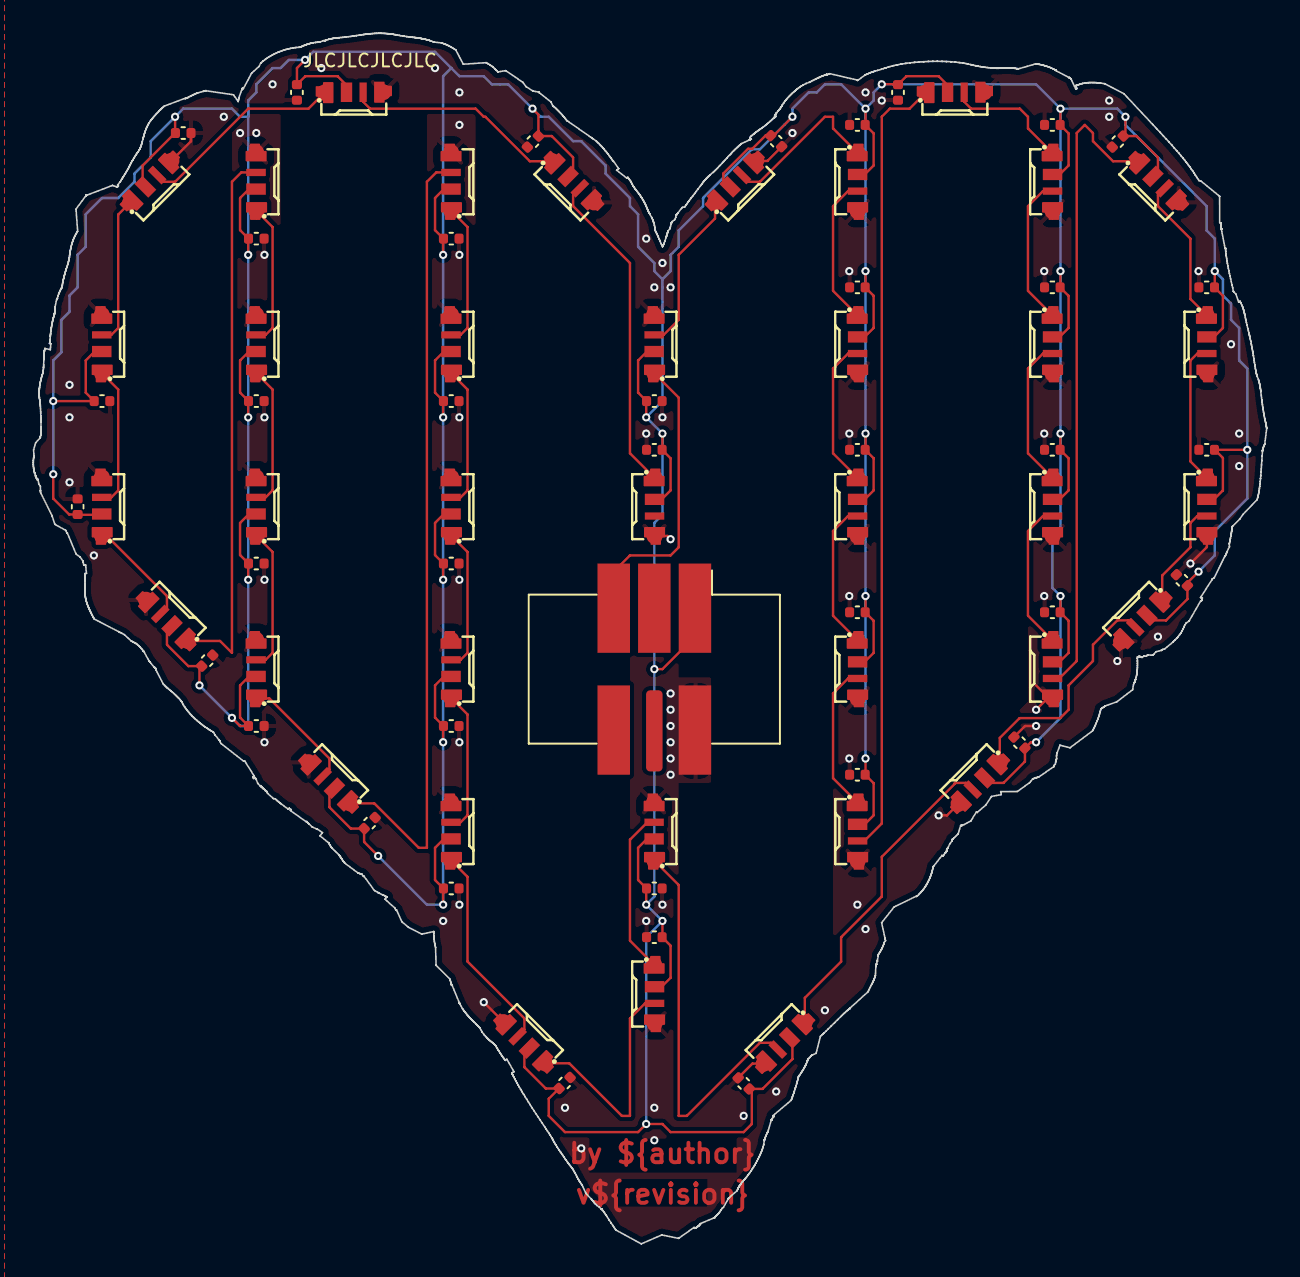
[picture p73: board geheimbadge.kicad_pcb from above]

Board: 2 copper layers, 75.9 x 74.5 mm, 77 parts (0 on the bottom side), 40 nets.
