Geheimorganisation/geheimbadge-hardware/source/geheimbadge-controller/geheimbadge-controller.kicad_pcb

## KiCad design source/geheimbadge-controller/geheimbadge-controller.kicad_pcb (2024-11-13)

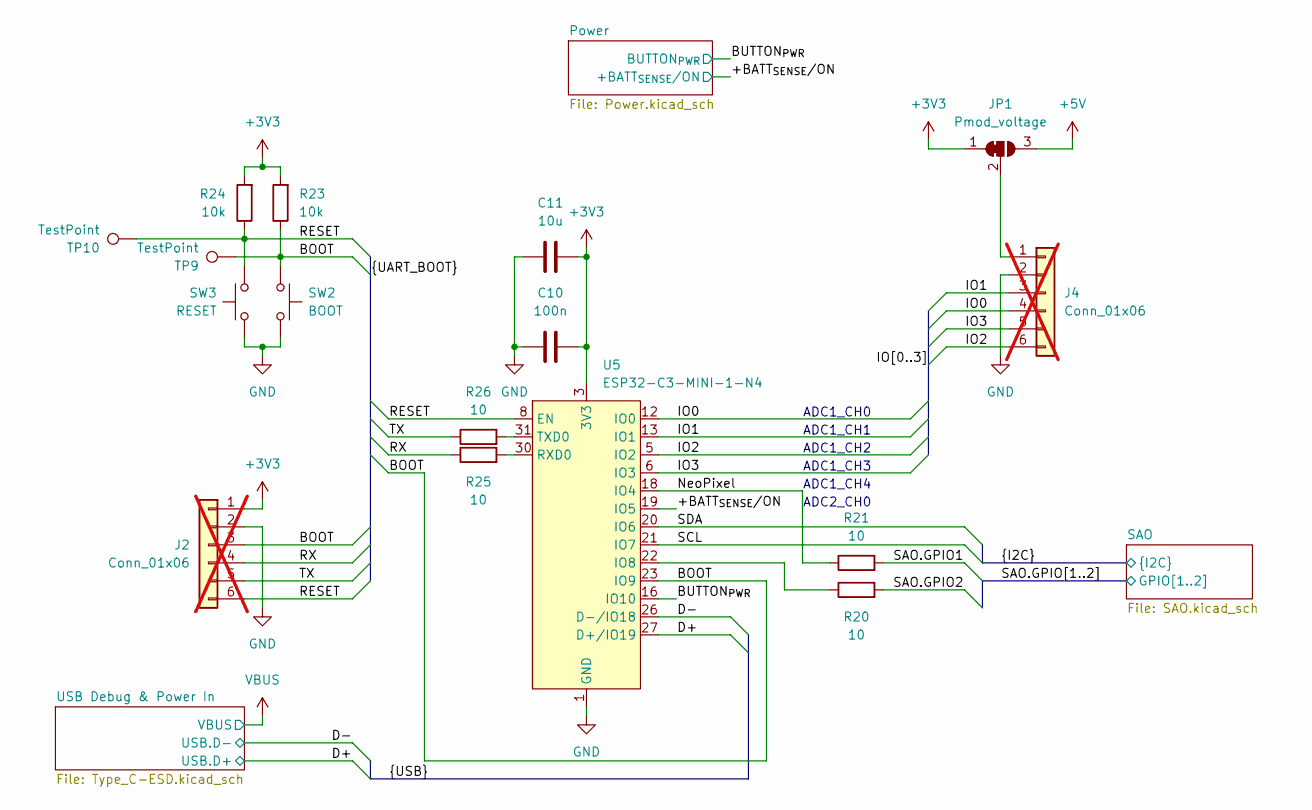
[picture p74: schematic geheimbadge-controller.kicad_sch, ${title}]

Parts:
C10: 100n; C_0603_1608Metric; LCSC Part C14663
C11: 10u; C_0805_2012Metric; LCSC Part C15850
J2, J4: Conn_01x06; PinSocket_1x06_P2.54mm_Horizontal; not fitted
JP1: Pmod_voltage; SolderJumper-3_P1.3mm_Bridged12_RoundedPad1.0x1.5mm
R20, R21, R25, R26: 10; R_0603_1608Metric; LCSC Part C22859
R23, R24: 10k; R_0603_1608Metric; LCSC Part C25804
SW2: BOOT; SW_Push_1P1T_XKB_TS-1187A; LCSC Part C318884
SW3: RESET; SW_Push_1P1T_XKB_TS-1187A; LCSC Part C318884
TP9, TP10: TestPoint; TestPoint_Pad_D1.0mm
U5: ESP32-C3-MINI-1-N4; WIFIM-SMD_ESP32-C3-MINI-1; LCSC Part C2838502

Connections:
+3V3: C10.1, C11.1, J2.1, JP1.1 (A), R23.2, R24.2, U5.3 (3V3); also elsewhere on the board
+5V: JP1.3 (B); also elsewhere on the board
/+BATT_{SENSE}/ON: U5.19 (IO5); also elsewhere on the board
/BOOT: J2.3, R23.1, SW2.2, TP9.1, U5.23 (IO9)
/BUTTON_{PWR}: U5.16 (IO10); also elsewhere on the board
/D+: U5.27 (D+/IO19); also elsewhere on the board
/D-: U5.26 (D-/IO18); also elsewhere on the board
/IO0: J4.4, U5.12 (IO0)
/IO1: J4.3, U5.13 (IO1)
/IO2: J4.6, U5.5 (IO2)
/IO3: J4.5, U5.6 (IO3)
/NeoPixel: R21.1, U5.18 (IO4)
/RESET: J2.6, R24.1, SW3.2, TP10.1, U5.8 (EN)
/RX: J2.4, R25.1
/SAO.GPIO1: R21.2; also elsewhere on the board
/SAO.GPIO2: R20.2; also elsewhere on the board
/SCL: U5.21 (IO7); also elsewhere on the board
/SDA: U5.20 (IO6); also elsewhere on the board
/TX: J2.5, R26.1
GND: C10.2, C11.2, J2.2, J4.2, SW2.1, SW3.1, U5.1 (GND), U5.2 (GND), U5.11 (GND), U5.14 (GND), U5.36 (GND), U5.37 (GND), U5.38 (GND), U5.39 (GND), U5.40 (GND), U5.41 (GND), U5.42 (GND), U5.43 (GND), U5.44 (GND), U5.45 (GND), U5.46 (GND), U5.47 (GND), U5.48 (GND), U5.49 (GND), U5.50 (GND), U5.51 (GND), U5.52 (GND), U5.53 (GND); also elsewhere on the board
unnamed: J4.1, JP1.2 (C)
unnamed: R20.1, U5.22 (IO8)
unnamed: R25.2, U5.30 (RXD0)
unnamed: R26.2, U5.31 (TXD0)

Notes on the sheet:
ADC2_CH0
ADC1_CH2
ADC1_CH1
ADC1_CH3
ADC1_CH0
ADC1_CH4

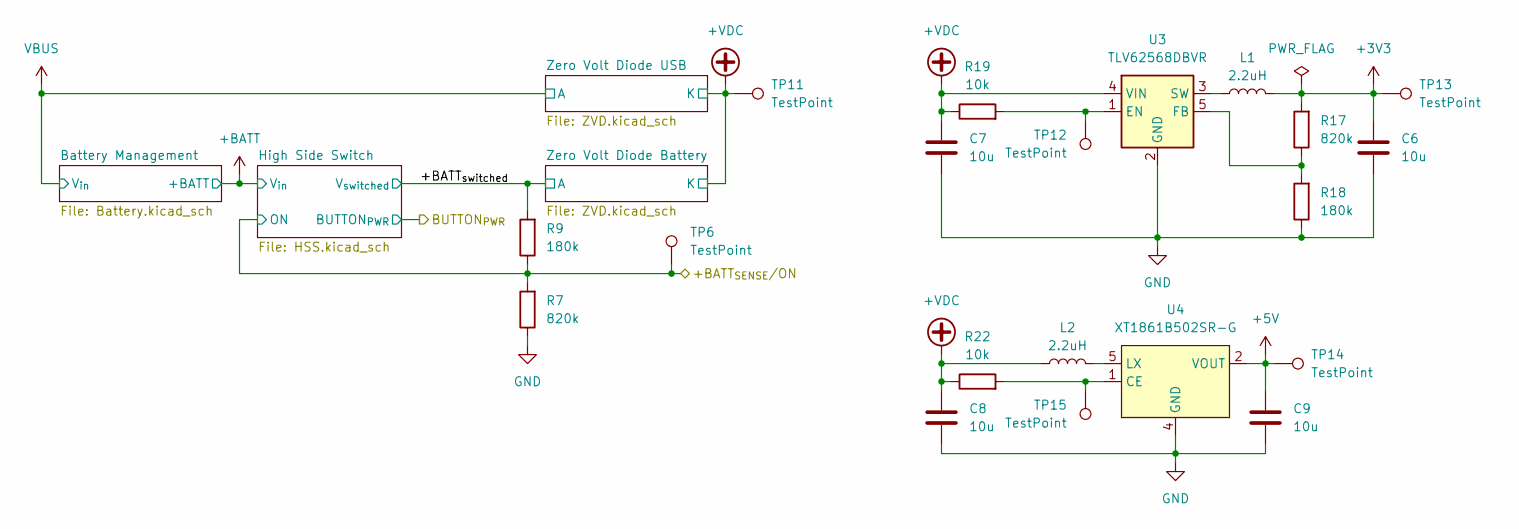
[picture p75: schematic Power.kicad_sch]

Parts:
C6, C7, C8, C9: 10u; C_0805_2012Metric; LCSC Part C15850
L1, L2: 2.2uH; L_1008_2520Metric; LCSC Part C3040393
R7, R17: 820k; R_0603_1608Metric; LCSC Part C23252
R9, R18: 180k; R_0603_1608Metric; LCSC Part C22827
R19, R22: 10k; R_0603_1608Metric; LCSC Part C25804
TP6, TP11, TP12, TP13, TP14, TP15: TestPoint; TestPoint_Pad_D1.0mm
U3: TLV62568DBVR; SOT-23-5; LCSC Part C163219
U4: XT1861B502SR-G; SOT-23-5; LCSC Part C3008013

Connections:
+3V3: C6.2, L1.2, R17.2, TP13.1; also elsewhere on the board
+5V: C9.2, TP14.1, U4.2 (VOUT); also elsewhere on the board
+VDC: C7.2, C8.2, L2.1, R19.1, R22.1, TP11.1, U3.4 (VIN); also elsewhere on the board
/+BATT_{SENSE}/ON: R7.2, R9.1, TP6.1; also elsewhere on the board
/Power/+BATT_{switched}: R9.2; also elsewhere on the board
GND: C6.1, C7.1, C8.1, C9.1, R7.1, R18.1, U3.2 (GND), U4.4 (GND); also elsewhere on the board
unnamed: R19.2, TP12.1, U3.1 (EN)
unnamed: R17.1, R18.2, U3.5 (FB)
unnamed: L1.1, U3.3 (SW)
unnamed: R22.2, TP15.1, U4.1 (CE)
unnamed: L2.2, U4.5 (LX)

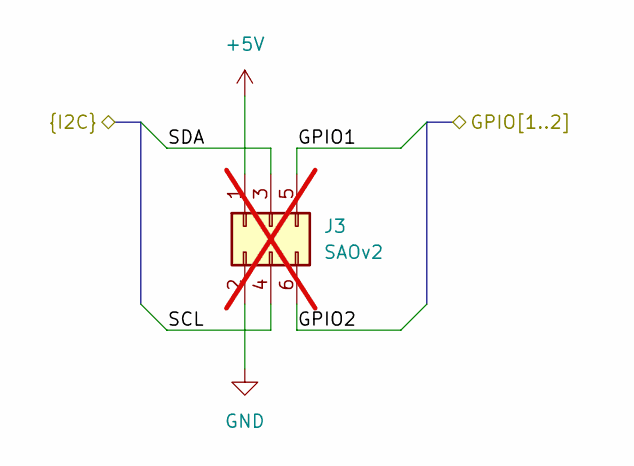
[picture p76: schematic SAO.kicad_sch]

Parts:
J3: SAOv2; PinSocket_2x03_P2.54mm_Vertical; LCSC Part C4749176; not fitted

Connections:
+5V: J3.1; also elsewhere on the board
/SAO.GPIO1: J3.5; also elsewhere on the board
/SAO.GPIO2: J3.6; also elsewhere on the board
/SCL: J3.4; also elsewhere on the board
/SDA: J3.3; also elsewhere on the board
GND: J3.2; also elsewhere on the board

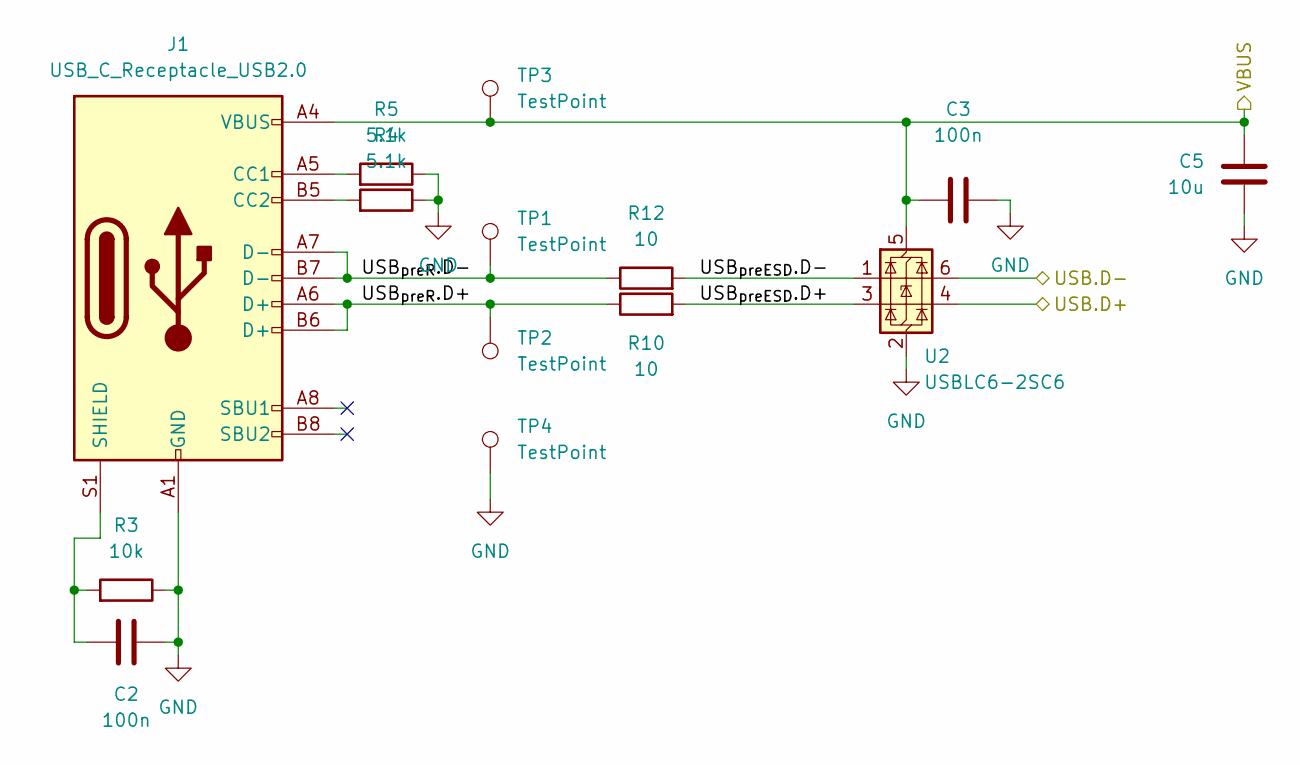
[picture p77: schematic Type_C-ESD.kicad_sch]

Parts:
C2, C3: 100n; C_0603_1608Metric; LCSC Part C14663
C5: 10u; C_0805_2012Metric; LCSC Part C15850
J1: USB_C_Receptacle_USB2.0; USB_C_Receptacle_HRO_TYPE-C-31-M-12; LCSC Part C2765186
R3: 10k; R_0603_1608Metric; LCSC Part C25804
R4, R5: 5.1k; R_0603_1608Metric; LCSC Part C23186
R10, R12: 10; R_0603_1608Metric; LCSC Part C22859
TP1, TP2, TP3, TP4: TestPoint; TestPoint_Pad_D1.0mm
U2: USBLC6-2SC6; SOT-23-6; LCSC Part C2827654

Connections:
/D+: U2.4 (I/O2); also elsewhere on the board
/D-: U2.6 (I/O1); also elsewhere on the board
/USB Debug & Power In/USB_{preESD}.D+: R10.2, U2.3 (I/O2)
/USB Debug & Power In/USB_{preESD}.D-: R12.2, U2.1 (I/O1)
/USB Debug & Power In/USB_{preR}.D+: J1.A6 (D+), J1.B6 (D+), R10.1, TP2.1
/USB Debug & Power In/USB_{preR}.D-: J1.A7 (D-), J1.B7 (D-), R12.1, TP1.1
GND: C2.2, C3.2, C5.1, J1.A1 (GND), J1.A12 (GND), J1.B1 (GND), J1.B12 (GND), R3.1, R4.1, R5.1, TP4.1, U2.2 (GND); also elsewhere on the board
unnamed: J1.A5 (CC1), R5.2
unnamed: J1.B5 (CC2), R4.2
unnamed: C2.1, J1.S1 (SHIELD), R3.2
VBUS: C3.1, C5.2, J1.A4 (VBUS), J1.A9 (VBUS), J1.B4 (VBUS), J1.B9 (VBUS), TP3.1, U2.5 (VBUS); also elsewhere on the board

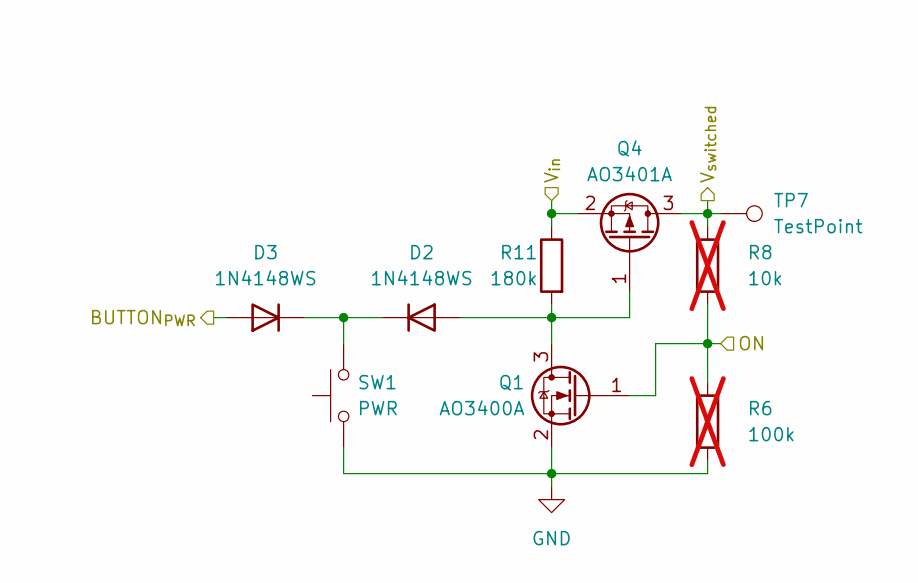
[picture p78: schematic HSS.kicad_sch]

Parts:
D2, D3: 1N4148WS; D_SOD-323; LCSC Part C2128
Q1: AO3400A; SOT-23; LCSC Part C20917
Q4: AO3401A; SOT-23; LCSC Part C15127
R6: 100k; R_0603_1608Metric; not fitted
R8: 10k; R_0603_1608Metric; not fitted
R11: 180k; R_0603_1608Metric; LCSC Part C22827
SW1: PWR; SW_Push_1P1T_XKB_TS-1187A; LCSC Part C318884
TP7: TestPoint; TestPoint_Pad_D1.0mm

Connections:
+BATT: Q4.2 (S), R11.1; also elsewhere on the board
/+BATT_{SENSE}/ON: Q1.1 (G), R6.1, R8.1; also elsewhere on the board
/BUTTON_{PWR}: D3.2 (A); also elsewhere on the board
/Power/+BATT_{switched}: Q4.3 (D), R8.2, TP7.1; also elsewhere on the board
GND: Q1.2 (S), R6.2, SW1.1; also elsewhere on the board
unnamed: D2.1 (K), D3.1 (K), SW1.2
unnamed: D2.2 (A), Q1.3 (D), Q4.1 (G), R11.2

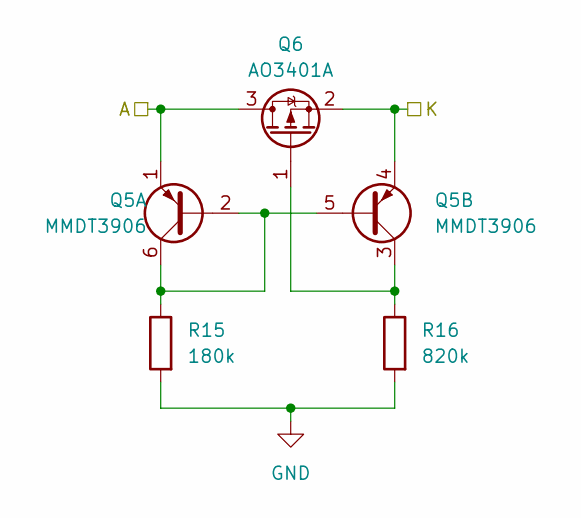
[picture p79: schematic ZVD.kicad_sch]

Parts:
Q5: MMDT3906; SOT-363_SC-70-6; LCSC Part C3000398
Q6: AO3401A; SOT-23; LCSC Part C15127
R15: 180k; R_0603_1608Metric; LCSC Part C22827
R16: 820k; R_0603_1608Metric; LCSC Part C23252

Connections:
+VDC: Q5.4 (E2), Q6.2 (S); also elsewhere on the board
/Power/+BATT_{switched}: Q5.1 (E1), Q6.3 (D); also elsewhere on the board
GND: R15.2, R16.2; also elsewhere on the board
unnamed: Q5.2 (B1), Q5.5 (B2), Q5.6 (C1), R15.1
unnamed: Q5.3 (C2), Q6.1 (G), R16.1

Parts of its further copies:
Q2: MMDT3906; SOT-363_SC-70-6; LCSC Part C3000398
Q3: AO3401A; SOT-23; LCSC Part C15127
R13: 180k; R_0603_1608Metric; LCSC Part C22827
R14: 820k; R_0603_1608Metric; LCSC Part C23252

Connections of its further copies:
+VDC: Q2.4 (E2), Q3.2 (S); also elsewhere on the board
GND: R13.2, R14.2; also elsewhere on the board
unnamed: Q2.2 (B1), Q2.5 (B2), Q2.6 (C1), R13.1
unnamed: Q2.3 (C2), Q3.1 (G), R14.1
VBUS: Q2.1 (E1), Q3.3 (D); also elsewhere on the board

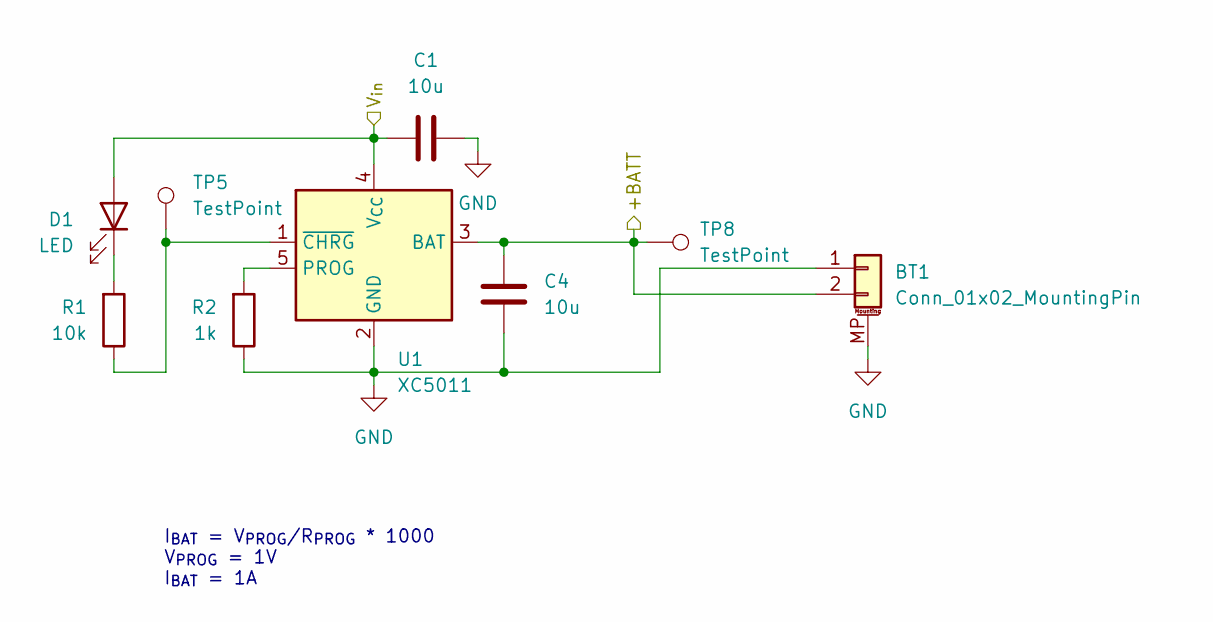
[picture p80: schematic Battery.kicad_sch]

Parts:
BT1: Conn_01x02_MountingPin; JST_PH_S2B-PH-SM4-TB_1x02-1MP_P2.00mm_Horizontal; LCSC Part C295747
C1, C4: 10u; C_0805_2012Metric; LCSC Part C15850
D1: LED; LED_0603_1608Metric; LCSC Part C2286
R1: 10k; R_0603_1608Metric; LCSC Part C25804
R2: 1k; R_0603_1608Metric; LCSC Part C21190
TP5, TP8: TestPoint; TestPoint_Pad_D1.0mm
U1: XC5011; TSOT-23-5; LCSC Part C669360

Connections:
+BATT: BT1.2, C4.2, TP8.1, U1.3 (BAT); also elsewhere on the board
GND: BT1.1, BT1.MP (MountPin), C1.1, C4.1, R2.1, U1.2 (GND); also elsewhere on the board
unnamed: D1.1 (K), R1.2
unnamed: R2.2, U1.5 (PROG)
unnamed: R1.1, TP5.1, U1.1 (~CHRG)
VBUS: C1.2, D1.2 (A), U1.4 (V_{CC}); also elsewhere on the board

Notes on the sheet:
I_{BAT} = V_{PROG}/R_{PROG} * 1000 V_{PROG} = 1V I_{BAT} = 1A

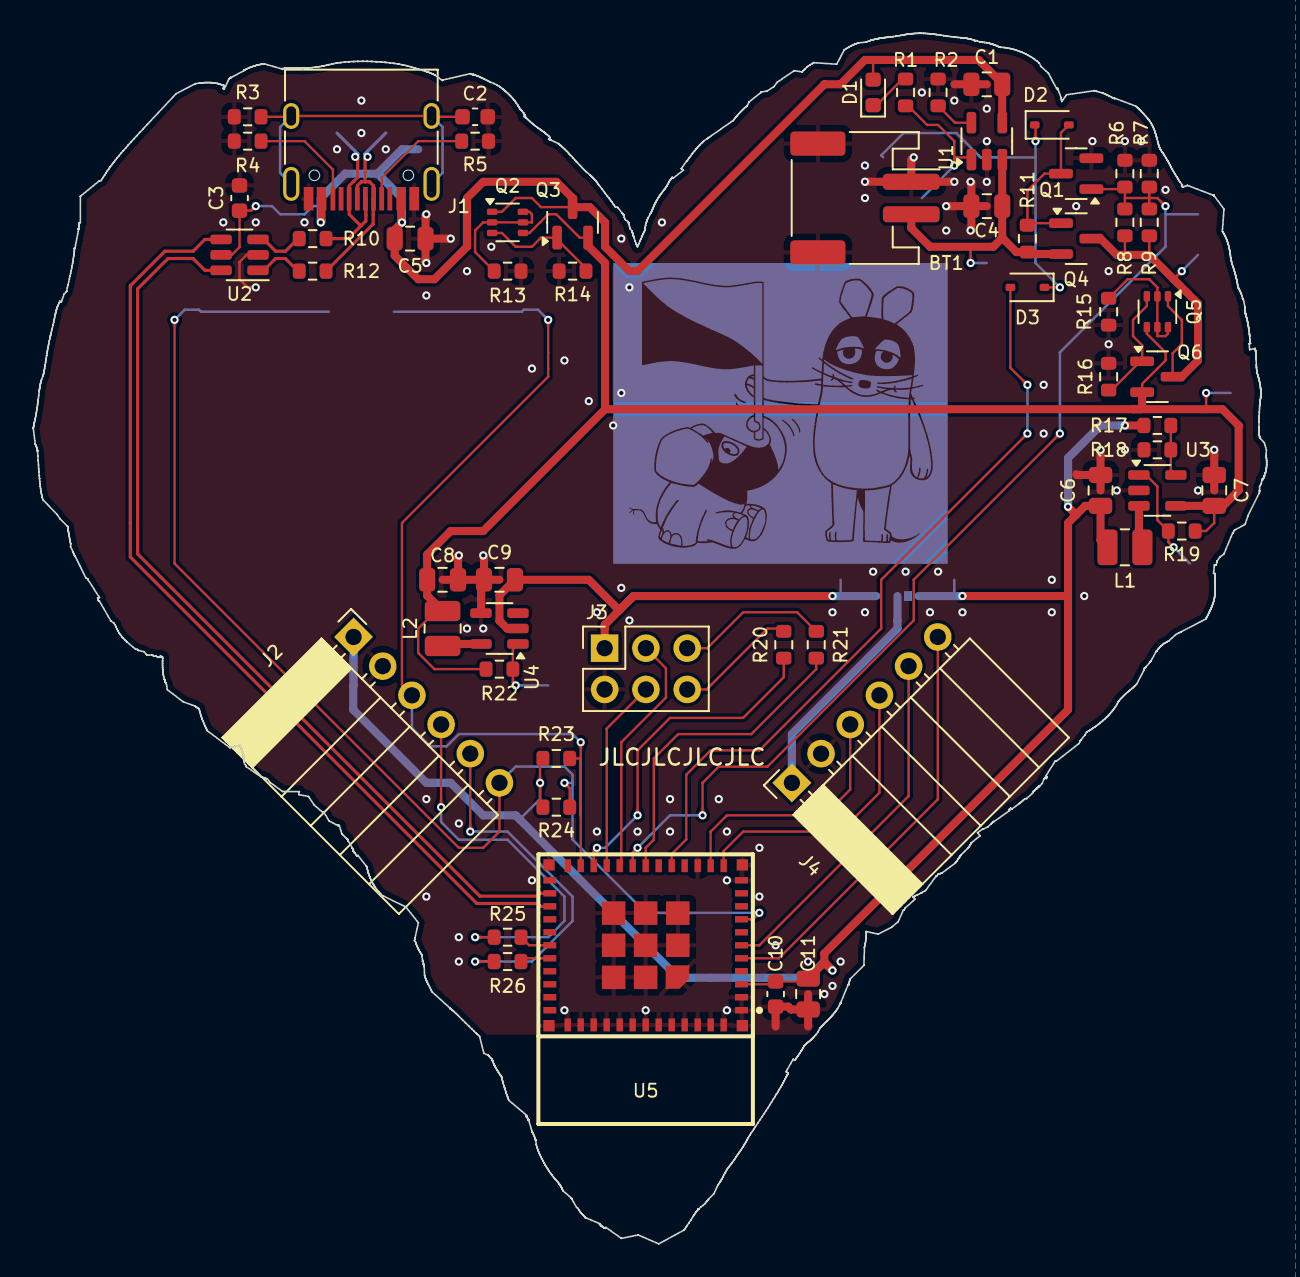
[picture p81: board geheimbadge-controller.kicad_pcb from above]

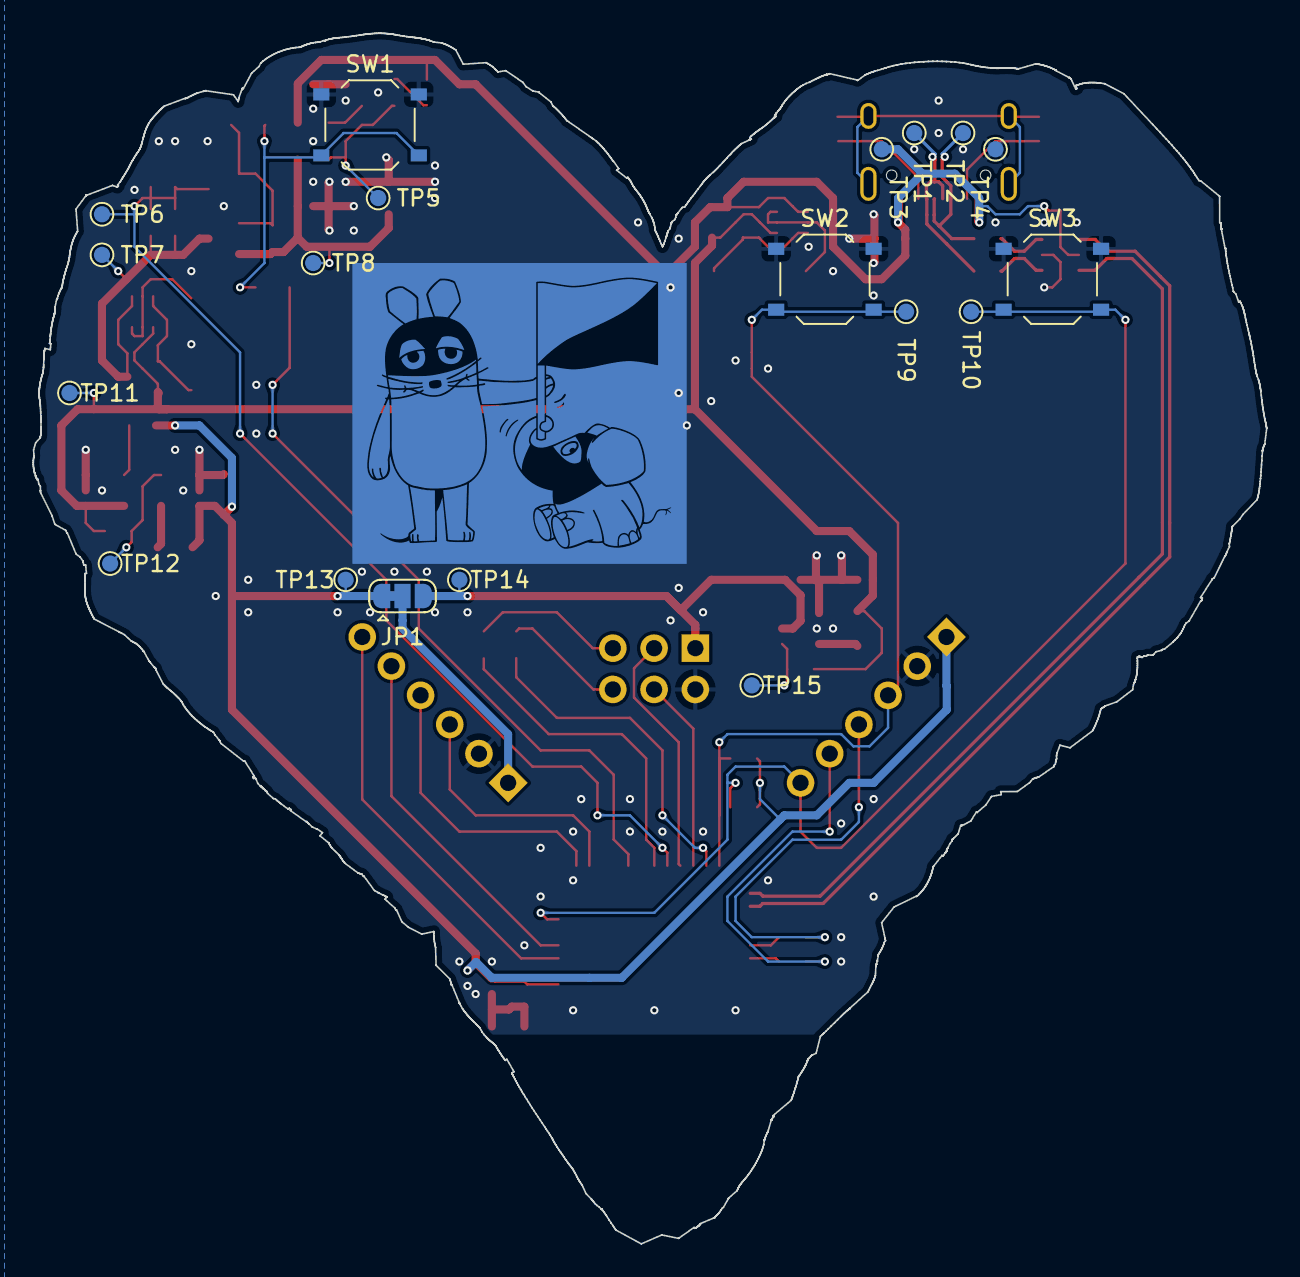
[picture p82: board geheimbadge-controller.kicad_pcb from below]

Board: 2 copper layers, 75.9 x 74.5 mm, 77 parts (19 on the bottom side), 49 nets.
