Geheimorganisation/geheimbadge-hardware/(commit log)

2023-10-01 initial design
    [LED-SMD_4P-L4.0-W1.6-L.obj, art.scad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]
2023-11-29 new led orientation; no signal resistors
    [geheimbadge-B.Cu.gbr, geheimbadge-B.Mask.gbr, geheimbadge-B.Paste.gbr, geheimbadge-B.SilkS.gbr, geheimbadge-Edge.Cuts.gbr, geheimbadge-F.Cu.gbr, geheimbadge-F.Mask.gbr, geheimbadge-F.SilkS.gbr]
2023-11-30 flipped board
    [geheimbadge-B.Cu.gbr, geheimbadge-B.Mask.gbr, geheimbadge-B.Paste.gbr, geheimbadge-B.SilkS.gbr, geheimbadge-Edge.Cuts.gbr, geheimbadge-F.Cu.gbr, geheimbadge-F.Mask.gbr, geheimbadge-F.Paste.gbr]
2024-11-13 finalized controller design
    [Battery.kicad_sch, HSS.kicad_sch, Power.kicad_sch, SAO.kicad_sch, Type_C-ESD.kicad_sch, ZVD.kicad_sch, art.scad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]
2024-12-10 finalized all designs
    [Battery.kicad_sch, HSS.kicad_sch, Power.kicad_sch, SAO.kicad_sch, Type_C-ESD.kicad_sch, ZVD.kicad_sch, art.scad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]
2024-12-30 add shell
    [art.scad, shell.stl]
2024-12-30 update pixel idices
    [geheimbadge.kicad_pcb]
